x1shang/Chariot_strom_of_gear/docs/logs/2026-10-18-n20-jog-100/README.md

# v3.3 N20 100% 占空比与启动门槛实测（2026-10-18）

固件与接线沿用 v3.3：`ChariotIntegrated-v3.3-JOG`，STBY=GPIO21、AIN1/2=25/26、GPIO22 断开，c23–d26 下拉器件仍取下未恢复。**串口端口已由 COM4 变为 COM9（CH340）**，以下点动均在 COM9 执行，参数统一为 `--milliseconds 150 --direction 1`、N20 脱离滑轨空载、用户在场逐次确认。

## 原始记录与有效性

| 目录 | 指令 | 供电 | 有效性 / 用户观察 |
| --- | --- | --- | --- |
| `powered-100-150ms/` | `JOG 1 150 100` | **未接动力**（用户事后确认） | **作废**：目录名 `powered` 为误标，只证明 PWM/使能链路 |
| `powered-100-300ms/` | `JOG 1 300 100` | **未接动力**（同上） | **作废** |
| `powered-100-150ms-rerun/` | `JOG 1 150 100` | 动力接通 | 有效：**转了／明显动了一下** |
| `powered-50-150ms/` | `JOG 1 150 50` | 动力接通 | 有效：**不动，也没有声音** |
| `powered-65-150ms/` | `JOG 1 150 65` | 动力接通 | 有效：**抖一下／时转时不转（临界）** |
| `powered-75-150ms/` | `JOG 1 150 75` | 动力接通 | 有效：**转了** |

## 结果

| 占空比 | LEDC 回读 | 实物反应 |
| --- | --- | --- |
| 50% | 128 | 不动、无声 |
| 65% | 166 | 抖动 / 时转时不转（临界） |
| 75% | 191 | 转 |
| 100% | 256 | 转 |

**启动门槛约在 65%~75%（150ms、空载、6V 显示值）。** 全部 6 轮遥测一致：`feed=1 TB3=1`、到时自动 `feed=0 TB3=0 N20pwm=0,0`、`fault=none`、`error=null`。

## 结论（相对此前记录的改变）

1. **N20 不是死故障**：TB3 的 A 通道输出、STBY 使能、PWM 通路、电机本体在 75%~100% 下都工作正常。
2. **故障定性改为「启动占空比不足」**：此前的 `FEED_PERCENT=30` 根本起不动电机，这不是硬件损坏。
3. **此前“30%/50%/70% 全部无动作”的三轮不可直接采信**：本轮已出现过一次“以为接了动力、实际只插 USB”的情况，那三轮是否真接了动力没有独立证据。但不影响结论方向——50% 在真正带电时确认不动。
4. **R1 对接默认参数必须上调**：`FEED_PERCENT=30、FEED_PULSE_MS=150` 在实物上不会产生任何动作。建议改为 75%（留到 100% 的余量），并考虑把 `FEED_PULSE_MS` 提到 200~250ms。

## 仍未验证

- TB3 的 **VM 端实际电压**、AO1/AO2 输出电平、电机电流——全部未测量；6V 仍只是降压板显示值。
- 带负载（弹匣对接、滑轨啮合）时 75% 是否仍能起转，未测。空载门槛不能当作带载门槛。
- 门槛随电池电压下降会升高；当前结论只在本次 6V 显示值下成立。
- 未测反向（`direction -1`）的启动门槛。

## 下一步

1. 改 `RobotConfig.h`：`FEED_PERCENT` 30 → 75（暂定），必要时 `FEED_PULSE_MS` 150 → 250，重编译并烧录，再用 R1 实按验证。
2. 带负载复测：滑轨/弹匣装上后，用 75% 与 100% 各试一次，确认不堵转、不丢步。
3. 量 VM 端电压；若明显低于 6V，则先解决供电再谈占空比。

复现脚本为 `host/jog_integrated_n20.py`。该脚本会产生电机动作：必须先按实际供电状态选择 `--power-state off` 或 `n20-only`，带电测试还必须确认空载；不要仅为重放日志执行。`physical-observation.json` 记录用户逐轮现场观察。
