x1shang/Chariot_strom_of_gear/docs/logs/2026-10-17-flywheel-three-shots/README.md

# 2026-10-17：双 130 摩擦飞轮连续三次小球试射成功

**100% 占空比、每次总时长 10 秒（含 1200ms 软启动）、极性参数 `1/1` 下，连续三次小球试射成功，均由用户逐次现场确认。** 三份运行日志均记录 10000ms 到时归零、无 FAULT/ERR，最终 STOP 状态两路 DUTY、四个方向脚及底盘 STBY 为 0。

导航：[仓库首页](../../../README.md) · [飞轮固件](../../../firmware/catapult/FlywheelSpinTest/README.md) · [接线](../../抛投装置-双130摩擦飞轮接线与GPIO分配.md) · [程序索引](../../测试程序索引-2026-10-17.md)

## 本次条件与已完成工作

| 项目 | 记录 |
|---|---|
| 源码基线 | `6e504aac2346005b745225fb824368e8452147e3`，固件、主机工具及测试源码在该提交中已存在；本次未改动控制算法 |
| 固件 / 目标 | `FlywheelSpin-v3-100` / `esp32:esp32:esp32` / Arduino-ESP32 3.3.12 |
| 实机 | ESP32-D0WD-V3 rev3.1，MAC `08:a6:f7:a8:95:94`，本次 USB-SERIAL CH340 为 COM4 |
| 电源与电机 | L298N + 两台 130 摩擦飞轮电机；用户报告供电为 6V，额定电压未知，供电测量位置及方法未记录 |
| 命令 | `DIR 1 1`、`SPIN 100 10000`；每次运行前准备 10 秒，1200ms 爬升计入 10 秒总时长 |
| 满输出行为 | 写入 255，两路外设回读 256；v3 修正了此时被误判为故障的问题 |
| 编译 / 主机检查 | 编译通过：程序 285779 字节、全局变量 22384 字节；主机仿真 161 项检查通过，配套 Python 脚本语法通过 |
| 烧录 / 启动 | COM4 上传返回 0，写入哈希校验通过；启动 `hw=1 used=0 dirs=0`，两路输出与底盘 STBY 均为 0 |
| 执行方式 | 每次上电最多运行一次；前两次运行前复位并验证未使用状态，第三次初始已为 `used=0 dirs=0`，没有额外复位 |

## 三次结果与原始证据

| 次数 | 串口结果 | 用户现场确认 | 证据 |
|---|---|---|---|
| 1 | 10000ms 到时归零，脚本返回 0，最终 STOP 零输出 | “成功，再来一次，确定可以复现” | [准备及复位](prepare-100-10s.txt)、[运行日志](spin-100-10s.txt) |
| 2 | 10000ms 到时归零，脚本返回 0，最终 STOP 零输出 | “这次也成功了，帮我记录连续两次试射成功。” | [准备及复位](prepare-100-10s-retest.txt)、[运行日志](spin-100-10s-retest.txt) |
| 3 | 10000ms 到时归零，脚本返回 0，最终 STOP 零输出 | “这次也成功了，帮我记录连续三次试射成功。” | [运行前检查](prepare-100-10s-third.txt)、[运行日志](spin-100-10s-third.txt) |

三次为独立的单次运行，**不是连续运转 30 秒**。现场确认与串口证据分别支持“小球射出”和“命令执行及到时归零”，不能互相代替。

## 构建、烧录和校验材料

- [编译结果](compile.txt)、[161 项主机仿真输出](host-tests.txt)。
- [上传及写入哈希校验](upload.txt)、[烧录后启动回读](idle-after-upload.txt)。
- [上传阶段校验记录](upload-verification.json)：`motion_issued=false` 仅指烧录/空闲回读阶段，不表示后续没有执行试射。
- [本次结果及 SHA-256 清单](verification.json)：关联固件、主机工具、测试源码与上述原始证据；只保存文本，不保存固件映像、目标文件或测试可执行文件。
- 本目录的 `.gitattributes` 为原始 `.txt` 和上传阶段 JSON 禁用换行转换，以便从 Git 仓库取出文件后仍能逐字节复验哈希；摘要文档及结果清单使用 LF。

## 前期现象与未测项

此前 30%、45% 及部分 80% 测试中，用户多次反馈只有一台转动，曾报告接线问题；后续 80% 测试报告“都转了”，再进入上述三次试射。未完成电机/线束/通道交叉定位，**不据后续成功认定唯一故障根因**。完整前期排查记录保留在本机，本次上传聚焦三次成功的直接证据。

- 射程、发射角、球尺寸/质量、转速、电机电流和温升未测量或未记录；没有试射视频。
- 实际电机端电压、供电动态压降、额定电压、轮毂固定强度及长期运行能力未验证。
- 参数 `1/1` 三次一致，但没有独立记录两台电机的实际旋转方向。
- 三次成功是本次样本结果，不推算长期成功率，也不作为全车、长期可靠性或安全验收。
- 飞轮固件全程禁用底盘，不含手柄行驶控制或全车运动互锁。

本次仅整理和提交上述实测成果，没有追加运行电机。
