x1shang/Chariot_strom_of_gear/docs/logs/2026-10-17-飞轮100上限重烧录/README.md

# 2026-10-17 飞轮测试：100% 上限版本重新烧录

用户反馈此前 30% / 3000ms 测试中未观察到转动；该次机械转动验收未通过。此前串口无 FAULT/ERR 只说明固件回读符合预期，不排除动力供电、驱动板、电机、接线或机械故障。

用户更正供电来自降压模块的 5V，接在 L298N 的 5V 端子，跳帽全部断开；烧录前明确确认动力已断开。5V 为逻辑电源，VS/+12V 动力端是否另外供电仍待确认。两只 130 电机的额定电压未知。

- 固件升级为 `FlywheelSpin-v2-100`，占空比硬上限从 60% 改为 100%，主机脚本同步更新版本与上限。
- 默认仍为 30% / 3000ms；保留 1200ms 软启动、上电静止、一次/上电、限时、STOP、回读互锁与底盘禁用。
- 仿真 156 次状态检查通过，新增覆盖 100% 软启动、持续使能、到时归零、满输出 STOP，以及拒绝 101%/256%。主机脚本语法检查通过。
- COM10 芯片确认 ESP32-D0WD-V3 rev3.1，Flash 4MB。Arduino CLI 编译并上传返回 0，写入哈希校验通过。
- 烧录后回报 `BOOT FlywheelSpin-v2-100; idle; duty cap 100%`；`hw=1 used=0 dirs=0 phase=IDLE DUTY1=0 DUTY2=0 IN1=0 IN2=0 IN3=0 IN4=0 STBY=0`。
- **本次没有发送 SPIN/DIR，没有进行新的机械转动测试。** 等待用户确认动力端接线及恢复供电后，再逐档测试。

证据：[软件检查](software-checks.txt)、[编译与烧录](compile-upload.txt)、[烧录后回读](idle-after-upload.txt)、[源码哈希](verification.json)。
