x1shang/Chariot_strom_of_gear/docs/logs/2026-10-17-双130飞轮转动测试/README.md

# 2026-10-17 双 130 摩擦飞轮转动测试：编译、烧录与两次 30% 空载转动

方案变更背景：用户报告上次的发射装置方案**已失败（扭矩太大，电机被撕裂）**，决定改用**原驱动板 L298N 驱动两个 130 电机摩擦飞轮**。旧方案 77 个文件已归档，见[旧方案归档](../../archive/2026-10-17-L298N-N20卷线抛投/README.md)与[失败记录](../2026-10-17-卷线方案失败-电机撕裂/README.md)。

源码：[FlywheelSpinTest](../../../firmware/catapult/FlywheelSpinTest/README.md) · 主机：[flywheel_spin_once.py](../../../host/flywheel_spin_once.py) · 接线：[双 130 摩擦飞轮接线与 GPIO 分配](../../抛投装置-双130摩擦飞轮接线与GPIO分配.md)

## 已完成

- **归档**：旧方案（L298N + 双 N20 卷线蓄力）的程序、主机脚本、仿真测试、接线文档与全部 2026-10-14 证据共 **70 个方案文件 + 7 个链接目标 = 77 个文件**逐字节快照归档，`manifest.json` 逐个 SHA-256 校验，**缺失 0、不一致 0**。
- **仿真测试**：`tests/test_flywheel_spin_firmware.cpp` 用真实固件源码在主机侧跑通 **146 项检查**（g++ `-std=c++17 -Wall -Wextra`，无警告），覆盖软启动斜坡、占空比/时长硬上限、两轮同占空比、每次上电一次、`STOP` 在爬升与保持阶段都优先、PWM 与引脚回读互锁、空闲使能被外部拉高时拒绝运行、计时回绕、上电静止。
- **编译**：Arduino-ESP32 **3.3.12** 编译成功，程序 285735 字节（21%）、静态内存 22384 字节（6%）；编译用的临时 ASCII 路径源码与仓库源码 **SHA-256 逐字节一致**（`7bfb1923…919ad009`）。
- **烧录**：COM10（芯片 ESP32-D0WD-V3 rev3.1、Flash 4MB、MAC `08:a6:f7:a8:95:94`）上传 rc=0，应用映像 285888 字节，四个写入段全部收到 esptool 的 `Hash of data verified`。
- **烧录后回读**：`BOOT FlywheelSpin-v1`，`hw=1 used=0 dirs=0 phase=IDLE DUTY1=0 DUTY2=0 IN1..IN4=0 STBY=0`。上电不自动运动。
- **一次转动测试**：`DIR 1 1` → 8 秒准备 → 仅发一次 `SPIN 30 3000`。串口记录 `START SPIN duty=30% raw=77 ms=3000 ramp=1200ms dirs=1,1`，随后爬升段 17 个采样（raw 3 → 72），`HOLD duty=30% raw=77 elapsed=1200`，运行期 `DUTY1=DUTY2=77`、`IN1=IN3=1`、`IN2=IN4=0`、`STBY=0`，最后 `DONE SPIN elapsed=3000 DUTY1=0 DUTY2=0`。收尾 `STOP`/`STATUS` 回读 `used=1 phase=STOPPED DUTY1=0 DUTY2=0 全部方向脚 0 STBY=0`，串口关闭，无重试、无自动重复。
- **第二次转动（重测）**：会话之外的操作以同参数重跑一次，结果一致，见下文「第二次转动」。

## 证据

- [软件检查（仿真 + 主机语法）](software-checks.txt)
- [编译](compile.txt) · [烧录与写入校验](upload.txt)
- [烧录后空闲回读](idle-after-upload.txt)
- [会话内那一次转动的原始串口记录](spin-once.txt)
- [第二次转动（重测）的原始串口记录](retest-spin-once.txt)
- [源码/映像哈希、GPIO 与 PWM 参数、执行摘要](verification.json)

## 第二次转动（重测，会话之外执行）

本目录另有一份 [retest-spin-once.txt](retest-spin-once.txt)（09:00 写入）：同固件、同参数（`d1=1 d2=1`、30% / 3000ms、8 秒准备）的**第二次**转动记录。它**不是本次会话发出的命令**（本次会话只发过 1 条 `SPIN`），是会话之外的操作重跑了同一脚本的产物；两次之间板子被手动复位过（重测开局回读 `used=0`）。核对结果：

- 无 `FAULT`、无 `ERR`、无异常退出。
- 爬升段 16 个采样，`DUTY1=DUTY2` 从 5 单调升到 73，随后 `HOLD` 在 raw 77（30%）保持 24 个采样。
- `DONE SPIN elapsed=3000 DUTY1=0 DUTY2=0`，全程 `DUTY1 == DUTY2`（0 处不一致）、`STBY=0`、方向脚为 `IN1=IN3=1`、`IN2=IN4=0`。
- 收尾 `STOP`/`STATUS` 回读 `used=1 phase=STOPPED`、两路占空比与方向脚全 0。

**这两次都只是电气输出与计时证据**：仍然没有证明电机已接线、已转动、两侧对转，也没有电流与温升数据。**两次合计共发出 2 条 `SPIN` 命令，每次都各自 "每次上电仅一次" 生效，中间靠复位重新授权。**

## 证据边界（不要把这些写成已确认）

- `DUTY1/DUTY2` 是 `ledcRead()` 的**外设（已命令占空比）回读**，**不证明引脚电平、电机端电压或实际电流**；方向脚与 STBY 才是真实引脚电平回读。
- 本次**没有测量**任何机械量：130 电机是否已接到 OUT1/OUT2 与 OUT3/OUT4、是否真的转动、转向、转速、两侧是否对转、飞轮是否装好、有无异响与振动，全部需要现场观察。
- 本次**没有测量电流与温升**。飞轮启动是惯性负载、起始电流大，L298N 每路 2A 只是直流绝对最大额定值；提高占空比前必须先限流并监视电流与散热片温度。
- `d1=1 d2=1` 是**实验值**：两侧飞轮必须反向旋转才算有效发射方向，这一点尚未观察确认，不能写成「顺时针/逆时针已确认」。
- 撤销使能是**滑行停止**：`DONE`/`STOP` 之后飞轮仍在惯性旋转，不是已经停转。
- 本方案**没有编码器，没有转速或位置反馈**；旧 FOC 方案的 90° 定位/自动返回不再适用。

## 板上当前状态

板上固件为 `FlywheelSpin-v1`：只支持 `STATUS` / `STOP` / `DIR <d1> <d2>` / `SPIN [duty] [ms]`，每次上电只允许一次转动，两路 EN 默认 0。**底盘在该固件下不行驶**（STBY 全程为低、不含手柄控制）；要恢复行驶需重新烧录底盘固件（[MecanumPS2Dpad](../../../firmware/chassis/MecanumPS2Dpad/README.md) 或 `tools/build-chassis.ps1`）。

## 下一步（需现场与仪表）

1. 记录两台 130 电机的铭牌与额定电压；确认动力分支电压是否仍用 12V。
2. 装配飞轮、轮毂（D 形/紧定/夹紧两处固定）、电机座防松与护罩。
3. 先分别单侧低速试转确认可转与转向，再确认两侧**对转**方向，记录极性。
4. 限流条件下逐级升速（30% → 45% → 60%），每级记录电流、温升、振动；超限则重新评估驱动板。
5. 第 3–4 步全部正常后再加球试射，按目标城墙高度与距离调整间隙/压入量与占空比上限。
