x1shang/Chariot_strom_of_gear/docs/logs/2026-10-14-restore-dpad/README.md

# 2026-10-14：恢复原 PS2 方向键底盘驱动

用户明确要求将原遥控小车源码重新烧录，并保存刚才的测试代码。

## 已完成

- 原`MecanumPS2Dpad`源码及两个头文件完整复制至英文临时路径进行编译，沿用`DRIVE_DUTY=255`、原GPIO和已校准轮向，未修改行驶代码。
- 实际固件仿真通过：方向键映射、GPIO极性、松键停机、松键重新就绪、圆圈/串口STOP、失效/超时帧、换向与计时回绕。
- Arduino-ESP32 3.3.12编译成功：程序284047字节、静态内存22440字节；应用映像284192字节。
- COM9上传成功，芯片ESP32-D0WD-V3 rev3.1、MAC 08:a6:f7:a8:95:94；esptool写入哈希验证成功。
- 启动回读确认`BOOT MecanumPS2Dpad`，随后`hw=1 ps=1 mode=73 buttons=0000 ready=1 STBY=0 duty=0,0,0,0`。只发送STOP/STATUS，无运动命令；串口已关闭。
- PS2信号诊断、2号顺时针3秒、2号逆时针10秒、双N20顺序测试及对应主机脚本/仿真代码全部保留在原目录。11个测试源文件的SHA-256在烧录前后核对一致。

当前板上为原方向键底盘固件，松开全部按键后就绪，方向键控制底盘，圆圈停止。L298N的ENA=14与ENB=27在初始化时保持低；不含N20抛投控制。此为启动/收包/静止验证，没有新增带载运动验收。

## 保存的测试代码

完整入口：[测试程序保留索引](../../测试程序索引-2026-10-14.md)。源码在各自独立目录中，相关日志保留原始内容；临时构建产物可重新生成。

证据：[编译](compile.txt) · [上传](upload.txt) · [启动回读](startup.txt) · [原驱动/测试源码与映像哈希清单](verification.json)

[原驱动说明](../../../firmware/chassis/MecanumPS2Dpad/README.md) · [仓库总入口](../../../README.md)
