x1shang/Chariot_strom_of_gear/docs/排位赛战绩与小组赛备赛-2026-10-20.md

# 排位赛战绩与小组赛备赛（齿轮风暴队 · 80 号）

> 2026 新生机械赛 · 排位赛 2026-10-17/18 · 小组赛 2026-10-25
> 记录时间：2026-10-20

## 一、结果

**109 队参赛，前 64 队进小组赛；齿轮风暴队（80 号）以 190 分排第 43 名，晋级 64 强，分入 K 组。**

| 项 | 数据 |
| --- | --- |
| 排位赛总分 | 190 分（两次上场，各 3 分钟，取两次之和） |
| 排名 | 43 / 109 |
| 得分构成 | 中央区及甬道 180 分；其余 10 分仍是地面球；**高空投石 0 分** |
| 小组赛 | K 组 · 10-25（周日）10:20–11:10 · 场地 1 |
| 同组 | 14 啊对对对队 1415（#11）· 68 交虫战队 790（#22）· 16 感觉很队 120（#54） |

同分对照：与 66 号机机队同为 190 分，靠“中央区及甬道 180 > 150”排在前面。

## 二、现场发现

1. **射速不够**：单位时间出球数上不去，6 球一轮的节奏撑不起 5 分钟对抗。
2. **高程不够**：黄球过不了 600 mm 中央城墙，落不进外城（30）/内城（50）/瞭望塔（70），只能靠地面穿孔拿 10 分/球。

**现场处置**：直接垫木片抬高发射角 + 加大电压提高飞轮转速。分数仍以地面球为主，说明“抬高 + 加压”只把弹道往上推了一点，还没到能稳定过墙的量级（效果未量化，待复测）。

## 三、下一步计划

| # | 动作 | 目的 | 验收指标 |
| --- | --- | --- | --- |
| 1 | 更换电机 | 提高飞轮线速度 | 同电压下球速↑、过墙率↑ |
| 2 | L298N ↔ TB6612 对调 | L298N 有 1.8–3 V 固定压降；飞轮改由压降更小的 TB6612 驱动，把电压真正加到电机上。**注意：底盘是 4 路独立（2×TB6612），L298N 只有 2 路，整块互换不成立**；实际做法是飞轮单独用一块 TB6612、L298N 退役 | 电机端电压实测；同占空比下的球速对比 |
| 3 | 继续垫高平台 | 增大发射角 | 分角度测过墙率与落点分布 |

三项都指向同一件事：**让黄球过墙**。黄球只要进外城就是 30 分/球，效率是地面球的 3 倍。

按排位赛效率粗算：14 号 6 分钟拿 1415 分（约 236 分/分钟），5 分钟对抗即使打折也是 700–1000 分级别。我们纯地面球（10 分/球）要 70–100 球才追平，靠黄球进外城（30 分/球）只要 25–35 球；而每轮最多只让带 3 个黄球，所以**“过墙率 × 循环次数”就是全部**。

改法上建议**一次只动一个变量**：先电压 + 角度（不动机械）测过墙率 → 再换电机 → 最后继续调平台高度；否则过墙率上去了也说不清是哪一项的功劳。

## 四、红线（车检 / 规则）

- 电路任意两点电压 ≤ **12 V**；小球出射速度 ≤ **15 m/s**。
- 静态尺寸 ≤ 400×400×**350** mm，动态 ≤ 500×500×450 mm；**垫高平台会先顶到 350 mm 静态高度，改完先量再上车检**。
- 整车 ≤ 3 kg；飞轮启动电流接近堵转电流，TB6612 单路连续 1.2 A，注意限流与散热。

## 五、K 组形势

| 编号 | 队伍 | 排位分 | 排名 |
| --- | --- | --- | --- |
| 14 | 啊对对对队 | 1415 | 11 |
| 68 | 交虫战队 | 790 | 22 |
| **80** | **齿轮风暴队（我们）** | **190** | **43** |
| 16 | 感觉很队 | 120 | 54 |

赛程（10-25，场地 1，单循环 6 场）：

| 时间 | 对阵 |
| --- | --- |
| 10:20 | 14 vs 16 |
| 10:30 | 68 vs **80** |
| 10:40 | 14 vs **80** |
| 10:50 | 16 vs 68 |
| 11:00 | 14 vs 68 |
| 11:10 | **80** vs 16 |

- 每组只有**第一名**进淘汰赛（16 组 → 16 队）。14 是组内头号种子，**10:40 对 14 基本就是出线生死战**。
- 三场在 50 分钟内打完：电池、备件、快修按“连续三场”准备。
- 侦察窗口：10:20 可先看 14 打 16；10:50、11:00 可看 16 和 68。我们自己的 10:30 那场之前没有 68 的现场情报。

## 六、备赛清单（按优先级）

1. **黄球过墙率（最高优先）**：在真实 600 mm 墙、真实距离下打 20 发记落点，目标外城命中 ≥ 50%。
2. **6 球循环时间**：回填区出发 → 6 球打完 → 回填，目标 ≤ 25 s；按 5 分钟 10–12 轮估总分。
3. **地面球保底**：正门 120×180、侧门 80×140（甬道），10–15 分/球，作为下限分。
4. **防守**：回填间隙把车停在己方正门前挡地面球；黄球落进己方城内/塔上拦不住，只能压缩对方出手次数。
5. **稳定性**：连续三场不烧板、不掉线、不松轮；带备用 130 电机、飞轮、驱动板、电池。
6. **车检预演**：尺寸、重量、电压、球速、走线，按手册 3.7 节逐条过。

## 七、备注

- 排位赛成绩表**未改动**：核对后名单与成绩都是 109 队、编号 1–109 一一对应，没有“多出来的 3 队”，因此没有追加“未通过车检”行（按确认跳过）。
- `排位赛名单及时间表(1).xlsx` 已按要求移入回收站。
- 数据来源：`排位赛比赛成绩.xlsx`、`小组赛时间表.xlsx`、`2026新生机械赛赛事手册.pdf`。
