x1shang/Chariot_strom_of_gear/docs/整合程序v3-R1对接器-2026-10-18.md

# 整合程序v3：R2飞轮、R1定时N20对接器，无舵机

> **当前程序为ChariotIntegrated-v3.1-R1。** v3.0的USB静止检查通过后，实际按上方向键触发drive frequency故障。v3.1改为直接查询LEDC实际定时器，保留频率异常停机，并增加持久故障原因。最新证据见[遥控响应记录](logs/2026-10-18-controller-response/README.md)，本文末尾的v3.0静止检查作为历史保留。

日期：2026-10-18。用户报告已完成改接线，并要求烧录完整版；已明确确认全部电机动力断开、ESP32仅接USB，外部5V到ESP32正极已隔离。用户选择R1“点按后运行固定时间”，当前没有舵机。

## 仓库同步与阅读

已实际执行`git fetch origin master`及`git pull --ff-only --autostash origin master`，本地从19105db快进到9a11db22ac06d6c2f64c0cb23fb420198a7165ef，HEAD与origin/master一致。原有修改自动恢复；拉取前两份本地文档另有备份，未覆盖既有未跟踪整合代码。这是烧录前的拉取基线；本页不作为后续推送状态记录。

已阅读现行双130接线、底盘两线法、全车供电索引、逐根改接线说明、v2对齐说明，以及本次pull得到的MecanumPS2Flywheel代码和README。原仓库的MecanumPS2Flywheel-v2仍使用六根飞轮信号，不能直接烧到当前合并双EN的新接线上。

当前入口是`firmware/robot/ChariotIntegrated/ChariotIntegrated.ino`，版本`ChariotIntegrated-v3.1-R1`。DpadControl.h和DriveMath.h继续与当前远程底盘/转向基线逐字节对齐。

## 当前操作

| 操作 | 行为 |
|---|---|
| 松开所有按键，右摇杆回中，连续5帧 | 自动ready/armed，不需要START |
| 方向键 | 前后、横移、斜移，保留原轮向、100%目标、加速斜坡和300ms换向等待 |
| 右摇杆横轴 | 比例转向，可与方向键叠加；中位128、死区±20 |
| 按住R2 | 双130从0经1200ms爬升至100%，最多10秒；可与驾驶并行 |
| 松开R2 | 撤销飞轮输出，飞轮惯性滑行；若N20此次动作在飞轮运行时启动，也一并撤销 |
| 停车后点按R1 | N20按配置方向输出150ms、30%占空比，松开R1仍运行到时限；无需先按R2 |
| 一直按住R1 | 只触发一次，不连发；上次停止后至少800ms，再次松开并点按才接受 |
| 飞轮已运行时点R1 | 必须已预转2500ms；预转未完成或车辆在行驶时拒绝，不排队 |
| N20动作中出现驾驶输入 | 所有电机停止并锁定，须重新松键回中 |
| 圆圈或串口STOP | 全部电机撤销输出并锁定，重新松键回中后就绪 |
| 无效手柄帧、150ms无有效帧 | 全部电机撤销输出并锁定 |
| SELECT、L1、叉 | 本版不控制机构；GPIO27不输出舵机脉冲，SERVO ON也被拒绝 |

R1是定时动作，不是到位控制；150ms和30%是原配置的调试初值，不能保证滑轨完成对接。需现场确认方向和行程，调整RobotConfig.h的FEED_POLARITY、FEED_PULSE_MS、FEED_PERCENT，再编译烧录；手柄脉冲不得超过FEED_JOG_MAX_MS（当前500ms）。未实现到位传感器或卡滞检测。

## 与本次实际接线的对应

| 功能 | 接线 |
|---|---|
| 双飞轮使能 | GPIO14经第20排分到L298N ENA和ENB；两个EN跳帽取下 |
| 使能默认关闭 | 第20排b20经一只10kΩ到第26排e26；合并EN共用下拉即可 |
| 飞轮方向 | L298N IN1/IN3接ESP32同源3V3；IN2/IN4接GND |
| N20方向与使能 | GPIO25/26/22分别接TB3 AIN1/AIN2/STBY；STBY有另一只10kΩ下拉 |
| N20逻辑与输出 | TB3 VCC/PWMA=3V3；BIN1/BIN2/PWMB=GND；AO1/AO2接N20 |
| 地线 | 第26排左右侧各从ESP32 GND引入；TB3和L298N功率GND各自直接回降压板GND，不经面包板 |
| L298N逻辑电源 | 5V-EN取下，外部降压板5V-OUT接L298N 5V |
| 动力接线状态 | 用户报告TB3 VM已接VADJ-OUT、L298N动力正极已按原位置恢复；本次烧录时全部动力断开 |
| 舵机 | 未安装，GPIO27留空或仅保留a24引线；SERVO_INSTALLED=false |
| 保留脚 | GPIO21不用；底盘和PS2接法保持原样 |

电机线重新插接过，两台130是否相向送球、N20是否向对接方向运动均需重新点动核对。程序状态、PWM占空比和150ms到时均不代表实测电压、电流、转速、温升或机械到位。N20具体型号及VADJ实际电压仍未取得仪器/铭牌记录。

## 烧录和检查范围（以下v3.0初始化修复为历史记录）

本次先执行主机回归和Arduino-ESP32 3.3.12实际编译。烧录前后记录源码/二进制哈希；只在用户确认动力断开、ESP32仅接USB后操作COM4。启动检查脚本`host/verify_integrated_after_upload.py`只发送STOP与STATUS，不发送任何动作命令。

首次启动发现hw=0：原初始化代码在零占空比时检查ledcReadFreq，但本机3.3.12的esp32-hal-ledc.c第408–417行明确在占空比为0时返回频率0，导致误判。已保留失败日志，修正为初始化检查attach、写0成功与占空比回读0；只在用户请求非零输出时检查频率。主机stub也改为同样的零占空比返回行为，并覆盖运行期错误频率时停机的情况。初始化不为测频而产生非零脉冲。

实际结果见[本次记录](logs/2026-10-18-integrated-r1/README.md)。旧v1/v2日志和桌面ZIP保留其原版本含义，不能当本版烧录证据。

## v3.1当前结果

681项主机检查、实际编译、写入校验及USB启动通过。随后断动力采样确认方向键/左右转向输入；底盘有动力且四轮架空采样无故障，用户确认“四轮都有响应，松开后停止”。最后STOP回读全部电机输出为0。130和N20本轮动力保持断开，没有完成它们的实物动作验收。完整证据与当前源码哈希见[最新记录](logs/2026-10-18-controller-response/README.md)。
