x1shang/Chariot_strom_of_gear/docs/测试程序索引-2026-10-17.md

# 2026-10-17 测试程序索引：130 摩擦飞轮方案

**方案变更（2026-10-17）**：用户报告上次的发射装置方案（L298N + 双 N20 卷线蓄力）**已失败，原因是扭矩太大、电机被撕裂**，决定改用**原驱动板 L298N 驱动两个 130 电机摩擦飞轮**，新写一则测试飞轮转动的程序并烧录。旧方案的全部测试程序已逐字节归档，见[旧方案归档](archive/2026-10-17-L298N-N20卷线抛投/README.md)（70 个方案文件 + 7 个链接目标 = 77 个文件，逐个 SHA-256 校验：缺失 0、不一致 0）。

上一版索引（2026-10-14，含旧方案程序清单）保留原文并已随批归档：[测试程序索引-2026-10-14](测试程序索引-2026-10-14.md) · [归档快照](archive/2026-10-17-L298N-N20卷线抛投/snapshot/docs/测试程序索引-2026-10-14.md)。

导航：[仓库总入口](../README.md) · [双 130 摩擦飞轮接线与 GPIO 分配](抛投装置-双130摩擦飞轮接线与GPIO分配.md) · [卷线方案失败记录](logs/2026-10-17-卷线方案失败-电机撕裂/README.md)

## 1. 当前测试程序（新方案）

| 测试程序 | 行为 | 记录 |
|---|---|---|
| [FlywheelSpinTest](../firmware/catapult/FlywheelSpinTest/README.md) | 当前 v3：两侧 130 飞轮同时软启动到指定占空比（1–100%，默认 30%），总时长≤10000ms（含1200ms爬升），到时或 `STOP` 撤销两路 EN；每次上电仅一次；**底盘不行驶** | [100% / 10秒连续三次试射成功](logs/2026-10-17-flywheel-three-shots/README.md)（用户逐次确认）；[此前重烧录](logs/2026-10-17-飞轮100上限重烧录/README.md)为历史 |

- 主机脚本：[`host/flywheel_spin_once.py`](../host/flywheel_spin_once.py)（执行前核对状态、只发一次、退出必发 `STOP`、不重试、全程留日志）。
- 仿真测试：[`tests/test_flywheel_spin_firmware.cpp`](../tests/test_flywheel_spin_firmware.cpp)（本机 **161 项检查通过**，含写入 255 / 满输出回读 256 的回归验证，见[原始输出](logs/2026-10-17-flywheel-three-shots/host-tests.txt)）。
- 测试桩变更：`tests/firmware-stubs/Arduino.h` 新增 `ledcRead`，用于固件的 PWM 占空比回读检查。

## 2. 已归档的旧方案测试程序（2026-10-14，停用）

以下程序源码**保留在原目录**用于追溯，模块 README 已标注停用；归档目录另有逐字节快照。

| 测试程序（快照） | 行为 | 记录（快照） |
|---|---|---|
| [N20Motor2DirectionCheck](archive/2026-10-17-L298N-N20卷线抛投/snapshot/firmware/catapult/N20Motor2DirectionCheck/README.md) | 仅2号顺时针3秒；1号和底盘禁用 | [3秒与重复测试](archive/2026-10-17-L298N-N20卷线抛投/snapshot/docs/logs/2026-10-14-n20-motor2-check/README.md) |
| [N20Motor2Reverse10s](archive/2026-10-17-L298N-N20卷线抛投/snapshot/firmware/catapult/N20Motor2Reverse10s/README.md) | 仅2号逆时针10秒；1号和底盘禁用 | [10秒测试](archive/2026-10-17-L298N-N20卷线抛投/snapshot/docs/logs/2026-10-14-n20-motor2-ccw10s/README.md) |
| [N20SequenceTest](archive/2026-10-17-L298N-N20卷线抛投/snapshot/firmware/catapult/N20SequenceTest/README.md) | 2号3秒→1号0.5秒；旧机构的两阶段「蓄力→释放」 | [顺序测试](archive/2026-10-17-L298N-N20卷线抛投/snapshot/docs/logs/2026-10-14-n20-sequence-test/README.md) |
| [PS2SignalCheck](archive/2026-10-17-L298N-N20卷线抛投/snapshot/firmware/chassis/PS2SignalCheck/README.md) | 仅读遥控器帧/按键，所有电机禁用（**通用诊断，未停用**） | [信号检查](archive/2026-10-17-L298N-N20卷线抛投/snapshot/docs/logs/2026-10-14-ps2-signal-check/README.md) |

旧主机脚本（归档快照）：[2号顺时针单次](archive/2026-10-17-L298N-N20卷线抛投/snapshot/host/motor2_forward_once.py)、[2号逆时针单次](archive/2026-10-17-L298N-N20卷线抛投/snapshot/host/motor2_counterclockwise_once.py)、[双电机顺序单次](archive/2026-10-17-L298N-N20卷线抛投/snapshot/host/n20_sequence_once.py)。旧仿真测试（归档快照）：[2号顺时针](archive/2026-10-17-L298N-N20卷线抛投/snapshot/tests/test_n20_motor2_firmware.cpp)、[2号逆时针](archive/2026-10-17-L298N-N20卷线抛投/snapshot/tests/test_n20_motor2_reverse_firmware.cpp)、[顺序控制](archive/2026-10-17-L298N-N20卷线抛投/snapshot/tests/test_n20_sequence_firmware.cpp)、[遥控信号](archive/2026-10-17-L298N-N20卷线抛投/snapshot/tests/test_ps2_signal_check.cpp)。

## 3. 没有归档的部分（仍在使用）

- 底盘固件与诊断：`firmware/chassis/MecanumPS2Dpad`、`MecanumPS2*Diagnostic`、`TB6612LogicCheck`、`PS2SignalCheck`（后者另有归档快照，原目录继续维护）。
- 底盘主机脚本与诊断记录：`host/` 下非抛投脚本、`docs/diagnostics/`、`docs/logs/2026-10-14-controller-wheel-check/`、`docs/logs/2026-10-07*`。
- 旧 FOC 方案（DRV8313/AS5600）：更早已归档，见[2026-10-14 归档](archive/2026-10-14-DRV8313-AS5600/README.md)。

## 4. 板上的固件

板上当前为 `FlywheelSpin-v3-100`（本次端口 COM4，上限 100%）。它**只支持飞轮测试**，底盘不行驶；要恢复行驶需重新烧录底盘固件（[MecanumPS2Dpad](../firmware/chassis/MecanumPS2Dpad/README.md)）。本次编译、烧录及回读通过，随后完成三次 100% / 10 秒运行，用户逐次确认小球试射成功；源文件、主机脚本及证据哈希见[本次清单](logs/2026-10-17-flywheel-three-shots/verification.json)。

## 5. 结论

- 旧方案的测试程序、主机脚本、仿真测试、接线文档与全部 2026-10-14 证据已完整入档，且哈希可复验（77 个文件，缺失 0、不一致 0；其中 7 个是为保持快照内链接可读而保存的链接目标）。
- 当前 v3 完成 **100% / 10 秒连续三次小球试射成功（用户现场确认）**，三次日志均无 FAULT/ERR 且输出到时归零。射程、独立转向、转速、电流/温升、装配强度及长期可靠性仍未测量，详见[本次记录](logs/2026-10-17-flywheel-three-shots/README.md)。早期 30% 测试及单台不转现象作为历史保留，不据本次成功推断其唯一根因。
