x1shang/Chariot_strom_of_gear/docs/测试程序索引-2026-10-14.md

# 2026-10-14 测试程序保留索引

恢复原 PS2 方向键底盘驱动时，以下测试源码、主机脚本、仿真测试与日志继续保留，可按需重新编译烧录。恢复驱动不删除测试代码，也不将其合并到行驶固件中。

| 测试程序 | 行为 | 记录 |
|---|---|---|
| [PS2SignalCheck](../firmware/chassis/PS2SignalCheck/README.md) | 仅读遥控器帧/按键，所有电机禁用 | [信号检查](logs/2026-10-14-ps2-signal-check/README.md) |
| [N20Motor2DirectionCheck](../firmware/catapult/N20Motor2DirectionCheck/README.md) | 仅2号顺时针3秒；1号和底盘禁用 | [3秒与重复测试](logs/2026-10-14-n20-motor2-check/README.md) |
| [N20Motor2Reverse10s](../firmware/catapult/N20Motor2Reverse10s/README.md) | 仅2号逆时针10秒；1号和底盘禁用 | [10秒测试](logs/2026-10-14-n20-motor2-ccw10s/README.md) |
| [N20SequenceTest](../firmware/catapult/N20SequenceTest/README.md) | 2号3秒→1号0.5秒→停止；未来两台顺时针极性为DIR -1 1 | [顺序测试与方向确认](logs/2026-10-14-n20-sequence-test/README.md) |

主机脚本：[2号顺时针单次](../host/motor2_forward_once.py)、[2号逆时针单次](../host/motor2_counterclockwise_once.py)、[双电机顺序单次](../host/n20_sequence_once.py)。每次只有一次运动命令，无自动重试。

仿真测试：[2号顺时针](../tests/test_n20_motor2_firmware.cpp)、[2号逆时针](../tests/test_n20_motor2_reverse_firmware.cpp)、[顺序控制](../tests/test_n20_sequence_firmware.cpp)、[遥控信号诊断](../tests/test_ps2_signal_check.cpp)。

本次恢复烧录的源程序：[MecanumPS2Dpad](../firmware/chassis/MecanumPS2Dpad/README.md)。该程序只控制底盘方向键行驶，L298N两路使能保持低，不能同时执行以上N20测试。

保留文件的SHA-256清单与恢复烧录证据见[恢复记录](logs/2026-10-14-restore-dpad/README.md)和[verification.json](logs/2026-10-14-restore-dpad/verification.json)。源码保留在各自原目录，临时构建产物无需随代码保存，均可重建。
