x1shang/Chariot_strom_of_gear/docs/投掷机构-设计与安全.md

# ESP 小车项目 —— ESP32 + 2804 无刷电机 (FOC)（已归档）

2026-10-14：用户报告 DRV8313 已烧坏，原 2804 无刷 + DRV8313 + AS5600 方案停用，改用 L298N + 两台 N20，采用 12V 动力方案。

- [查看归档原文](archive/2026-10-14-DRV8313-AS5600/snapshot/docs/投掷机构-设计与安全.md)
- [旧方案归档索引](archive/2026-10-14-DRV8313-AS5600/README.md)
- [当前 L298N 双 N20 接线与 GPIO 分配](抛投装置-L298N双N20接线与GPIO分配.md)
- [2026-10-14 实机抛投四项失败记录](logs/2026-10-14-throw-test/README.md)
- [仓库总入口](../README.md)

原文及相关实测证据完整保留在归档中；原路径保留此导航供已有引用使用。旧接线、FOC 校准和运动指令不适用于新方案。
