x1shang/Chariot_strom_of_gear/docs/麦轮TB6612分步验收记录-2026-10-06.md

> **2026-10-14 方案变更：** 本文的 DRV8313 / 2804 / AS5600 抛投接线与 FOC 结论已归入[旧方案档案](archive/2026-10-14-DRV8313-AS5600/README.md)。新抛投采用 [L298N + 双 N20](抛投装置-L298N双N20接线与GPIO分配.md)；历史实测保留，当前引脚与供电以新方案为准。

# 麦轮 TB6612 分步验收记录

日期：2026-10-06（Asia/Shanghai）。依据：[接线与分步验收](麦轮TB6612接线与面包板排线.md)。本次完成串口检查及现有固件诊断，**整机验收未完成，不能判定各端子正常**。

## 最新进度：左前轮首次点动已执行

用户确认“架空 断开 开始测试”。先读取待机状态正常，再发送 `JOG FL 64 400`：目标占空比64/255≈25.1%，含软启动，400ms自动结束。串口确认命令接受，采样到control=JOG、STBY=1、duty=9,0,0,0，随后报告JOG DONE/STOP并恢复LOCKED、STBY=0、四轮指令全0。500ms状态采样未捕获整段PWM变化，不能据此断言实测峰值为64。

用户反馈：**没有轮子转动**，首次点动未通过。暂停其他轮点动及提高占空比，优先检查D1器件端VM-GND实测电压、电源是否限流及电机额定电压。真实轮速、电流、温升无传感器读数，电机额定电压/VM/限流具体值仍未提供。证据：[首次左前轮点动日志](logs/mecanum-fl-jog-2026-10-06.txt)。

## 前序进度：麦轮＋PS2固件烧录

用户上报D1、D2的VCC/PWMA/PWMB/STBY均为3.2/3.2/3.2/0.4V，并表示VM已接通。此为用户端子测量，不是串口测得；STBY实测0.4V原样保留，不能写成0V。下载/复位瞬态仍未测。

按用户要求，本阶段不处理AS5600，仅实现独立麦轮和PS2控制，投掷输出保持禁用。

- 已新增并烧录 [MecanumPS2](../firmware/chassis/MecanumPS2/MecanumPS2.ino)，已替换上一版TB6612LogicCheck。操作见[固件说明](../firmware/chassis/MecanumPS2/README.md)。
- 编译成功，Flash占用302739字节；烧录数据校验通过。
- 主机测试覆盖混控方向/幅值、零输入、换向减速及300ms等待、STOP方向历史和计时回绕，全部通过。
- 板上返回hw=1、ps=1、mode=41、buttons=0000、control=LOCKED、STBY=0、duty=0,0,0,0。
- 串口STOP通过；占空比77、时长801ms和未知命令均被拒绝，保持锁定。没有用这些测试证明真实运动中的停车性能。
- 启动日志TWDT already initialized是核心已初始化看门狗后本程序转为reconfigure的提示；hw=1表示重新配置及用户注册成功。未实际注入卡死来验看门狗。
- 已询问四轮是否架空、投掷动力是否仍断开，以及电机额定电压、VM电压和限流。等待回复，尚未发送有效点动命令、解锁遥控或确认真实轮子转动。
- PS2失联停止、逐轮正负方向、实际电流/温升、遥控混控运动仍待实物验收。本版没有主动短路制动，原第4步制动验收仍未完成。

原始证据：[麦轮PS2日志](logs/mecanum-ps2-2026-10-06.txt)。

## 历史续测：第2步逻辑验收

用户回复“已完成、短路检查通过，请你继续下一步操作”，确认前述动力/USB供电隔离与断电检查。无具体阻值、端子电压或电机参数上报，因此不据此填写数值或认定电机适配通过。

- COM9 实测芯片 ESP32-D0WD-V3 revision v3.1、4MB Flash。
- 新增并成功编译、烧录 [TB6612LogicCheck](../firmware/chassis/TB6612LogicCheck/TB6612LogicCheck.ino)，使用 Arduino ESP32 3.3.12；烧录校验成功。**当前板上已替换为该第2步专用固件，原PS2Catapult源码保留。**
- 固件不提供使能/运动功能。复位后持续保持 GPIO33、GPIO14、八个底盘IN、投掷25/26/27低电平。未使用PWM或SimpleFOC。
- 硬件复位后成功启动，首条状态 uptime_ms=21，STBY33=0、EN14=0、pads_low=1；其后采样全部一致，八个底盘IN回读均为0。
- STATUS、STOP得到预期回复；非法ARM及超长行均拒绝并保持禁用。这只验证已禁用状态下的命令处理，不代表已验证运动中的停车能力。
- 尚未验证两块板端子电压、下载/复位期间瞬态、人工断电冷启动、看门狗复位或PS2断联保护。日志中的POWERON_RESET来自RTS硬件复位，不是人工冷启动记录。
- 当前固件不轮询PS2/AS5600，先前AS5600失败结论未被本轮测试消除。

原始证据：[第2步日志](logs/tb6612-stage2-2026-10-06.txt)。已向用户请求两板各VCC/PWMA/PWMB/STBY共8个电压读数；收到后才能继续评定第2步。第3–5步仍未执行，不能向电机接入动力开展点动验收。

## 首轮实测（烧录前，历史记录）

| 项目 | 结果 | 证据与边界 |
|---|---|---|
| USB串口 | 通过 | COM9，CH340，VID:PID=1A86:7523；115200 baud 连续读出有效文本，发送 d 收到诊断回复 |
| 当前固件 | 与 PS2Catapult 输出和 d 命令行为一致 | state=0，对应源码 LOCKED；未进行二进制一致性校验 |
| PS2在线通信 | 当前采样通过 | 初始5秒10帧均 PS2=1、mode=41、buttons=0000；未验按键映射及断联撤销使能 |
| AS5600通信 | 未通过 | 100k/50k/10kHz 下均 addr36_error=2、angleOK=0、statusOK=0；总线恢复后仍失败 |
| 编码器角度/磁铁 | 无有效结论 | enc=0、magnetOK=0；153°为缓存，不是有效实时角度，也不能单独判定磁铁不合格 |
| TB6612端子/电源/四轮 | 待现场实测 | 当前固件未实现两线法底盘控制，也无端子电压、电流或温度采样 |

原始输出：[串口日志](logs/tb6612-acceptance-2026-10-06.txt)。本次未烧录、未主动复位、未发送校准/使能/运动命令，工具返回时已关闭串口。锁定状态只说明现有投掷控制逻辑，不能证明 GPIO33 或两板 STBY 的实际电平。

## 按原文第6节逐步验收

| 步骤 | 状态 | 完成条件/待补证据 |
|---|---|---|
| 1 断电检查 | 用户确认已完成、短路检查通过；电机参数待补 | 动力与USB供电隔离已确认；具体阻值未上报，电机额定电压、堵转电流及电源限流仍待提供 |
| 2 仅逻辑供电 | 下载/复位后主控低电平回读通过；端子待测 | 第2步固件已烧录；需测两板VCC、四个PWM约3.3V，两板STBY约0V；人工冷启动和下载/复位瞬态仍待外部测量 |
| 3 逐轮点动 | 未执行 | 需匹配两线法的固件；前两步通过、四轮架空、投掷动力隔离、合适限流电源后，记录FL/RL/FR/RR各轮短时低占空比点动的方向、电流及温升 |
| 4 滑行/制动/待机/换向 | 未执行 | 低速逐项验证两IN低、两IN高及STBY低的实际行为，并验证减速后换向 |
| 5 停止/断联/复位/整车运动 | 未执行 | 验证停止命令、PS2断联、复位撤销使能和物理断电；单轮通过后再验前后/横移/旋转；投掷集成前修复AS5600并验证互锁 |

旧 MotorDriver/MotorLinkCheck 使用 QGPMaker 接口；PS2Catapult 没有 TB6612 初始化或四轮控制，不能拿这些固件的状态行充当底盘验收。

## 下一步现场回填

动力隔离及USB供电隔离已确认。现在保持仅逻辑供电，使用直流电压档测下表，黑表笔接已确认公共地，红表笔测器件端。如需复查通断/电阻，先全部断电，不在带电状态使用电阻或蜂鸣档。

| 测点 | 实测 |
|---|---|
| D1 VCC / D2 VCC | 用户实测3.2 / 3.2 V |
| D1 PWMA / PWMB | 用户实测3.2 / 3.2 V |
| D2 PWMA / PWMB | 用户实测3.2 / 3.2 V |
| D1 STBY / D2 STBY | 用户实测0.4 / 0.4 V |
| AS5600 VCC / 模块SDA / 模块SCL | 待填 / 待填 / 待填 V |

编码器诊断读到 floating=1/1、pulldown=0/1、pullup=1/1。这些只是ESP32端数字采样，不能证明模块端供电、导通或上拉正常。优先断电核对 GPIO21→a13→AS5600 SDA、GPIO22→a14→SCL、VCC、GND 两端导通及接触，再核实模块供电和上拉接法并测电压；目前不能确定是接触、供电、模块或其他原因。

## 3V复测

用户补充电机额定3–6V、空载电流140mA；VM由此前12V调整后回复3V。2026-10-06再次执行左前轮64/255、400ms点动，串口接受并采样到STBY=1，结束后LOCKED、STBY=0、四轮指令为0。实际转动等待反馈；限流值、启动/堵转电流仍未知。证据：[3V点动日志](logs/mecanum-fl-jog-3v-2026-10-06.txt)。

## 3V提高单轮占空比测试

用户要求先假定接线正确继续测试。已烧录v1.1，将JOG上限单独提高为128，PS2仍为76。执行D1-A（逻辑FL）目标128/255、400ms点动，含软启动，未达到完整50%平台；采样到duty=96,0,0,0和STBY=1，随后自动锁定、STBY=0。实际运动待反馈。见[日志](logs/mecanum-fl-jog-3v-50pct-2026-10-06.txt)。
