x1shang/Chariot_strom_of_gear/docs/logs/2026-10-07-retest/四轮渐变与左右平移10秒.md

> **2026-10-14 方案变更：** 本文的 DRV8313 / 2804 / AS5600 抛投接线与 FOC 结论已归入[旧方案档案](../../archive/2026-10-14-DRV8313-AS5600/README.md)。新抛投采用 [L298N + 双 N20](../../抛投装置-L298N双N20接线与GPIO分配.md)；历史实测保留，当前引脚与供电以新方案为准。

# 四轮渐变与左右平移组合测试（2026-10-07）

前提：用户已确认逐轮双向 2 秒、四轮同时前进/后退 2 秒成功。用户要求进一步测试四轮同时加减速及左右平移，并将每项时长改为 10000ms、间隔保持 5000ms。

## 本轮实现与验证

- 新增 RAMPPULSE FWD/BACK peakDuty ms：前半程逐步升占空比，后半程逐步下降，峰值不超过 192/255，范围 1000..10000ms。命令入口复用既有健康、松键、锁定、静止间隔互锁；到期、STOP、失联/按键、非法或重叠命令均停机锁定。
- 10 秒参数对应前 5 秒升、后 5 秒降。没有转速反馈；渐变的是占空比，不能据此认证物理转速或电流。
- 新增 PulseProfile.h；原引脚、装车极性、20kHz PWM、固定占空比指令及单轮 2 秒能力保留。渐变输出首次归零时记录停机时刻，保持换向间隔。
- host/motion_sequence.py 增加 --ramp：查询 RAMPINFO，每约 100ms 请求状态，检查四轮同步幅度、方向、边界、峰值及单调上升/下降。
- ESP32 核心 3.3.12 编译通过，程序 305843 字节、全局变量 22536 字节。直接写入四段并全部 Hash of data verified，随后复位。构建目录 D:/Download/arduino/build-chariot-ramp-10s。
- 应用 SHA256：5bd02ef4f115a39d44d3e049dd0991c567636d0a7d1907df4c5087b026b61c6f。
- 主机侧渐变数学测试通过（边界、各峰值、正反、单调、到期、计时回绕）；4 项 Python 日志检查测试通过；实际固件源码的仿真测试通过（模拟 GPIO/PWM、到期、STOP/冷却、重叠、PS2/按键互锁、左右组合）。仿真不认证真实 GPIO 波形。

## 实际执行

顺序：前进渐变、后退渐变、左移固定占空比、右移固定占空比；各一次 10000ms，峰值/固定占空比 192，无重试。脚本配置停机间隔 5 秒；状态核查额外耗时，不把核查时间算进动作持续时间。

| 场景 | 指令 | 主机发送至到期回报 | 日志 |
| --- | --- | --- | --- |
| FWD | RAMPPULSE | 10.015s | [ramp-fwd-back-10s-173635.txt](ramp-fwd-back-10s-173635.txt) |
| BACK | RAMPPULSE | 10.015s | [ramp-fwd-back-10s-173635.txt](ramp-fwd-back-10s-173635.txt) |
| LEFT | MOVEPULSE | 10.016s | [lateral-left-right-10s-173635.txt](lateral-left-right-10s-173635.txt) |
| RIGHT | MOVEPULSE | 10.016s | [lateral-left-right-10s-173635.txt](lateral-left-right-10s-173635.txt) |

- 前进渐变：90 个自报状态样本、采到峰值 191；后退渐变：90 个样本、采到峰值 190；上升与下降趋势、同步幅度和各轮方向通过。采样峰值不是硬件最大输出或转速。
- 左移自报 GPIO 方向 duty=-192,192,-192,192；右移相反，duty=192,-192,192,-192。逻辑轮位 FL,RL,FR,RR；逻辑左移组合为 -,+,+,-，右移为 +,-,-,+，右侧装车极性为 -1。
- 两个脚本均退出 0，全部四项接受、活动状态与约 10 秒到期检查通过。最终 LOCKED、STBY=0、四轮指令归零，串口关闭。
- 烧录原始日志：同目录 ramp-10s-flash-*。

实际加减速效果、四轮是否持续同步及左右组合方向尚待用户现场回报。沿用此前四轮架空测试，不能把轮向组合通过写成已通过落地平移验收。此次未新增电压、电流、转速或温度测量，也未将测试写成断动力验证。

## 现场详细反馈及反馈能力复核

用户回报：左右平移时右侧两轮偏慢，右后尤其偏慢，但肉眼可能有偏差；加减速时仅峰值附近约 1–2 秒可见转动，低速阶段似乎不转。用户询问通过串口圈数确认，以及是否需提高电压。

已核对现车记录：每台电机仅两根动力线，无编码器，额定 3–6V。当前诊断程序没有轮速/圈数/电压/电流采集；duty 是软件输出指令，不能计圈。此次串口只查询 STOP/INFO/RAMPINFO/STATUS，最终 LOCKED、STBY=0、指令归零，串口关闭；未追加电机动作或升压。

复核上一轮原始日志：LEFT 的 21 个活动样本均为 -192,192,-192,192；RIGHT 的 21 个活动样本均为 192,-192,192,-192。只能证明没有给右侧下达更低幅值，不能证明实体输出一致或实际转速一致。

FWD/BACK 各 90 个渐变样本，初始幅值约 4，采样峰值 191/190，最后约 2/5，然后到期停止。未出现提前锁定事件。不能用 PWM 脉冲次数、占空比积分或投掷 AS5600 推算四轮真实圈数。

10 秒三角占空比曲线峰值为 192；理想指令幅值高于 160 的时间仅约 1.667 秒。若现场轮子仅高占空比能转，与启动/维持转动阈值相符，但无法反推已测得的启动阈值；实际起动与停止阈值可能不同。需要视频标记计圈或另装光电/霍尔/编码器确认。实际拍摄时长 t、完整圈数 N 可得平均 rpm=60N/t。

电压不足、配电压降或驱动压降均是待测解释，不能排除齿轮/轴承摩擦、轮子擦碰、电机差异或驱动差异。若 VM 仍为此前 6V，保持在电机已确认的 3–6V 范围内，不提高到 8/12V；先测同工况降压输出和左右板 VM、比较轮子/电机路径。TB6612 可接受更高 VM 不代表电机额定范围提高。驱动本身存在电流相关压降，见 [东芝手册](https://toshiba.semicon-storage.com/info/datasheet_en_20141001.pdf?did=10660)。

此处实物观察没有达到圈数/速度定量验收，左右平移和渐变转速控制仍待进一步验证。
