x1shang/Chariot_strom_of_gear/docs/logs/2026-10-07-retest/程序检查与原参数复跑.md

> **2026-10-14 方案变更：** 本文的 DRV8313 / 2804 / AS5600 抛投接线与 FOC 结论已归入[旧方案档案](../../archive/2026-10-14-DRV8313-AS5600/README.md)。新抛投采用 [L298N + 双 N20](../../抛投装置-L298N双N20接线与GPIO分配.md)；历史实测保留，当前引脚与供电以新方案为准。

# 原烧录程序检查与原参数复跑（2026-10-07）

用户要求：总结仓库和 PR 的问题、分析与刚才后轮正转失败是否有关联，先检查程序，再原封不动复跑。

## 程序检查

- 当前程序为 MecanumPS2MotionDiagnostic，PULSEINFO revision=single-2s；轮位 FL,RL,FR,RR，极性 1,1,-1,-1。
- 核对 PR #1：当前改动增加单轮 2000ms 上限、能力查询和启动说明，没有改引脚、极性或 PWM 输出算法。
- 原构建生成的 .ino.cpp 保留的 238 行源码与当前源码顺序一致；DriveMath.h 除 Arduino 自动生成的 #line 外与原构建一致。
- COM9 实测 ESP32-D0WD-V3、MAC 08:a6:f7:a8:95:94。esptool verify-flash 核对应用 0x10000 起的 305216 字节，digest matched，退出码 0。
- 原应用 SHA256：ce06b4943420d1197f77f35db83dae510bfb1a4c6a335e399076f60244a93b1f。
- 当前源码另目录重新编译通过：esp32:esp32:esp32，核心 3.3.12，程序 305071 字节，全局变量 22536 字节。新编译产物未烧录。两次构建二进制差异位于编译时间文本、ELF 摘要及镜像校验区。
- 既有混控/反转间隔/STOP 历史/计时回绕单元测试通过；Python 脚本语法检查通过。
- 正常 PULSE 指令使用同一输出算法。RL +192 -> GPIO18 PWM / GPIO19=0；RR +192 经极性转换为 -192 -> GPIO15=0 / GPIO5 PWM。未发现解释本次后轮正转失败的源码错误；这不等于认证全部输入或实际输出波形。

## 问题及关联判断

仓库包括投掷机构（2804/DRV8313/AS5600）、TB6612 麦轮底盘、PS2 控制、主机诊断脚本、烧录/MCP 工具和现场记录。投掷机构仍受编码器通信及磁场验收阻塞；底盘持续联动未通过。

PR #1 保存了单轮双向和四轮 300ms 短测通过、长时联动只有单轮转的事实，以及 5V 连线参与回供、STBY 接头接触不稳的排查过程；不是整车故障已修复。PR 无评论或评审记录。

刚才复测先发现左前杜邦线松脱；随后单轮各正反 2 秒，前轮双向正常，后轮只有反向可启动。两类失败可能共享接触、供电或驱动输出问题，但没有证明同一根因。此次方向差异值得优先核查后轮各方向 IN 信号到驱动针脚的路径和 B 通道输出；无法只凭日志排除负载、供电瞬态或驱动故障。AS5600 在底盘诊断程序中未使用，当前没有证据指向编码器直接导致这次问题。

## 原参数复跑

未修改固件或主机脚本，未重新烧录。保留板上原二进制；闪存核查结束复位后，以原 host/pulse_once.py 按 FL、RL、FR、RR 顺序，各 +192 后 -192、每次 2000ms、准备 5 秒执行一次。全部八次脚本退出 0，命令接受、活动占空比、到期时间及停机检查均通过。

| 轮位 | 逻辑占空比 | 发送至到期回报 | 日志 |
| --- | --- | --- | --- |
| FL | 192 | 2.000s | [unchanged-rerun-172334-FL-192.txt](unchanged-rerun-172334-FL-192.txt) |
| FL | -192 | 2.016s | [unchanged-rerun-172334-FL--192.txt](unchanged-rerun-172334-FL--192.txt) |
| RL | 192 | 2.015s | [unchanged-rerun-172334-RL-192.txt](unchanged-rerun-172334-RL-192.txt) |
| RL | -192 | 2.000s | [unchanged-rerun-172334-RL--192.txt](unchanged-rerun-172334-RL--192.txt) |
| FR | 192 | 2.016s | [unchanged-rerun-172334-FR-192.txt](unchanged-rerun-172334-FR-192.txt) |
| FR | -192 | 2.000s | [unchanged-rerun-172334-FR--192.txt](unchanged-rerun-172334-FR--192.txt) |
| RR | 192 | 2.015s | [unchanged-rerun-172334-RR-192.txt](unchanged-rerun-172334-RR-192.txt) |
| RR | -192 | 2.016s | [unchanged-rerun-172334-RR--192.txt](unchanged-rerun-172334-RR--192.txt) |

最终自报 LOCKED、STBY=0、四轮占空比为零，串口关闭。实际转动/方向尚待用户现场回报；本次没有远程测得动力开关、电压或电流，也没有新增实体供电确认。

## 本轮现场结果回填

用户确认原参数复跑检查通过，四轮均按先前后后的顺序转动，即各轮正向后反向。本次逐轮双向 2000ms 实物观察通过；此前后轮正向失败未在本轮重现，原因仍未定位。
