x1shang/Chariot_strom_of_gear/docs/logs/2026-10-17-卷线方案失败-电机撕裂/README.md

# 2026-10-17 卷线蓄力方案终止记录：扭矩过大，电机被撕裂

日期：2026-10-17。记录性质：**用户现场口述报告**。

本轮**没有串口日志、没有仪器读数、没有照片、没有拆检记录**。本文件按原意归档用户的说法，并明确划出证据边界；它不是实测数据。

导航：[仓库总入口](../../../README.md) · [旧方案归档](../../archive/2026-10-17-L298N-N20卷线抛投/README.md) · [当前方案：双 130 摩擦飞轮](../../抛投装置-双130摩擦飞轮接线与GPIO分配.md) · [2026-10-14 实机抛投四项失败](../2026-10-14-throw-test/README.md)

## 1. 用户报告原文

> 请你写明上次的发射装置方案已经失败（原因是扭矩太大，电机被撕裂），改为新方案，使用原驱动板驱动两个130电机摩擦飞轮发射装置。

同一条指示里的另一半是方案变更决定：**保留原驱动板（L298N），改用它驱动两个 130 电机，做成摩擦飞轮发射装置**。

## 2. 结论（按证据等级）

| 编号 | 内容 | 类别 | 证据等级 |
|---|---|---|---|
| 1 | 上次的发射装置方案已失败 | 结论 / 用户判定 | 用户明确陈述 |
| 2 | 失败原因是**扭矩太大，电机被撕裂** | 失效原因 / 用户判定 | 用户陈述 + 推断，**未经拆检或测量复核** |
| 3 | 方案变更：改用原驱动板驱动两个 130 电机摩擦飞轮 | 决定 | 用户明确指示 |

**「上次的发射装置方案」指 2026-10-14 建立的 L298N + 双 N20 卷线蓄力方案**：2 号电机连接转轴拉绳蓄力，1 号电机控制 2 号的位置以实现释放。该方案的接线、程序与全部证据已按此判定归档，见[旧方案归档](../../archive/2026-10-17-L298N-N20卷线抛投/README.md)。

## 3. 已知与未知（不要把未知写成已测）

**已知（用户陈述）**

- 方案不再可用，用户已决定放弃。
- 用户给出的失效原因：扭矩过大，**电机被撕裂**。

**未知（本轮未确认）**

- 被撕裂的是**哪一台**电机（1 号释放电机 / 2 号转轴电机）；两台 N20 的型号与减速比本轮仍未记录。
- 「撕裂」的具体部位与形式：是电机轴、减速箱齿轮、输出轴、还是安装座先失效？缺口/断口形态如何？
- 失效时的工况：占用空比多少、是否堵转、是否有限位冲击、是否有异物卡入。
- 是否已拆检、零件是否保留、能否拍照。
- 失效时电机端电压与电流（**没有**任何电气测量）。
- L298N 是否同时受损（**没有**测量，不能推断损坏）。
- 电池供电分支是否已定位修复。

**归因边界**

用户把原因归为「扭矩太大」。从力学上说，卷线/蓄力机构把电机经齿轮与卷线轴**硬联到拉绳和限位端**，机构一旦到位或卡住，电机就进入堵转或冲击工况，此时反作用于电机与齿轮的力矩上限由**机构和限位**决定，而不是由电机决定——这与 2026-10-14 已记录的滑齿、齿轮沿圆轴脱落、限位器补救失败是同一类失效。**这是对用户原因的解释，不是本轮测得的结论**：真正的断口与失效顺序需要拆检才能认定。

## 4. 本轮不改变的事实

- 不修改任何供电标称值（12V、VM、电流）：本轮没有电气测量。
- 不认定 L298N、N20、TB6612、底盘或电池已损坏。
- 不把「扭矩太大」写成带数值的结论（没有扭矩、电流或电压读数）。
- 旧方案的程序、脚本与日志**全部保留**，未删除、未合并进新固件。

## 5. 待用户补充（补齐后可升级为实测记录）

1. 失效电机的照片（整机、安装座、输出轴、减速箱、断口特写）。
2. 被撕裂部位的实际形式，以及是否已拆开确认失效顺序（哪一级先坏）。
3. 两台 N20 的型号/减速比铭牌照片；如已报废，记录原型号。
4. 失效时的占空比、供电电压、是否堵转、是否卡入异物。
5. 旧零件是否保留（用于对照新方案的飞轮轮毂与紧固方式）。
6. L298N 模块外观与通电自检结果（决定它是否还能用于新方案）。

照片按仓库惯例放入 `docs/assets/` 并在本文件引用。

## 6. 工程结论与对新方案的约束

摩擦飞轮方案把能量储存在**飞轮转子的动能**里，电机只承担惯性负载的加速力矩，机构中没有拉绳、齿轮组与硬限位，因此**不存在「到位即堵转」的工况**——这是选择该方案的力学理由。它同时给新方案留下三条硬约束：

1. **飞轮轮毂与紧固必须比旧卷线轴可靠**：圆轴配光孔齿轮的失效方式（沿轴向滑出）不能再出现；飞轮与电机轴必须用 D 形切面、紧定螺钉或夹紧轮毂等方式做**轴向与周向同时固定**。
2. **电机座的受力方向变了**：旧方案是齿轮啮合的径向力，新方案是飞轮旋转的不平衡力与启动反力矩；安装座与螺丝必须有防松措施（弹垫/螺纹胶），并且首次升速要**分级、短时、无人手持**。
3. **电流上限由电机与驱动板决定，不再由机构决定**：飞轮启动是惯性负载，启动电流大；原驱动板 L298N 每路 2A 是直流绝对最大额定值，不是长期能力。首次运行必须限流、分级、监视温升，见[新方案文档](../../抛投装置-双130摩擦飞轮接线与GPIO分配.md) §5。

## 7. 机器可读报告

[user-report.json](user-report.json)：原话、已知项、未验证项与证据边界。
