x1shang/Chariot_strom_of_gear/docs/archive/2026-10-17-L298N-N20卷线抛投/snapshot/docs/logs/2026-10-14-controller-wheel-check/README.md

# 2026-10-14 手柄与四轮现场检查

用户确认：四轮已架空，可自由转动；手柄打开，底盘动力开启。串口为 COM9（CH340），115200 波特率。未复位、编译或烧录，主机仅发送 STOP/STATUS；方向输入由用户手柄提供。

最终复测结果：用户在持续按住 ↑ 后反馈“已转动”。仓库方向键源码与远程最新版一致；板上记录到四路 255/255 目标输出、松键归零，实体手柄输入及本轮架空轮动通过。首轮短按未响应的现象保留于下文，不能直接判定驱动模块损坏；本轮尚未验证带载行驶、轮速一致性或无线断联停车。

## 首轮短按检查结论

| 检查项 | 结果 | 依据 |
|---|---|---|
| 接收器与 ESP32 通信 | 空闲采集正常 | hw=1、ps=1、mode=73/41；无按键时 ready=1，STBY=0，四轮指令为零 |
| 实体手柄按键输入 | 已通过本轮按键检查 | 采集到 ↑=0010、↓=0040、←=0080、→=0020、○=2000 |
| 四轮指令组合 | 符合固件映射 | 所有有效运动样本的四路符号组合正确；GPIO33/STBY 程序回读为 1 |
| 松键 / 圆圈撤销驱动 | 串口状态通过 | 无按键及圆圈样本均 STBY=0、duty=0,0,0,0 |
| 四轮真实转动 | **未通过：用户反馈“轮子无反应”** | 用户完成现场操作后的直接观察 |
| 驱动板供电 / 使能 / 输出电压 | 未完成 | 主控串口不能测出模块端子电压，等待 VM/VCC 实测 |

45 秒操作窗口共取得 200 条状态样本，hw 错误样本为 0。↑/↓/←/→的活动样本分别为 9/5/7/9 条，采样到的最大绝对占空比分别为 198/174/180/96，未采样到 255 满输出。因此本轮只能确认短按下轮子未响应，不能据此认定驱动板损坏，也未验证满输出或长时间连续运行。

14.906 秒采样到一次 ps=0、mode=FF、ready=0；当时 STBY=0，四轮指令为零。用户明确反馈按过 MODE/ANALOG，模式从 73 切换为 41 与该操作相符；不能证明这一条无效样本与模式切换存在唯一因果关系，也不能由这次测试认证无线断联停车。

结束时再次发送 STOP/STATUS，确认 STBY=0、四轮指令为零，并关闭串口。此方向键固件会在松键后自动 ready=1，STOP 不是永久锁定。

## 远程版本与最新文档复核

用户随后反馈两块 TB6612 的 VM/VCC“均正常”，未提供数值；按用户反馈记录，不将其写成主机已经测得的电压。

重新执行 `git fetch --prune origin` 后，HEAD 和 origin/master 均为 `53a1e5e`，没有落后或超前提交。`MecanumPS2Dpad.ino`、`DpadControl.h`、`DriveMath.h` 和模块 `README.md` 的本地 Git blob 哈希逐项与远程一致。原有归档及文档修改没有改动该方向键固件源码。

当前操作符合该模块最新说明：松开全部按键至 ready=1，直接按方向键；不需要 START 或 L1；MODE/ANALOG 不必切换，41/73/79 三种模式均被接受。摇杆不参与控制。程序每个步进增减 3 档，目标占空比 255，短点按可能在达到目标前已撤销输出。

第一次追加的 35 秒采集窗口未收到按键，不能计为运动测试。随后延长采集窗口，记录到 ↑ 持续输入时 `hw=1 ps=1 mode=41 buttons=0010 ready=1 STBY=1 duty=255,255,-255,-255`，共 54 个满输出样本；该轮未采样到 ps=0。证明实际运行固件具备方向键自动就绪与 100% 目标输出行为，与最新模块一致。STATUS 没有固件版本、Git 提交或构建哈希，因此未完成板上二进制与源码构建产物的逐字节比对，不声称已做 Flash 校验。

该轮用户随后反馈“已转动”，确认持续按键时有真实轮动；该结论结合现场反馈，未由串口指令单独推断。结束已发送 STOP/STATUS，确认 STBY=0、四轮指令为零，并关闭串口。未烧录、复位或修改运动固件。

## 待核查项

1. 松键状态分别测两块 TB6612 的 VM 对各自 GND、VCC 对 GND；VCC 按当前接法应约 3.3V，VM 应符合底盘 TT 电机 3–6V 的额定范围。
2. 再核对两板 PWMA/PWMB 的 3.3V 常高接线、公共地，以及 GPIO33 到两块 STBY 的连通。运动时程序 STBY=1 只证明主控端回读，不能代替模块针脚电压测量。
3. 供电与线束核查后，若需要复测，应给足斜坡达到目标所需时间，并以现场轮动与模块输出电压共同判断，避免用占空比推断真实转速。

历史底盘动力记录包含早期 3V 和后续 6V，现车电压尚未测量。已更正新接线文档中沿用早期记录的“当前 3V”表述；N20 的新 12V 分支与底盘分开。

## 原始证据

- [静止采集](01-idle.txt)
- [方向键与圆圈操作窗口](02-dpad-wheel-sequence.txt)
- [无转动反馈后的停机检查](03-stop-after-no-motion.txt)
- [状态统计](status-analysis.json)
- [远程源码与文档逐项比对](latest-source-audit.json)
- [追加采集：未收到按键](04-latest-firmware-held-up-check.txt)
- [持续按键与 100% 目标输出采集](05-held-up-extended-window.txt)
