x1shang/Chariot_strom_of_gear/docs/archive/2026-10-17-L298N-N20卷线抛投/snapshot/docs/全车连接检验-GPIO与降压端子索引.md

# 全车连接检验：GPIO 与降压模块端子索引

更新：2026-10-14。当前方案：经典 ESP32、双 TB6612 两线法底盘、L298N + 双 N20 抛投、原 PS2 接收器。原 DRV8313 与 AS5600 已停用。

接线依据：[新抛投接线](抛投装置-L298N双N20接线与GPIO分配.md) · [底盘接线](麦轮TB6612接线与面包板排线.md) · [旧检查单原文归档](archive/2026-10-14-DRV8313-AS5600/snapshot/docs/全车连接检验-GPIO与降压端子索引.md)

## 当前全车 GPIO 表

| GPIO | 当前设备端子 | 用途 / 连接要求 |
|---:|---|---|
| 2 | PS2 CLK | 原接线保留，启动配置脚 |
| 4 | PS2 CS / ATT | 原接线保留 |
| 5 | D2 BIN2 | 右后 RR IN2，启动配置脚 |
| 12 | PS2 CMD | 原接线保留，启动配置脚 |
| 13 | PS2 DAT | 原接线保留 |
| 14 | L298N ENA | N20-A PWM；取下通道跳帽，10kΩ 下拉 |
| 15 | D2 BIN1 | 右后 RR IN1，启动配置脚 |
| 16 | D1 AIN1 | 左前 FL IN1 |
| 17 | D1 AIN2 | 左前 FL IN2 |
| 18 | D1 BIN1 | 左后 RL IN1 |
| 19 | D1 BIN2 | 左后 RL IN2 |
| 21 | L298N IN3 | N20-B 方向 1；拆除旧 AS5600 线和专用上拉，检查旧接头 |
| 22 | L298N IN4 | N20-B 方向 2；不再连接 AS5600 / I2C |
| 23 | D2 AIN1 | 右前 FR IN1 |
| 25 | L298N IN1 | N20-A 方向 1 |
| 26 | L298N IN2 | N20-A 方向 2 |
| 27 | L298N ENB | N20-B PWM；取下通道跳帽，10kΩ 下拉 |
| 32 | D2 AIN2 | 右前 FR IN2 |
| 33 | D1 / D2 STBY | 原接线与共用 10kΩ 下拉保留 |

共 19 个 GPIO，分配无重复。GPIO 数字对应主控丝印，不是排针序号。L298N OUT1/OUT2 接 N20-A，OUT3/OUT4 接 N20-B，不接 GPIO 或系统 GND。

## 当前供电端子分配

| 分支 | 目的端子 | 说明 |
|---|---|---|
| ESP32 3V3 | 两块 TB6612 VCC、四个 PWMA/PWMB、PS2 VCC | 保留现有同源逻辑供电，不与降压 3V3 输出并联 |
| 底盘独立适配动力 | D1 VM、D2 VM | TT 电机额定 3–6V；历史使用过 3V 和 6V，现车 VM 待实测；不接新 12V 动力轨 |
| 新独立 12V 动力 | 保险丝 / 物理断电开关 → L298N VS / +12V | 用户选定 N20 12V 方案；电机型号及堵转电流待记录 |
| 稳定逻辑 5V | L298N 5V / VSS | 按实物说明隔离板载稳压器后外接，避免两个 5V 电源并联 |
| 主控供电 | ESP32 已确认的 5V / VIN | USB 调试时隔离降压到主控的正极线，避免回供电 |
| 公共 GND | ESP32、PS2、TB6612、L298N、各电源负极 | 功率回流直接走电源线和端子，不经面包板或主控细地线 |

L298N 的 5V 稳压跳帽与 ENA/ENB 通道跳帽须分别识别。若 VADJ 正给底盘供电，不得直接把它调到 12V；N20 的 12V 与底盘适配电压需要分别提供。完整操作与模块适配说明见新抛投接线文档。

以上为设计分配，尚未验收新模块；旧 FOC 固件不适用于这些引脚。

## 历史检查单（2026-10-06，原方案已停用）

以下旧表仅为历史追溯，包含当时的 12V VADJ、DRV8313 和 AS5600 接线，不能作为当前接线或调压指令。完整未修改原文已归档。

日期：2026-10-06。适用：经典 ESP32、双 TB6612 两线法底盘、DRV8313 投掷、AS5600、PS2 接收器。

接线基准：[麦轮TB6612接线与面包板排线](麦轮TB6612接线与面包板排线.md)、[面包板.xlsx](assets/面包板.xlsx)、[PS2Catapult 固件](../firmware/catapult/PS2Catapult/PS2Catapult.ino)。本表是待逐项填写的检验单，不代表硬件已通过测试。

## 1. 读表与检验准备

- GPIO 数字指 ESP32 的 GPIO 丝印，不是从排针一端数出的脚序号。
- D1=左侧 TB6612，D2=右侧 TB6612；FL/RL/FR/RR=左前/左后/右前/右后。
- a–e 为面包板左组，f–j 为右组。本文用物理排号，例如 a3 对应 Excel D4。
- 降压模块按 **3V3、5V、12V 三个区域**列出。你已确认第三路是 **VADJ可调输出，已调到12V**；下表仍留出负载端电压复测栏。
- 你已确认 **PS2接收器使用3V3，现已接在ESP32上**。本表保留ESP32 3V3供电，PS2 GND接ESP32公共地，不再从降压模块给它另接正极。
- 下文 `P5-01` 等是建议贴在线两端的线号，**不是模块原厂针脚编号**。未确认正负排朝向和针数，不能用“第二根、第三根”代替 OUT+/GND。
- 所有“通断/电阻”检查均在 USB、电池和外部电源全部断开、储能电容放电后进行。测线时必要时拔下两端，排除板内并联路径；不能仅以蜂鸣判断供电无短路。
- 先断开 D1/D2 VM 和 DRV8313 功率正极，固定投掷机构；完成逻辑检查后再考虑动力测试。

检验日期：________　检验人：________　ESP32 板型：________

## 2. GPIO 升序索引

“通过”要求线两端对应正确且导通，无松动、无与邻线误短接。信号无需直接接降压模块任何正极。

| GPIO | 用途 | 从 ESP32 到目的端的路径 | 检验重点 | 结果/记录 |
|---:|---|---|---|---|
| 2 | PS2 CLK | GPIO2 → 接收器 CLK | 启动配置脚；核对冷启动和下载 | □ ______ |
| 4 | PS2 CS | GPIO4 → 接收器 CS/ATT | 不能再接旧版 STBY | □ ______ |
| 5 | 右后 RR IN2 | GPIO5 → f6；j6 → D2 BIN2 | 启动配置脚；勿接到 D2 BIN1 | □ ______ |
| 12 | PS2 CMD | GPIO12 → 接收器 CMD | 启动配置脚；外设启动电平须验证 | □ ______ |
| 13 | PS2 DAT | GPIO13 ← 接收器 DAT | 接收方向；确认到 ESP32 的电平兼容 | □ ______ |
| 14 | 投掷使能 | GPIO14 → DRV8313 EN | 禁用状态应为低；不能接旧底盘 PWM | □ ______ |
| 15 | 右后 RR IN1 | GPIO15 → f5；j5 → D2 BIN1 | 启动配置脚；勿接 STBY | □ ______ |
| 16 | 左前 FL IN1 | GPIO16 → a3；e3 → D1 AIN1 | 实物 GPIO16 可用且已引出 | □ ______ |
| 17 | 左前 FL IN2 | GPIO17 → a4；e4 → D1 AIN2 | 实物 GPIO17 可用且已引出 | □ ______ |
| 18 | 左后 RL IN1 | GPIO18 → a5；e5 → D1 BIN1 | 不与 PS2 CLK 复用 | □ ______ |
| 19 | 左后 RL IN2 | GPIO19 → a6；e6 → D1 BIN2 | 第6排不得再跨槽 | □ ______ |
| 21 | AS5600 SDA | GPIO21 ↔ a13；e13 ↔ AS5600 SDA | 重点查接触不良、两端电平差异 | □ ______ |
| 22 | AS5600 SCL | GPIO22 → a14；e14 → AS5600 SCL | 不与 SDA 交换 | □ ______ |
| 23 | 右前 FR IN1 | GPIO23 → f3；j3 → D2 AIN1 | 不与 PS2 CMD 复用 | □ ______ |
| 25 | 投掷相控制1 | GPIO25 → DRV8313 IN1 | 不接 D1/D2 PWMA | □ ______ |
| 26 | 投掷相控制2 | GPIO26 → DRV8313 IN2 | 不接 D1/D2 PWMB | □ ______ |
| 27 | 投掷相控制3 | GPIO27 → DRV8313 IN3 | 不接 D1/D2 PWM | □ ______ |
| 32 | 右前 FR IN2 | GPIO32 → f4；j4 → D2 AIN2 | 不与 GPIO23 交换 | □ ______ |
| 33 | 两板 STBY | GPIO33 → a7；b7 → D1 STBY；e7–f7 桥接；j7 → D2 STBY | c7 经 10kΩ 到左−第7孔 | □ ______ |

共 19 个 GPIO：底盘 9 个、投掷驱动 4 个、PS2 4 个、AS5600 2 个，无重复分配。

本方案不使用 GPIO0（BOOT）、1/3（串口）、6–11（Flash）、34–39（仅输入）。ESP32 的 EN/RST 是主控复位端，**不是**上表 DRV8313 EN，二者不要混接。现有接线未分配 DRV8313 FLT，勿自行接到某条供电正极。

## 3. 降压模块端子索引

### 3.1 先确定各区域的 OUT+ 与 GND

断开负载，依据丝印识别输入和输出。通电后用直流电压档，黑表笔接已确认的 GND，红表笔分别测各区 OUT+。不要把 VADJ 或输入端误认为固定 12V 输出。

| 区域 | 输出正极实物位置（填写） | GND 实物位置（填写） | 空载实测 | 接逻辑负载后实测 | 状态 |
|---|---|---|---|---|---|
| 3V3 | ______ | ______ | ____ V | ____ V | □ 已确认 |
| 5V | ______ | ______ | ____ V | ____ V | □ 已确认 |
| 12V / VADJ | ______ | ______ | ____ V | ____ V | □ 已确认 |

第三路VADJ已调到12V，上负载前复测，不带负载调压。模块是否能从现有输入稳定输出12V、各路持续电流、散热能力仍须核实。

**沿用现有主方案：降压5V给ESP32供电，ESP32的3V3再给TB6612逻辑轨供电。降压3V3与ESP32的3V3不能直接并联。** USB调试时改由USB供电，拔掉降压5V到ESP32的正极线，保留共地。

### 3.2 3V3 区：条件性外设供电，默认不并入底盘逻辑轨

AS5600 的模块供电/R3与上拉接法尚有待核实，以下是满足条件后的端子安排，未确认前正极暂不插。PS2已由ESP32的3V3供电，本区不另给PS2接线。

| 建议线号 | 降压端 | 另一端 | 何时连接 | 结果/记录 |
|---|---|---|---|---|
| P3-01 | 3V3 OUT+ 的独立端子 | AS5600 模块的已确认3.3V供电端 | 确认模块支持此接法且上拉到3.3V后 | □ ______ |
| P3-02 | 3V3 区 GND | AS5600 GND | 与对应供电配套，并确认公共地导通 | □ ______ |
| 预留，不接 | 3V3 OUT+ 的其他端子 | 无 | PS2保持ESP32 3V3供电，不新增第二路正极 | □ 未连接 |
| 禁接 | 3V3 OUT+ | ESP32 3V3 / 面包板左+轨 | 本版底盘逻辑轨已有ESP32供电，不再并入 | □ 未连接 |

若 AS5600 已由 ESP32 侧合适的供电源供电，不再接降压正极；一个外设只选择一个供电源。外设独立供电时，避免外设已上电而ESP32掉电、信号仍接通的状态；USB单测应一并确认外设供电和信号电平。

### 3.3 5V 区：ESP32 主供电

| 建议线号 | 降压端 | 另一端 | 何时连接 | 结果/记录 |
|---|---|---|---|---|
| P5-01 | 5V OUT+ | ESP32 已确认可接受5V的 5V/VIN 端 | 独立供电模式；USB调试时拔掉这根正极线 | □ ______ |
| P5-02 | 5V 区 GND | 公共地端子 | 作为降压输出地与系统地的连接，先核对模块共地结构 | □ ______ |
| 预留，不接 | 5V OUT+ 的其他端子 | 无 | PS2已确认使用3V3，不接此区正极 | □ 未连接 |
| 禁接 | 5V OUT+ | PS2 VCC、ESP32 3V3、TB6612 VCC/STBY/PWM、任意GPIO | 均不按此表接5V | □ 未连接 |
| 不作为动力供电 | 5V OUT+ | DRV8313 功率正极 | 不符合当前投掷驱动供电要求 | □ 未连接 |

AS5600 若最终确认必须采用5V模块供电，需要同时落实模块上拉/R3或电平转换接法，再补充其正负端子；本表不把未确认的5V接法列为可直接插线项。当前也不安排舵机取电。

### 3.4 12V 区：动力端子，不使用普通杜邦线

下表纳入端子索引以免遗漏，但这是**电源线/接线端子分支**。只有确认该路电压、电流、散热及电机适配后才连接。若降压模块不能承担动力电流，应采用合适的独立动力分配；不能用多根杜邦线并联代替额定合适的连接器。

| 建议线号 | 起点 | 终点 | 条件/检查 | 结果/记录 |
|---|---|---|---|---|
| P12-01 | 已实测的12V OUT+ | 保险丝/物理断电开关 → 动力正极分线端子 | 核对模块输出能力与所有同时运行负载 | □ ______ |
| P12-02 | 12V 输出负极/GND | 公共地端子 | 合适线径；核对与其他输出是否共地 | □ ______ |
| M-01 | 动力正极端子 | D1 VM | 麦轮电机确认适用该电压，且不超过模块限制 | □ ______ |
| M-02 | 动力正极端子 | D2 VM | 同上；单独分支 | □ ______ |
| M-03 | 动力正极端子 | DRV8313 功率正极 | 核对实际驱动板与电机规格；仅逻辑检验时断开 | □ ______ |
| G-01 | D1 功率GND | 公共地端子 | 独立回流，不经面包板 | □ ______ |
| G-02 | D2 功率GND | 公共地端子 | 独立回流，不经面包板 | □ ______ |
| G-03 | DRV8313 功率负极 | 公共地端子 | 独立回流，不经ESP32地线 | □ ______ |

项目商品图给TB6612模块的VM范围为3–12V，但麦轮电机的额定电压/堵转电流仍须核实，不能由“12V区”倒推电机一定适用12V。电源输入端另接合适电源的正负极，不能把输出正极回接到输入正极；输入额定范围以实物为准。

### 3.5 公共地与ESP32供电闭环

| 建议线号 | 路径 | 作用 | 结果 |
|---|---|---|---|
| L-01 | ESP32 GND → 面包板左−第2孔 | ESP32逻辑地 | □ |
| L-02 | 左−第12孔 → 公共地端子 | 使ESP32及逻辑地与驱动、降压共地 | □ |
| L-03 | 左−第3孔 → 右−第3孔 | 两侧逻辑地轨桥接 | □ |
| L-04 | DRV8313 信号GND → 逻辑地轨空孔 | 信号参考地；确认板上与功率地关系 | □ |
| L-05/06 | D1/D2 信号侧GND → 逻辑地轨各一个空孔 | 核对模块各GND连通；不替代功率回流线 | □ |

按此布局，降压5V供电回路为：5V OUT+ → ESP32 5V/VIN → ESP32 GND → 逻辑地轨 → 公共地 → 降压GND。所有信号参考地必须导通。若实物有隔离输出，不能先假定各区GND相通，应按模块资料核对再决定共地接法。

## 4. 不占 GPIO、但必须检查的面包板连接

下表与现有排线表一致；轨孔按邻近物理排号定位，实物不一致时用已确认同一网络的空孔。

| 起点 | 终点 | 正常状态 | 结果 |
|---|---|---|---|
| ESP32 3V3 | 左+第2孔 | 此轨唯一供电源 | □ |
| ESP32 3V3 | PS2 VCC（现有线） | 保留现有3V3供电；若需分线使用同源分配端子，不把两根线硬塞一个孔 | □ |
| PS2 GND | ESP32 GND / 已确认的公共逻辑地 | 保留共地，逐端确认 | □ |
| 左+第3孔 / 第4孔 | D1 VCC / D2 VCC | 两板逻辑约3.3V | □ |
| 左+第8孔 → a8 | e8 → D1 PWMA | 常高约3.3V | □ |
| 左+第9孔 → a9 | e9 → D1 PWMB | 常高约3.3V | □ |
| 左+第10孔 → f8 | j8 → D2 PWMA | 常高约3.3V | □ |
| 左+第11孔 → f9 | j9 → D2 PWMB | 常高约3.3V | □ |
| c7 → 10kΩ 电阻 | 左−第7孔 | 下拉，不是直接短接STBY到GND | □ |
| e7 | f7 | 两组STBY相通，唯一信号排跨槽线 | □ |
| 右+轨 | 不连接 | 留空无电；不是本版5V分配轨 | □ |

ESP32板上3V3稳压器现需承担PS2及两板TB6612逻辑等负载；核对开发板稳压器容量并测负载下电压，不能因已有3V3针脚就认为供电能力无限。此轨不供电机动力。

电阻如需确认阻值，断电后至少抬起一端测量；在线读数会受芯片内部下拉等并联支路影响，不要求在线恰好显示10kΩ。

## 5. 分阶段检验记录

### A. 全部断电

- [ ] GPIO索引19项逐条测通，轻晃插头无间歇开路。
- [ ] 第6排无旧e6–f6桥，第7排有e7–f7桥和10kΩ下拉。
- [ ] 四个板上PWM脚接3.3V，旧GPIO25/26/27/14到TB6612的PWM线已拆。
- [ ] a–e与f–j各自同排相通；不同排及中央隔槽无误短接。长电源轨分段已检查。
- [ ] 每个OUT+与GND位置已确认，无极性反接和明显短路；各电源输出正极未互相并接。
- [ ] 逻辑地、驱动地、降压地按选定方案连通；电机功率回路不经过面包板。
- [ ] D1/D2四对输出仅接对应电机，未接地，未误接编码器线。

### B. 仅逻辑供电，所有驱动动力正极仍断开

测量时黑表笔接公共地，再在器件端复测，不能只量降压板端就认定末端已有供电。

| 测点 | 预期/判断 | 实测 | 结果 |
|---|---|---|---|
| ESP32 供电端 | 与当前USB/外部5V模式一致 | ____ V | □ |
| D1 / D2 VCC | 均约3.3V | ____ / ____ V | □ |
| D1 PWMA / PWMB | 均约3.3V | ____ / ____ V | □ |
| D2 PWMA / PWMB | 均约3.3V | ____ / ____ V | □ |
| D1 / D2 STBY | 未使能时均约0V | ____ / ____ V | □ |
| DRV8313 EN | 固件禁用时约0V | ____ V | □ |
| AS5600 模块供电端 | 与已核实的模块接法一致 | ____ V | □ |
| SDA / SCL 空闲电平 | 释放总线且上拉正常时应接近3.3V；低电平需排查 | ____ / ____ V | □ |
| PS2 VCC / DAT | VCC约3.3V，来自ESP32；DAT到ESP32电平兼容 | ____ / ____ V | □ |

普通万用表只能作静态/平均电平排查，不能证明启动瞬态或PWM波形正确。启动期间STBY是否出现窄高脉冲，需示波器或逻辑分析仪进一步确认。

### C. 控制与动力验证

- [ ] 已有匹配两线法的底盘固件；不能用旧QGPMaker固件直接验收TB6612。
- [ ] PS2按键、断联行为与AS5600连续读数已单独验证；I2C失败不靠随意交换GPIO掩盖。
- [ ] 采用合适电压/限流，四轮架空、投掷动力保持隔离，逐轮点动并核对FL/RL/FR/RR。
- [ ] 低速检查滑行、短路制动、换向，记录电流与温升；STBY低只表示高阻待机。
- [ ] 停止、复位和失联撤销使能，物理断电开关有效；再进行全车集成。

未通过项目及处理：________________________________________________

## 6. 仍需实物确认的项目

1. 已确认VADJ调到12V；仍需记录负载端电压、总输出能力和温升。
2. 已确认PS2使用ESP32 3V3；仍需核对实际VCC/GND落点、负载下3V3电压及信号电平。
3. AS5600实物供电、R3及上拉接法，确定后再连接P3-01或另行记录其供电方案。
4. 四台麦轮电机的额定电压、堵转电流及TB6612散热适配。

依据补充：[线路检查记录](线路检查记录.md)、[PS2遥控实现与调试](PS2遥控实现与调试.md)。以上未确认项不能仅凭线色、排针左右顺序或软件能启动判定通过。
