x1shang/Chariot_strom_of_gear/docs/archive/2026-10-14-DRV8313-AS5600/snapshot/docs/diagnostics/2026-10-07/D1-B端子测量记录-2026-10-07.md

> 归档说明：这是 2026-10-07 按阶段追加的历史记录。早期“当前/待测”描述只适用于当时；最新状态见同目录 README.md。源码和日志的文字路径以仓库根目录为基准。此文件归档时仅整理路径，实测内容保留。

# D1-B 端子测量记录

日期：2026-10-07。现车两线版；测量值由用户现场读取并反馈，不是串口传感器读数。

## 静止测量

用户按操作步骤通电、以 D1 模块 GND 为参考，依次反馈：

| 测点 | 用户反馈 | 当前判断 |
|---|---|---|
| VM | 6V | 符合本轮 6V 设置 |
| VCC | 3.33V | 符合 3.3V 逻辑供电预期 |
| PWMB | 3.33V | 符合两线版 PWM 输入固定高电平预期 |

本轮测量阶段电机动力线按前述操作保持拆开，尚未发送新的 JOG。上述静止读数不证明输入波形、输出级或负载供电已通过。

## 下一测点

待用户将黑笔接 D1 GND、红笔接 D1 BIN2 并确认放稳后，进行 RL 正向无电机短时重复点动，记录 BIN2；预期接近 0V。之后分别测 BIN1、STBY。

## BIN2 测量窗口已执行

用户确认表笔放好后，在 COM4 执行 RL 正向 duty=128、每次800ms、总时长20秒的重复点动；共发23次，板上返回 OK JOG，状态中 control=JOG、STBY=1、RL指令可达到128，其余三轮指令为0。
结束收到 OK STOP LOCKED，并确认 control=LOCKED、STBY=0、duty=0,0,0,0；脚本正常退出、串口关闭。
仅证明指令接受及软件停止状态；BIN2 实测电压仍待用户回报。

用户回报：BIN2 在点动期间一直接近0V，停止后也保持接近0V。这符合正向RL的非活动方向输入为低、停止时两方向输入归零的预期；未观察到BIN2随正向点动出现明显电压变化。该测量不认证短暂尖峰或完整波形。
下一步：分别测点动期间 BIN1、STBY，仍保持无电机。

## BIN1 测量窗口已执行

用户确认红笔移到 BIN1 并放好后，在 COM4 执行同条件 RL 正向无电机重复点动20秒，共23次。板上返回 OK JOG，RL指令有软启动并达到128；结束收到 OK STOP LOCKED，脚本正常退出。
BIN1 点动期间及结束后的实际电压待用户回报。

用户回报：BIN1 点动期间读数跳动，最高约1.6V；开始前与结束后均为0V。与本轮正向输入软启动/重复点动、停止归零的行为相符，支持控制变化已到该模块测点；普通万用表仍不能认证PWM频率、幅值峰值或完整波形。
结束后另行仅发送STATUS，连续确认 control=LOCKED、STBY=0、duty=0,0,0,0，串口关闭。
下一步：测模块端 STBY 在同条件点动期间和停止后的电压。

## STBY 测量窗口已执行

用户确认表笔放好后，在 COM4 执行同条件 RL 正向无电机重复点动20秒，共23次。串口开始读到启动文本与初始 ps=0，随后 ps=1 且命令被接受；未据启动文本判定复位原因或发生时刻。
点动采样状态 STBY=1、RL指令可达到128；结束收到 OK STOP LOCKED，最后状态 control=LOCKED、STBY=0、duty=0,0,0,0，脚本正常退出并关闭串口。
模块端 STBY 实测电压待用户回报。

用户回报：STBY 点动期间跳动，最高约3.3V，结束后归零。与有效点动使能高、间隙及停止归零的预期相符。

## 输入补测小结

| 测点 | 用户现场读数 |
|---|---|
| VM，静止 | 6V |
| VCC，静止 | 3.33V |
| PWMB，静止 | 3.33V |
| BIN2，正向RL点动 | 一直接近0V，结束后仍接近0V |
| BIN1，正向RL点动 | 跳动，最高约1.6V；开始前和结束后0V |
| STBY，正向RL点动 | 跳动，最高约3.3V；结束后0V |

当前测量未发现明显输入供电/控制异常，但普通万用表不能认证完整PWM波形；不能据此宣布驱动板损坏或负载供电合格。此前输出0V是旧测量，本轮尚未复测输出。
下一步：全部断电、拔USB，在电机仍拆开的条件下，隔离D1-B的主控输入及D1 STBY控制线，建立固定高低电平，再测BO1/BO2直流输出。改线步骤须逐条确认，避免与GPIO输出硬接。

## 空载固定正向输入测试

用户按指导断电后拔下 D1 模块 BIN1、BIN2、STBY 的原控制线，再用跳线将 STBY、BIN1 接原3.3V节点，BIN2接公共GND；电机仍拆开。插USB、VM仍关闭时，用户确认三个输入均符合稳定高/高/低的预期，未提供各项具体电压。
恢复6V VM后，以D1 GND为参考，用户依次报告BO1=6V、BO2回复“o”（本轮按0V理解，待用户有异议时更正）。
当前结果支持D1-B能在无电机、固定正向输入下建立高低输出；不认证负载驱动能力、反向通路或原PWM状态。原“不转/输出0V”故障尚未解决。
下一步：先全部断电，再交换BIN1/BIN2固定高低输入，复测空载反向输出。

## 空载固定反向输入测试

用户确认全部断电后，交换BIN1/BIN2的临时跳线：BIN1接GND、BIN2接3.3V，STBY保持接3.3V。USB逻辑供电后、VM关闭时，用户确认两方向输入符合低/高预期，未提供具体电压。
恢复6V VM后，以D1 GND为参考：BO1用户反馈0V，BO2用户反馈6V。
正向6V/0V、反向0V/6V均符合空载直流预期；不据此认证带载能力或原PWM控制已正常。此前PWM输出0V和电机不转仍须复现定位，不能宣布故障已经解决。

## 后续负载短测准备（尚未执行）

先全部断电。为避免固定STBY高时电机持续运行，计划将D1 STBY临时3.3V跳线拆下，恢复其原GPIO33共用STBY控制支路；BIN1低、BIN2高的静态方向先保留。
选此前已独立直供可转的同一台电机接D1-B，其他电机保持隔离。原GPIO18/19仍与模块BIN1/BIN2断开。
这样原MecanumPS2的单次JOG仅用于限时拉高STBY，电机实际为固定方向、VM直流全占空比，而非状态行显示的PWM占空比。准备完成并核对默认STBY低后，才发送一次约500ms限时JOG；不使用20秒重复脚本作带电机测试。

## 固定反向输入、带电机500ms短测已执行

用户恢复D1 STBY原GPIO33控制，USB仅逻辑供电时现场测STBY=0V；断电后将此前直供能转的电机接D1 BO1/BO2。BIN1仍固定GND、BIN2仍固定3.3V，PWMB仍3.3V，原GPIO18/19控制线与模块输入保持断开。用户恢复供电后报告电机不转（待机状态）。
重新插USB后端口由COM4变为COM5（CH340，VID:PID=1A86:7523）；COM4打开失败，未发点动。改用COM5，仅STATUS预检，确认hw=1、ps=1、buttons=0000、LOCKED、STBY=0、四轮指令0，随后只发送一次JOG RL 128 500。
板上接受命令，采样到STBY=1（指令占空比15不代表本次电机真实占空比），随后自动JOG DONE/STOP；另发STOP与STATUS，确认LOCKED、STBY=0、四轮指令0，串口关闭。
本次模块输入为固定反向、全直流驱动，仅STBY限时使能约500ms；现场是否转动待用户回报。未使用20秒重复脚本。

用户回报：电机转了约半秒，与500ms限时使能相符。该配置已验证D1-B可短时驱动这台电机；未测启动峰值电流、动态压降、长期温升、其他电机/通道或整车负载。
静态方向输入与GPIO33限时STBY组合能够驱动，是反对“D1-B完全无驱动能力”的证据；不能据此断定原PWM链路或所有接触均正常，也不能定位先前问题唯一原因。
下一步计划：全部断电，拆下BIN1/GND、BIN2/3.3V临时跳线，恢复GPIO18→BIN1、GPIO19→BIN2，STBY继续原GPIO33；保留同一电机和6V。先在原接线下用单次反向JOG RL -128 800测试，以保持与刚才固定输入相同的物理方向。该测试含约430ms爬升、剩余约370ms目标平台；不转不能单独证明控制故障，须与启动占空比不足区分。尚未执行。

## 原两线版 PWM 接线恢复后，反向800ms短测已执行

用户确认断电后移除临时BIN1/GND、BIN2/3.3V跳线，并恢复面包板GPIO18→BIN1、GPIO19→BIN2支路；STBY保持GPIO33控制，保留同一台电机。用户恢复USB与6V供电后反馈电机静止。
自动枚举确认唯一CH340为COM5；仅STATUS预检确认hw=1、ps=1、buttons=0000、LOCKED、STBY=0、四轮指令0后，发送一次 JOG RL -128 800。
板上返回OK JOG，采样到RL指令-18及-128、STBY=1，其余轮指令0；随后自动结束，另发STOP与STATUS，确认LOCKED、STBY=0、四轮指令归零。串口关闭。
现场是否转动待用户回报。未重复点动、未改固件，也未把指令占空比当作端子实测波形。

用户回报：原接线下本次反向PWM短测电机没动。
判断上限：固定全电压驱动可启动、50%上限且含软启动时不启动，仍可能是启动占空比不足，不能直接判PWM接线故障。此前测过的BIN2接近0V是在正向测试（BIN2为非活动方向），尚未验证GPIO19→BIN2在反向时的活动输出。
下一步先在全部断电后拆下D1-B电机线，保持原两线控制接法，做无电机反向活动输入BIN2补测。为此本地点动脚本已增加与现有固件一致的负占空比参数支持（±1..128）；未改变固件或幅值/时长上限，未执行新测试。

## 无电机反向活动输入 BIN2 补测窗口已执行

用户断电拆下D1-B电机两根线，保持恢复的GPIO控制接法，再恢复USB和6V供电，确认黑笔D1 GND、红笔D1 BIN2已放稳。
枚举确认唯一CH340当前为COM4，执行RL -128、每次800ms、总20秒重复点动，共23次。板上接受反向命令并采样到RL指令-128、STBY=1；结束收到OK STOP LOCKED，脚本正常退出并关闭串口。
BIN2反向活动时的实际电压待用户回报。串口原始文本保存于docs/logs/2026-10-07/RL反向BIN2补测-2026-10-07.txt。

用户回报：反向活动时BIN2读数跳变，最高约1.6V，结束后归零。支持反向控制变化已到BIN2测点；未认证PWM瞬时高电平幅值、频率、两输入相互关系或输出级行为。
下一步：保持电机拆开及原两线控制接法，测反向PWM期间BO2相对BO1的差分电压（红BO2、黑BO1），记录整个窗口变化；不强制要求读到3V，不由一次0V直接判坏板。

## 无电机反向 PWM 输出差分测量窗口已执行

用户确认黑笔D1 BO1、红笔D1 BO2已放稳；电机仍拆开，原两线控制接法不变。
枚举确认唯一CH340为COM4，执行RL -128、每次800ms、总20秒重复点动，共23次。板上接受指令，RL指令可达到-128；结束收到OK STOP LOCKED及LOCKED、STBY=0、四轮指令0，脚本正常退出并关闭串口。
BO2相对BO1的实际差分电压及停止后读数待用户回报。

用户回报：反向PWM期间读到6.4V，结束后归零；未报告稳定范围，不能将6.4V当作接电机时的有效电压或PWM峰值。
当前已确认原PWM接法下无电机时可测非零差分输出，降低完全不输出的嫌疑。仍需核实实际VM是否约6V，并在电机连接下区分启动占空比不足、动态供电/地压降与其他控制问题。静态满驱动可转、半占空比软启动不转，并不自动证明电机需要超过50%才能启动。

## 诊断程序已烧录，VM关闭时的协议验证完成
用户确认动力电源已关、USB还连着；电机按此前要求保持拆开。COM4烧录诊断版本，工具退出0、各段哈希校验通过。串口确认hw=1、ps=1、buttons=0000、LOCKED、STBY=0、四轮指令0。6种非法PULSE参数均拒绝并锁定。VM关闭时发送一次PULSE RL -128 500，报告RL固定-128、其他轮0、STBY=1，约500ms自动结束；再发送STOP和STATUS，确认停止状态后关闭串口。日志见docs/logs/2026-10-07/诊断程序-VM关闭验证-2026-10-07.txt。尚未进行诊断版本带电机测试，也未认证真实端子PWM波形。下一步现场复测D1 VM对GND实际供电，保持电机拆开。

## 固定占空比带电机短测准备
用户复测D1 VM对GND为6V；随后确认关闭动力电源、拔USB后接回同一台电机到D1 BO1/BO2，恢复USB，动力电源仍关闭。一次枚举未发现串口，重查COM4恢复；只发送STOP和STATUS，确认hw=1、ps=1、buttons=0000、LOCKED、STBY=0、四轮指令0并关闭串口。尚未执行带电机PULSE。下一步现场打开动力电源，确认待机时电机静止。

## 固定约50%带电机500ms短测已执行
用户确认同一电机接D1-B、实际VM此前复测6V、恢复动力后待机不转。COM4预检hw=1、ps=1、buttons=0000、LOCKED、STBY=0、四轮指令0。只发送一次PULSE RL -128 500（128/255约50.2%，无爬升）。收到OK PULSE，活动状态报告0,-128,0,0、STBY=1，约500ms后自动结束；再发STOP及STATUS，确认LOCKED、STBY=0、四轮指令0，关闭串口。现场是否启动待用户回报；未自动执行下一档。日志：docs/logs/2026-10-07/RL固定50百分比带电机短测-2026-10-07.txt。

用户回报：固定约50%带电机500ms短测完全没动。仍不能单凭该现象定位唯一根因。

## 固定约75%带电机500ms短测已执行
保持同一电机、原GPIO接法和此前确认的6V供电；COM4预检hw=1、ps=1、buttons=0000、LOCKED、STBY=0、四轮指令0。只发送一次PULSE RL -192 500（192/255约75.3%，无爬升），收到OK PULSE及0,-192,0,0、STBY=1；约500ms后自动结束。随后STOP及STATUS确认LOCKED、STBY=0、四轮指令0，关闭串口。现场转动结果待用户回报，未执行100%档。日志：docs/logs/2026-10-07/RL固定75百分比带电机短测-2026-10-07.txt。

## 固定约75%短测现场结果及当前判断
用户回报：电机转了半秒。与本次单次500ms固定占空比指令相符。
同一电机、D1-B、原GPIO控制接法、此前复测VM=6V：固定约50.2%/500ms没动，约75.3%/500ms可转。
原程序PS2上限76/255约29.8%，JOG上限128/255约50.2%，且含爬升。这些输出设置不足以复现本次已成功的启动条件，可以解释先前测试不转；但不能据两次短测认证唯一根因、精确启动阈值、带载供电合格或其他通道正常。
本轮不追加100%测试。诊断固件仍在板上，结束时已锁定，STBY=0、四轮指令0。尚未提高PS2常规输出上限，未进行整车驱动测试。
后续先关闭动力电源、保留USB；再规划单轮启动/维持占空比与带载供电对照，不能直接把四轮上限一并提高到75%。

## 固定约75%启动时的VM对GND测量窗口已执行
用户确认关闭动力电源后保持同一电机及接线，万用表黑D1 GND、红D1 VM；恢复动力后待机读数6V。COM4预检正常，单次PULSE RL -192 500得到接受并采样到STBY=1、指令0,-192,0,0，约500ms自动结束。随后STOP、STATUS确认LOCKED、STBY=0、四轮指令0，关闭串口。用户观察到的VM最低读数和电机是否转动尚待回报；普通万用表未看到压降不能排除瞬态压降。日志：docs/logs/2026-10-07/RL固定75百分比带电机VM测量-2026-10-07.txt。

用户回报：本次75%短测有转动；D1 VM对D1 GND最低可能约5.9V，用户注明读数可能看错。待机6V，观察到的变化约0.1V，仅作为普通万用表现场近似读数，不认证瞬时最低供电或电源余量。未观察到显著、可见的供电下跌，不能因此排除快速压降、接触问题或认证公共地路径合格。下一步计划测同一次启动条件下D1 GND相对降压OUT-的电压差，检查负载地回路；未执行。

## 地线压降准备阶段更正
用户先报0V，随即明确动力电源尚未打开。该0V是动力关闭时读数，不能视为带动力待机值或带负载地线压降。一次75%短测流程在用户更正时被中断，命令可能已部分执行，但动力电源关闭；不计作有效带载测量，不自动重发。更正后另发STOP及STATUS，确认hw=1、ps=1、buttons=0000、LOCKED、STBY=0、四轮指令0，关闭串口。下一步须现场打开动力电源并报告新的待机读数，收到明确通电确认后才执行新的半秒测量。

日志复核补充：被中断流程实际已完整发送一次PULSE RL -192 500并自动结束，随后STOP、STATUS确认停止；当时动力电源关闭，仍不计入有效带载地线压降数据。更正后的独立STOP/STATUS也确认锁定停止。

## 动力明确开启后的地线压降短测已执行
用户明确确认动力已开，黑OUT-、红D1 GND待机读数0V。COM4预检正常，单次PULSE RL -192 500收到接受，报告STBY=1、四轮指令0,-192,0,0，约500ms自动结束。随后STOP及STATUS确认LOCKED、STBY=0、四轮指令0，关闭串口。地线电压差最大偏离0V的读数及电机是否转动待用户回报。日志：docs/logs/2026-10-07/RL固定75百分比地线压降-动力已开-2026-10-07.txt。先前动力关闭的同类流程不计入有效带载测量。

用户回报：动力明确开启的75%地线压降短测，电机有转动，D1 GND相对降压OUT-读数最大约0.06V（未报告负号）。普通万用表本轮未观察到明显地线压降；不能认证瞬态、接触稳定性或四电机并行时的回路表现。结合此前D1 VM对GND最低可能5.9V，本阶段将排查重点转向启动占空比，不要求立即改动公共地接法。

## 固定约63%带电机500ms短测已执行
保持同一电机、原GPIO接线、供电及原地线表笔接法。COM4预检hw=1、ps=1、buttons=0000、LOCKED、STBY=0、四轮指令0。只发送一次PULSE RL -160 500（160/255约62.7%，无爬升），收到接受及STBY=1、0,-160,0,0状态；约500ms后自动结束。随后STOP、STATUS确认LOCKED、STBY=0、四轮指令0，关闭串口。现场电机是否启动待用户回报；不以该条件认定整车适用输出上限。日志：docs/logs/2026-10-07/RL固定63百分比带电机短测-2026-10-07.txt。

用户回报：反向固定约62.7%、500ms电机转了半秒。本工况下固定约50.2%没动、约62.7%及75.3%均可启动；仅为本电机/通道/方向/时长下的观察，不给出稳定或整车通用的启动阈值。不继续细分占空比。

## 正向固定约63%带电机500ms短测已执行
保持同一电机、供电及GPIO接法，测试相反转向以检查另一方向路径。COM4预检hw=1、ps=1、buttons=0000、LOCKED、STBY=0、四轮指令0；只发送一次PULSE RL 160 500（约62.7%，无爬升）。收到接受及STBY=1、四轮指令0,160,0,0，约500ms自动结束。随后STOP、STATUS确认锁定、STBY=0、四轮指令0，串口关闭。电机是否启动及物理方向是否相反待用户回报。日志：docs/logs/2026-10-07/RL正向固定63百分比带电机短测-2026-10-07.txt。

用户回报：正向固定约62.7%、500ms没转。与同电机反向约62.7%可转形成方向差异；不能把反向结果外推到正向，也不能立即判正向通路损坏。先前静态满电平正向只有空载输出6V/0V，未完成正向固定输入带电机验证。

## 正向固定约75%带电机500ms短测已执行
保持同一电机、供电及原GPIO接法。COM4预检hw=1、ps=1、buttons=0000、LOCKED、STBY=0、四轮指令0；只发送一次PULSE RL 192 500（约75.3%，无爬升）。收到接受及STBY=1、四轮指令0,192,0,0，约500ms自动结束。随后STOP、STATUS确认锁定、STBY=0、四轮指令0，串口关闭。现场是否启动待用户回报，未执行其他档位。日志：docs/logs/2026-10-07/RL正向固定75百分比带电机短测-2026-10-07.txt。

用户回报：正向固定约75.3%、500ms已转，但忘记正反的物理方向，请求再正转一次。该反馈确认能启动，不确认与先前负向转动的方向关系。

## 应用户要求重测正向以辨认方向
COM4预检hw=1、ps=1、buttons=0000、LOCKED、STBY=0、四轮指令0。只发送一次PULSE RL 192 500，收到接受及STBY=1、指令0,192,0,0，约500ms自动结束；随后STOP、STATUS确认锁定、STBY=0、四轮指令0，关闭串口。已向用户说明这是程序正号定义，并不直接认证装车后的前进方向。现场本次转动和方向观察待回报。日志：docs/logs/2026-10-07/RL正向75百分比方向辨认重测-2026-10-07.txt。

## 应用户要求重测反向以与前次正向比较
用户以刚才正号命令作为观察上的“正向”，要求再测反向。保持同一电机、接线和供电，提醒从同一观察侧比较。
COM4预检hw=1、ps=1、buttons=0000、LOCKED、STBY=0、四轮指令0。只发送一次PULSE RL -192 500，收到接受及STBY=1、指令0,-192,0,0，约500ms自动结束；随后STOP、STATUS确认锁定、STBY=0、四轮指令0，关闭串口。现场是否转动及是否与前次方向相反待回报。日志：docs/logs/2026-10-07/RL反向75百分比方向辨认重测-2026-10-07.txt。

## 阶段结论：D1-B同一电机双向短测完成
用户最终确认：正号PULSE RL 192 500和负号PULSE RL -192 500都转，且观察到两次实际方向相反。由此确认该电机在D1-B、当前接线、此前复测VM=6V条件下，两种方向都能在约75.3%固定占空比时短时启动。不是长期、整车带载或其他通道验收。

| 命令/条件 | 用户观察 |
| --- | --- |
| 固定反向满电平，STBY限时约500ms | 转约半秒 |
| 原JOG RL -128 800，含爬升 | 没动 |
| PULSE RL -128 500，约50.2%无爬升 | 没动 |
| PULSE RL -160 500，约62.7%无爬升 | 转半秒 |
| PULSE RL 160 500，约62.7%无爬升 | 没转 |
| PULSE RL ±192 500，约75.3%无爬升 | 两方向都转，方向相反 |

VM对模块GND：待机6V；75%启动时最低可能5.9V，用户保留读数不确定性。
模块GND相对降压OUT-：动力明确开启后待机0V；75%启动、电机转动时最大约0.06V。
普通万用表本次未看到显著供电或地线压降；不能排除短瞬态或认证多电机并行时表现。公共地接线本阶段不优先改动。

原程序PS2上限76/255约29.8%、JOG上限128/255约50.2%，且原路径含爬升。本轮结果支持输出设置不足以启动这台电机，是重要排查方向；不能断言唯一原因、给出精确且稳定的启动门槛或将本轮参数直接作为全车策略。正负方向在63%档表现不同，也可能受停止位置、机械负载、方向路径等影响，未作唯一归因。

### 后续顺序
1. 结束本通道重复短测，现场关闭动力电源、保留USB；断开表笔，电机先保持D1-B连接。
2. 准备允许指定轮、仍每次只驱动单轮且不超过500ms的诊断版本；先编译、再在动力关闭时烧录及检验。当前已烧录版本仍只允许PULSE RL，不能直接拿它测其他通道。
3. 用同一台已知可转电机逐一测D1-A、D2-A、D2-B，同样的6V及75%/500ms，确认两方向，保持其他电机隔离；每次改线必须全部断电。
4. 再检查各实际电机与装车转向，区分通道差异和电机/机械差异。
5. 在有负载电流和启动/维持条件证据后，再决定原控制程序的启动策略、输出上限和爬升参数。不一次性提高四轮常规上限，不以占空比当作限流。

当前最后一次串口测试已自动结束，另发STOP及STATUS确认LOCKED、STBY=0、四轮指令0，串口关闭。原PS2/JOG常规上限尚未调整。下一阶段尚未执行。

## 后续可选通道诊断程序已烧录
用户确认动力电源已关，USB保留、同一电机仍D1-B。新MecanumPS2WheelDiagnostic在ESP32 3.3.12编译成功，COM4烧录成功且哈希校验通过。动力关闭时验证四标签逐一选中且其余指令0、500ms自动结束、非法参数拒绝、重叠命令拒绝并锁定、STOP中断成功。结束STOP及STATUS确认hw=1、ps=1、buttons=0000、LOCKED、STBY=0、四轮指令0，串口关闭。未执行新版本带电机供电测试，未改原PS2/JOG常规上限。日志：docs/logs/2026-10-07/四通道诊断程序-VM关闭验证-2026-10-07.txt。下一步现场拔USB，在动力仍关闭时把同一电机从D1 BO1/BO2移至D1 AO1/AO2，恢复USB仅逻辑供电检查。
