x1shang/Chariot_strom_of_gear/docs/archive/2026-10-14-DRV8313-AS5600/snapshot/docs/diagnostics/2026-10-07/其他三个通道-同一电机对照测试.md

> 归档说明：这是 2026-10-07 按阶段追加的历史记录。早期“当前/待测”描述只适用于当时；最新状态见同目录 README.md。源码和日志的文字路径以仓库根目录为基准。此文件归档时仅整理路径，实测内容保留。

# 同一电机的其他通道对照测试
日期：2026-10-07。可选通道诊断版本已烧录、VM关闭检查通过；FL/FR/RR带电机短测尚未执行。

## 本轮目的与当前实测
同一电机在D1-B、VM约6V、固定75%/500ms时两方向都能启动且方向相反。
原JOG上限50%且含爬升，不启动；固定反向50%也不启动。
固定约63%反向可启动、正向未启动，不给出精确或通用启动阈值。
普通万用表观察到VM最低可能5.9V、地线差最大0.06V，不认证更短瞬态。
本轮用同一电机比较其他通道，不立即改整车手柄输出上限。

## 固件与规则
新源文件：firmware/chassis/MecanumPS2WheelDiagnostic/。
原队友快照和此前RL-only诊断源、已编译文件均保留。
PULSE FL/RL/FR/RR signedDuty ms，每次只指令一个通道；其他三路指令为0。
仅接受非零±1..255、50..500ms，且硬件/PS2正常、按键松开、锁定、无其他测试活动，所选通道上次输出归零至少300ms。
停止、到期、协议失效及按键按下仍撤销使能。时长为软件定时上限；不是独立硬件脉冲保证或限流功能。
PS2常规上限76和JOG上限128保持原值。

## 对应关系
| 标签 | 模块输出端 | 原GPIO控制 | 测试顺序 |
| --- | --- | --- | --- |
| RL | D1 BO1、BO2 | 18、19 | 已测，两方向75%可转 |
| FL | D1 AO1、AO2 | 16、17 | 下一项 |
| FR | D2 AO1、AO2 | 23、32 | FL结束后 |
| RR | D2 BO1、BO2 | 15、5 | FR结束后 |

## 准备、烧录、逻辑验证
1. 动力电源关闭，USB保持连接，电机目前仍接D1-B；不要改线。
2. 本地编译通过后烧录；动力仍关闭时检查非法参数拒绝、四标签一次各选一路且其他指令0、500ms到期及STOP停止。
3. 串口状态只是报告，未证明实际输出引脚波形或通道负载能力。

## 每换一个通道的现场步骤
1. 关闭动力电源并拔USB，确认转动停止。
2. 只把刚才那台电机的两根线从原模块输出端移到表中目标端；GPIO、GND、VM、VCC、PWM、STBY保持原接法。
3. 其他三台电机保持断开；待测电机/轮子放稳并可自由转动。
4. 插回USB，动力暂不打开，由助手检查锁定、STBY=0和四轮指令0。
5. 打开动力电源，确认待机不转，明确回复通电状态。
6. 助手先发一次+192/500ms（约75.3%），用户报告转/抖/没动；结束确认停止。
7. 停稳后再发一次-192/500ms，从同一观察侧比较是否相反。
8. 不自动重发，不在某一路没动时盲目提高供电或宣布模块损坏；先复核该路逻辑供电、PWM固定高电平、活动输入和输出连接。
9. 每次新改线前再次关闭动力电源并拔USB。

## 状态
新版本已通过ESP32 3.3.12编译（程序303351字节、全局变量22512字节）；COM4烧录退出0，各写入段哈希校验通过。
动力关闭时四个标签逐一接受、报告仅选中一路非零、500ms自动结束；非法参数和活动中追加命令被拒绝并锁定，STOP中断测试成功。结束再次确认LOCKED、STBY=0、四轮指令0，串口关闭。
原始日志：docs/logs/2026-10-07/四通道诊断程序-VM关闭验证-2026-10-07.txt。构建文件：build/MecanumPS2WheelDiagnostic/。
这些是协议及状态检查，不等于真实输出波形或FL/FR/RR负载验收。下一步全部断电后，把同一电机移到D1 AO1/AO2。

## D1-A准备进度
用户确认同一电机已由D1 BO1/BO2移至D1 AO1/AO2，USB恢复、动力电源仍关闭。COM4只发送STOP和STATUS，确认hw=1、ps=1、buttons=0000、LOCKED、STBY=0、四轮指令0并关闭串口。尚未执行FL带电机PULSE，下一步需现场明确开启动力并确认待机不转。

## D1-A正向75%短测已执行
用户明确确认动力已开、电机待机不转，同一电机接D1 AO1/AO2。COM4预检hw=1、ps=1、buttons=0000、LOCKED、STBY=0、四轮指令0。只发送一次PULSE FL 192 500（约75.3%、无爬升），收到接受及STBY=1、指令192,0,0,0，约500ms后自动结束。再发STOP及STATUS确认LOCKED、STBY=0、四轮指令0，关闭串口。现场是否启动待用户回报，未执行反向。日志：docs/logs/2026-10-07/FL正向75百分比带电机短测-2026-10-07.txt。

用户回报：D1-A正向75%短测转了半秒。

## D1-A反向75%短测已执行
保持同一电机、D1 AO1/AO2连接、供电和其他控制线。COM4预检正常，只发送一次PULSE FL -192 500（约75.3%、无爬升），收到接受及STBY=1、指令-192,0,0,0，约500ms后自动结束。再发STOP及STATUS确认LOCKED、STBY=0、四轮指令0，关闭串口。现场转动和物理方向是否相反待用户回报。日志：docs/logs/2026-10-07/FL反向75百分比带电机短测-2026-10-07.txt。

用户回报：D1-A反向也转了（原话“反向转了”）。结合前次正向转半秒，同一电机在D1-A、约75.3%固定占空比、500ms短测下两方向均能启动。用户按反向描述现场转动；长期和多电机负载未验证。
D1-B此前同条件双向能转且方向相反，D1两个通道已完成本轮单电机双向短测。最后一次串口测试已到期并另发STOP、STATUS确认锁定、STBY=0、四轮指令0。
下一项：全部断电后，把同一电机由D1 AO1/AO2移到第二块驱动板D2 AO1/AO2（FR，GPIO23/32），控制线和公共地保持原接法，其他电机继续断开。新固件已支持FR，不需要再烧录。当前尚未转接或执行D2-A带电机测试。

## D2-A准备进度
用户确认同一电机已移至D2 AO1/AO2，USB恢复、动力电源仍关闭。COM4只发送STOP及STATUS，确认hw=1、ps=1、buttons=0000、LOCKED、STBY=0、四轮指令0，关闭串口。尚未执行FR带电机PULSE。下一步需现场明确开启动力并确认待机不转。

## D2-A正向75%短测已执行
用户明确确认动力已开、电机待机不转，同一电机接D2 AO1/AO2。COM4预检hw=1、ps=1、buttons=0000、LOCKED、STBY=0、四轮指令0。只发送一次PULSE FR 192 500（约75.3%、无爬升），收到接受及STBY=1、指令0,0,192,0，约500ms后自动结束。再发STOP及STATUS确认LOCKED、STBY=0、四轮指令0，关闭串口。现场是否启动待用户回报，未执行反向。日志：docs/logs/2026-10-07/FR正向75百分比带电机短测-2026-10-07.txt。

用户回报：D2-A正向75%短测转了。用户提出是否直接四轮测试；已建议先完成D2-A反向及D2-B双向，因为当前用同一电机检验通道，另外三台实际电机尚未验证。随后接齐四轮架空逐轮点动，再进行联动。

## D2-A反向75%短测已执行
保持同一电机接D2 AO1/AO2及供电。COM4预检正常，只发送一次PULSE FR -192 500（约75.3%、无爬升），收到接受及STBY=1、指令0,0,-192,0，约500ms自动结束；另发STOP、STATUS确认LOCKED、STBY=0、四轮指令0，关闭串口。现场是否启动及方向是否相反待用户回报。未执行多轮联动，原PS2常规上限仍约30%。日志：docs/logs/2026-10-07/FR反向75百分比带电机短测-2026-10-07.txt。

用户回报：D2-A反向转了，且方向与正向相反。同一电机在D1-A、D1-B、D2-A三个通道均已在固定约75.3%、500ms下确认双向短时启动。长期、多轮负载及其他实际电机尚未验证。最后一次串口测试已停止、锁定且STBY=0、四轮指令0。下一项为D2-B（RR，GPIO15/5）：需全部断电后将同一电机由D2 AO1/AO2移到同板BO1/BO2。未转接或执行RR带电机测试。

## D2-B准备进度
用户确认同一电机已由D2 AO1/AO2移至D2 BO1/BO2，USB恢复、动力电源仍关闭。COM4只发送STOP及STATUS，确认hw=1、ps=1、buttons=0000、LOCKED、STBY=0、四轮指令0，关闭串口。尚未执行RR带电机PULSE。下一步需现场明确开启动力并确认待机不转。

## D2-B正向75%短测已执行
用户明确确认动力已开、电机待机不动，同一电机接D2 BO1/BO2。COM4预检hw=1、ps=1、buttons=0000、LOCKED、STBY=0、四轮指令0。只发送一次PULSE RR 192 500（约75.3%、无爬升），收到接受及STBY=1、指令0,0,0,192，约500ms后自动结束。再发STOP及STATUS确认LOCKED、STBY=0、四轮指令0，关闭串口。现场是否启动待用户回报，未执行反向。日志：docs/logs/2026-10-07/RR正向75百分比带电机短测-2026-10-07.txt。

用户回报：D2-B正向75%短测转了。

## D2-B反向75%短测已执行
保持同一电机接D2 BO1/BO2及供电。COM4预检正常，只发送一次PULSE RR -192 500（约75.3%、无爬升），收到接受及STBY=1、指令0,0,0,-192，约500ms后自动结束；另发STOP、STATUS确认LOCKED、STBY=0、四轮指令0，关闭串口。现场是否启动及方向是否相反待用户回报。日志：docs/logs/2026-10-07/RR反向75百分比带电机短测-2026-10-07.txt。

## 同一电机四通道双向短测完成
用户回报：D2-B反向转了（原话“反转了”）。结合各前次观察，同一台电机在D1-A、D1-B、D2-A、D2-B均能在约75.3%固定占空比、500ms短测下双向启动。D1-B及D2-A明确观察方向相反，D1-A、D2-B用户以反向描述现场转动。
四通道本轮未发现完全不驱动的方向；不认证其他三台实际电机、装车转向、长期负载、多轮同时启动、电源余量或原PS2常规模式已经修复。
最后一次串口点动自动结束，STOP与STATUS确认LOCKED、STBY=0、四轮指令0，串口关闭。准备进入四轮接回、架空逐轮验收阶段；当前只有同一电机接D2-B，四电机尚未接回。现有PULSE仍一次仅驱动一个通道，原PS2输出上限仍76。
