x1shang/Chariot_strom_of_gear/docs/archive/2026-10-14-DRV8313-AS5600/snapshot/docs/diagnostics/2026-10-07/诊断固件-限时占空比测试.md

> 归档说明：这是 2026-10-07 按阶段追加的历史记录。早期“当前/待测”描述只适用于当时；最新状态见同目录 README.md。源码和日志的文字路径以仓库根目录为基准。此文件归档时仅整理路径，实测内容保留。

# 限时占空比诊断固件
日期：2026-10-07。本文保留初版RL-only记录。当前板上已切换到v1.1+diag-wheels，可选四标签中的一路，VM关闭检查已通过；RL负载短测已完成，其他通道待测。

## 为什么增加这一项
同一电机在固定高低输入、GPIO33使能约500ms时可转。
恢复原PWM接法后，反向JOG -128/255、800ms（含约430ms爬升）未启动。
无电机时两方向输入均有非零变化，反向输出差分用户报告6.4V并在停止后归零。
尚不能区分启动占空比不足、软启动观察窗口不足、带电机后的电源/地压降以及其他波形或连接问题。

## 本地文件
- 原程序快照：firmware/chassis/MecanumPS2/（基准提交 c76249435cf63825123c24b832abb2f966b35686）。
- 诊断程序：firmware/chassis/MecanumPS2Diagnostic/。
- 原来源：x1shang/Chariot_strom_of_gear 的 c76249435cf63825123c24b832abb2f966b35686。
- 编译环境：本机现有Arduino CLI和ESP32核心3.3.12；经典ESP32 Dev Module目标。

## 修改范围
原GPIO分配、PS2控制、JOG上限128、PS2上限76、看门狗和投掷禁用保持原实现。
新增PULSE命令只接受RL，非零占空比±1..255，时间50..500ms。
PULSE从开始直接使用给定占空比，不含爬升；一次只驱动RL，其余三轮指令0。
需要hw正常、PS2有效且所有按键松开、控制处于锁定且没有其他点动；距离上次输出归零至少300ms。
正常主循环到期、按键输入、协议失效、STOP或非法命令都锁定并撤销STBY。
500ms是命令时长上限，不是独立硬件定时器保证；保留原1秒看门狗，不以代码审查证明看门狗或无线断联停车实物性能。

## 验证顺序（第1至3项已执行，其余待现场准备）
1. 用户关闭VM动力电源，保持USB供电；所有电机继续拆开、临时固定电平跳线已移除，原两线控制接法保持。
2. 烧录诊断版本，读取BOOT版本、STATUS及停止状态。
3. VM关闭、电机拆开时，核验非法参数被拒绝且锁定；验证有效PULSE命令限时结束。不是带电机测试。
4. 恢复电源前再次核实VM约6.0V。输出曾读6.4V，因此不能把名义6V或空载输出值当作实际加载电压。
5. 断电接回同一台已验证电机，其他电机保持隔离。分别单次测反向50%、75%、100%，每次不超过500ms；每次结束确认锁定、等待停稳，再继续下一档。不运行20秒重复脚本。
6. 50%固定平台若可转，原爬升/目标保持窗口可能是影响因素；75%或100%才转，支持本工况启动占空比高于前面条件，但不单独证明唯一根因。
7. 100%仍不转，不能盲升VM；比较输入高低电平、模块VM与地动态、电源限流/保护及输出连接，必要时使用适合的仪器。
8. 测试后保留数据，可重新编译/烧录原程序快照恢复原功能；不将诊断版PULSE作为整车运行策略。

## 当前限制
未测启动峰值电流、真实PWM波形、加载电压动态或长期温升；尚未进行诊断版固定占空比带电机测试。此前原程序配合固定满电压输入的约500ms短测可转。
不直接修改远程仓库，不宣布故障已修复。

## 编译结果
诊断程序已通过ESP32 3.3.12编译：程序303307字节（23%），全局变量22512字节（6%）。中文build路径使工具链链接失败，改用英文临时路径后成功；生成的固件文件已复制到build/MecanumPS2Diagnostic/。

## 烧录及VM关闭验证结果
用户确认动力电源关闭、USB仍连接；按此前准备电机线保持断开。COM4烧录成功，各写入段哈希校验通过，芯片ESP32-D0WD-V3。
串口确认hw=1、ps=1、buttons=0000、LOCKED、STBY=0、四轮指令0。非RL轮、占空比256/0、时长49/501ms及多余参数均拒绝并保持锁定。
VM关闭时只执行一次有效PULSE RL -128 500：报告固定指令0,-128,0,0、STBY=1，约500ms后自动结束；另发STOP和STATUS，确认LOCKED、STBY=0、四轮指令0后关闭串口。
上述验证是协议及固件状态验证，不等同于测量真实端子波形或负载停车能力。日志：docs/logs/2026-10-07/诊断程序-VM关闭验证-2026-10-07.txt。
下一步先保持电机拆开，现场测D1 VM对GND实际电压，再断电接同一电机进行单次固定占空比短测。

## 固定约75%短测现场结果及当前判断
用户回报：电机转了半秒。与本次单次500ms固定占空比指令相符。
同一电机、D1-B、原GPIO控制接法、此前复测VM=6V：固定约50.2%/500ms没动，约75.3%/500ms可转。
原程序PS2上限76/255约29.8%，JOG上限128/255约50.2%，且含爬升。这些输出设置不足以复现本次已成功的启动条件，可以解释先前测试不转；但不能据两次短测认证唯一根因、精确启动阈值、带载供电合格或其他通道正常。
本轮不追加100%测试。诊断固件仍在板上，结束时已锁定，STBY=0、四轮指令0。尚未提高PS2常规输出上限，未进行整车驱动测试。
后续先关闭动力电源、保留USB；再规划单轮启动/维持占空比与带载供电对照，不能直接把四轮上限一并提高到75%。

## 当前板上版本更新
用户确认动力电源关闭后，已烧录firmware/chassis/MecanumPS2WheelDiagnostic/版本。单次PULSE可以选择FL/RL/FR/RR，其余约束保持：一次只指令一路、无爬升、50..500ms、非零±1..255、健康PS2和松开按键、锁定/闲置及所选轮归零间隔。PS2和原JOG上限未改。
四标签选择、其余指令0、到期停止、非法命令拒绝、重叠命令锁定、STOP中断均通过VM关闭检查。当前锁定、STBY=0、四轮指令0。原RL-only源及构建文件保留；当前新源及构建文件另存。
详见其他三个通道-同一电机对照测试.md。

## 当前板上版本：校准方向及四轮短测
四台实际电机已完成逐轮双向短测，前进极性确认为{1,1,-1,-1}。在用户明确关闭动力后，已烧录MecanumPS2FourWheelDiagnostic（MecanumPS2-v1.1+diag-all），各写入段校验通过。
PULSE仍可选择一轮，最长500ms；新增ALLPULSE同时驱动四轮同一逻辑方向，非零占空比上限192/255、最长300ms，保留锁定、PS2健康/松键、输出归零间隔及停止条件。PS2和原JOG输出上限未提高。
VM关闭下已验证校准符号、四轮命令正反方向报告、限时结束、非法参数拒绝、重叠命令锁定、STOP中断、归零间隔和遥控互锁；单次主机脚本亦通过VM关闭检查。最终LOCKED、STBY=0、四轮指令0，串口关闭；带动力四轮同时启动尚未执行。
源：firmware/chassis/MecanumPS2FourWheelDiagnostic/；构建：build/MecanumPS2FourWheelDiagnostic/；验证脚本：host/verify_all_pulse_vm_off.py；单次操作：host/pulse_once.py。旧版验证脚本含旧极性/命令假设，不应用于当前板上版本。
下一步现场明确开启动力并确认架空四轮待机静止后，助手执行一次ALLPULSE 192 300并核对停止，用户反馈四轮实际启动及方向。详见四轮接回与逐轮验收-2026-10-07.md。

## 当前板上版本：命名麦轮组合，观察最长10秒
四轮300ms正反向联动已获用户确认通过。用户请求全部常用麦轮组合，并指定每种观察10秒；再次明确关闭动力后，已烧录MecanumPS2MotionDiagnostic（v1.1+diag-motion），编译及写入校验通过。
新增MOVEPULSE用于10种命名组合，占空比1..192、时长50..10000ms，沿用已校准极性和原mixMecanum。原ALLPULSE300ms、PULSE500ms、PS2上限76和JOG上限128保持。主机序列出现异常或提前停止时中止，不重试动作。
断动力验证通过10种组合及互锁边界；主机脚本通过一次完整10秒到期以及多项顺序/5秒间隔。最后LOCKED、STBY=0、四轮指令0、串口关闭。带动力10秒测试尚未执行，先现场重新开启动力并确认待机静止。
完整观察表、实现范围及验证证据见麦轮运动组合验收-2026-10-07.md；当前源和构建分别在firmware/chassis/MecanumPS2MotionDiagnostic/和build/MecanumPS2MotionDiagnostic/。
