x1shang/Chariot_strom_of_gear/docs/archive/2026-10-14-DRV8313-AS5600/snapshot/docs/diagnostics/2026-10-07/麦轮运动组合验收-2026-10-07.md

> 归档说明：这是 2026-10-07 按阶段追加的历史记录。早期“当前/待测”描述只适用于当时；最新状态见同目录 README.md。源码和日志的文字路径以仓库根目录为基准。此文件归档时仅整理路径，实测内容保留。

# 麦轮运动组合架空验收

## 已确认的基础
四台实际电机逐轮双向启动及轮位已验。四轮约75.3%占空比、300ms同时前进和后退，用户均确认四轮转动且轮胎最上方分别朝车头和车尾。车辆前进极性FL/RL/FR/RR为{1,1,-1,-1}。
降压模块可调输出此前测得约6V；图片标称单路最大5A，四轮共用该路。尚未测四轮长期电流、供电瞬态和温升。

用户请求测试所有常用组合，并将每种观察时间改为10秒。用户已确认动力关闭、USB保持连接，四轮架空。先准备和验证新程序；现场动力重新开启且四轮待机不动后，先一次10秒前进，反馈正常后再测其余组合。

## 观察表
按车辆自身左右辨认。表中“前”指轮胎最上方朝车头运动，“后”指朝车尾，“停”指电机指令0（未验证机械完全静止或主动刹车）。
组合名称沿用仓库DriveMath.h的计算方式；真实车身横移/斜行还依赖麦轮滚子安装方式、地面接触和负载，架空只能验各轮组合。

| 顺序 | 指令 | 组合 | 左前FL | 左后RL | 右前FR | 右后RR |
| --- | --- | --- | --- | --- | --- | --- |
| 1 | FWD | 前进 | 前 | 前 | 前 | 前 |
| 2 | BACK | 后退 | 后 | 后 | 后 | 后 |
| 3 | LEFT | 左横移 | 后 | 前 | 前 | 后 |
| 4 | RIGHT | 右横移 | 前 | 后 | 后 | 前 |
| 5 | FL | 左前斜行 | 停 | 前 | 前 | 停 |
| 6 | FR | 右前斜行 | 前 | 停 | 停 | 前 |
| 7 | BL | 左后斜行 | 后 | 停 | 停 | 后 |
| 8 | BR | 右后斜行 | 停 | 后 | 后 | 停 |
| 9 | CCW | 原地左转 | 后 | 后 | 前 | 前 |
| 10 | CW | 原地右转 | 前 | 前 | 后 | 后 |

## 程序范围
新源：firmware/chassis/MecanumPS2MotionDiagnostic/，保留此前所有版本。
新增MOVEPULSE命令仅接受表中10种名称、占空比1..192、时长50..10000ms，无爬升，复用原mixMecanum和已校准极性。正号名称表示相应车辆组合，不接受负占空比。
原ALLPULSE仍最多300ms、PULSE仍最多500ms；PS2上限76、JOG上限128未提高。投掷仍禁用。
需硬件正常、PS2健康且所有按键松开、锁定闲置、四轮归零至少300ms；结束、STOP、按键输入、协议失效或非法/重叠命令均停止并锁定。
10秒依赖正常软件定时，保留原1秒看门狗；不能当作独立硬件时限、电流限制或温度保护的实物认证。

主机host/motion_sequence.py只执行明确选择的组合，每项一次，不重试。每次确认接受、预期物理符号的固件报告、到期结束及最终锁定；间隔至少5秒。异常、通信/按键变化或提前停止会终止序列并尝试STOP。串口状态不是实际运动、电压、电流或温度测量。
断动力验证脚本：host/verify_motion_vm_off.py。检验10种300ms组合、非法名称/占空比/时间/多余参数、10秒请求的STOP中断、重叠/遥控/归零间隔互锁及原单轮/ALL命令约束。另用单次脚本在动力关闭时检查一次完整10秒到期。

## 现场流程
1. 四轮接线保持、全部架空可自由转动、车架稳固，手柄按键松开，动力保持关闭进行烧录和检查。
2. 助手检查完成后，用户开启动力并确认四轮待机均不动。
3. 单次10秒前进，观察四轮持续转动、方向和明显异常；若某轮卡住或出现异常，立即关闭动力，也可按手柄圆圈使程序锁定。反馈后再安排其余组合。
4. 其余组合依表顺序，每种10秒，中间至少停5秒。对照轮胎最上方观察，不凭架空时车架是否位移判定运动。
5. 全部结束后关闭动力；记录每种实际轮组、方向及异常。此阶段不落地、不提高电压、不启用持续遥控。

## 编译、烧录及断动力验证已完成
ESP32核心3.3.12编译通过：程序304947字节（23%）、全局变量22536字节（6%）；COM4烧录完成，各段写入哈希校验通过。构建另存build/MecanumPS2MotionDiagnostic/。
动力保持关闭，host/verify_motion_vm_off.py通过10种命名组合300ms报告、非法参数边界、10秒指令STOP中断、重叠/遥控/归零间隔互锁及原ALL/单轮行为检查。日志：docs/logs/2026-10-07/麦轮运动组合诊断-VM关闭验证-2026-10-07.txt。
host/motion_sequence.py断动力下执行一次完整FWD 192/10000ms，持续报告预期符号，到期约10秒后结束，最终锁定。日志：docs/logs/2026-10-07/麦轮组合脚本-完整10秒VM关闭验证-2026-10-07.txt。
同一主机脚本又在动力关闭时通过RIGHT、FL各300ms及中间5秒闲置间隔的多项顺序检查。日志：docs/logs/2026-10-07/麦轮组合脚本-顺序间隔VM关闭验证-2026-10-07.txt。
最后hw=1、ps=1、buttons=0000、LOCKED、STBY=0、四轮指令0，串口已关闭。上述是断动力下固件报告验证，没有带动力执行10秒或横移/斜行/旋转组合。
下一步用户开启动力并确认四轮待机均不动；助手先执行单次10秒前进，用户反馈四轮持续工作情况。之后安排剩余9项，每项10秒、间隔5秒；未擅自开启持续遥控。

## 首次带动力10秒前进已执行
用户明确确认“动力已开，四轮不动”。助手经COM4确认当前固件、限值、健康PS2和松键及锁定状态，留5秒观察准备后，只发送一次MOVEPULSE FWD 192 10000。
固件接受并连续报告MOVEPULSE、STBY=1、指令192,192,-192,-192；约10秒后自动结束。随后STOP和STATUS确认LOCKED、STBY=0、四轮指令0，主机脚本正常结束并关闭串口。过程中报告的PS2有效且按键0000，没有收到复位、故障或提前结束报告。
日志：docs/logs/2026-10-07/麦轮组合-前进10秒带动力-2026-10-07.txt。四轮实际是否全程持续转动、轮胎最上方是否均朝车头及现场异常待用户回报；未执行剩余9项，未据串口状态认证实际供电或温升。

## 现场异常：10秒持续四轮前进未通过
用户回报：“先是右前轮不转过了一下就只有左后轮在转了”。按原话记录，具体停轮时刻、降压显示和各供电点电压尚未观察确认。不能以主机日志中的PASS当作实物验收通过。
复核日志：整个指令期间持续报告STBY=1、四轮指令192,192,-192,-192、hw=1、ps=1、buttons=0000，约10秒到期后停止；没有收到控制器复位、软件PWM故障或PS2失效报告。这仅说明报告的指令未主动撤掉其他三轮，不能证明实际GPIO波形、驱动输出或电机供电正常。
助手已暂停其余9种组合，并立即要求用户关闭动力、保留USB；当前实体动力关闭尚待用户确认。另经COM4只发送STOP和STATUS，确认LOCKED、STBY=0、四轮指令0、PS2健康，串口关闭。日志：docs/logs/2026-10-07/麦轮10秒异常-追加停机核查-2026-10-07.txt。
不再自动执行10秒或其他运动。下一步先确认动力关闭，了解刚才降压数码管是否明显掉压、熄灭或重启；随后安排短时加载下驱动板VM与可调输出的电压对照，必要时检查动力供电分配、接点、驱动温升及电机负载。原因待实测，不能仅因先前低占空比短测失败就认定问题已全部解决。

用户随后确认“动力已关，没留意”；实体动力关闭已确认，USB保留。未获得异常期间降压显示读数。

随后用户报告：表笔已放好，动力仍关闭、USB连接时，当前读数4.87V。该读数尚未独立核实端子位置或电压来源；不能将动力开关关闭等同于D2 VM已经无电。
先暂停原定通电/2秒动作，要求保持动力关闭和表笔位置，拔掉ESP32 USB，记录拔掉后及约10秒后的读数变化，用于区分USB相关供电与其他来源；尚不能仅凭4.87V认定回供、残余电压或测点错误。未发送新运动命令。

用户反馈USB拔掉后电压缓慢归零；当前动力关闭、USB拔掉，测点已报告归零。该对照支持测点电压与USB连接相关，衰减可能含电容放电，但回供路径及测点连接尚未核实，也不能据此确定10秒停轮的根因。
检索现有本地记录未找到现场ESP32 5V/VIN至降压模块的供电连接确认。下一步在全断电下，请用户检查ESP32 5V/VIN针脚是否有线，经面包板或直接接到降压模块红色5V-OUT；只观察并反馈接法，暂不改线、不接回USB、不执行运动。

用户确认ESP32的5V/VIN针脚有线连接降压模块5V-OUT。该连线是USB相关供电的候选路径，但尚不能确定板内反向供电路径或10秒停轮根因。

后续用户按要求断开5V供电线，再仅接回USB、动力仍关闭，报告D2 VM=0V。这一对照确认该5V连接参与了先前USB相关电压路径，未确认降压模块内部具体回供机制，也不能直接认定它造成10秒停轮。当前保持该5V线断开、ESP32由USB供电、GND及其他接线保留。
助手经COM4只发送STOP、INFO、STATUS，确认v1.1+diag-motion、hw=1、ps=1、buttons=0000、LOCKED、STBY=0、四轮指令0，关闭串口。日志：docs/logs/2026-10-07/断开5V回供线-USB复接停机检查-2026-10-07.txt。
下一步保持D2 GND/VM电压测点和四轮架空，用户开启动力，报告静态VM电压及四轮待机是否均不动；确认后才单次执行2000ms四轮前进，观察最低可见电压和实际启动/停轮情况。尚未执行该动作，不恢复10秒或其他组合。
下一步在动力关闭、USB拔掉、测点已归零时，仅从降压模块5V-OUT端断开这条通往ESP32 5V/VIN的供电线，并使悬空端绝缘、远离其他针脚；GND及其他控制/逻辑/电机接线保持。表保持直流电压，黑D2 GND、红D2 VM。随后只接回USB，动力继续关闭，复测VM电压和待机轮子状态。此阶段不发送运动指令，等待用户复测反馈。是否仍有其他3.3V或接线回供路径待复测决定。
下一步先准备万用表直流电压档，黑表笔D2 GND、红表笔D2 VM，四轮保持架空、动力保持关闭。D2是右前/右后驱动板，右前是用户首先报告不转的车轮。用户确认表笔就位并提供当前读数后，再分步确认动力开启的静态电压和待机状态；之后只安排一次四轮前进约75.3%/2000ms，观察D2 VM最低读数与实际转轮情况。尚未发送这次动作。该测量只检查板上VM相对本地GND的低频可见电压，不等于排除快速跌落、地压差、控制信号或驱动输出问题。

## 断开5V回供线后的D2 VM加载对照已执行
用户确认动力开启、D2 VM=6V、四轮待机不动，原5V供电线保持断开，ESP32由USB供电。表笔黑D2 GND、红D2 VM。
助手经COM4确认固件身份、限值、PS2健康松键、锁定停机，留5秒准备后仅一次MOVEPULSE FWD 192 2000。接受、活动指令192,192,-192,-192及约2秒到期结束均确认；另STOP和STATUS确认LOCKED、STBY=0、四轮指令0，串口关闭。
日志：docs/logs/2026-10-07/断开5V回供线-D2VM测量-四轮前进2秒-2026-10-07.txt。D2 VM最低可见读数、四轮实际转动及是否中途停轮待用户回报；未执行其他组合或重新执行10秒测试。

## 2秒加载对照现场结果：最低5.6V，仅右后轮转
用户报告D2 VM最低5.6V，只有右后轮转。其他三轮是否曾短暂启动未提供细分时序，右后实际方向也未重新报告。相对同测点待机6V，可见最低读数下降约0.4V；不能据普通万用表该读数排除快速跌落、地压差或控制/驱动异常，也不能认定已定位总电源或某驱动板故障。
本次四轮联动实物未通过。5V回供线继续断开，ESP32由USB供电；上一条主机动作已结束并锁定归零，未追加运动。已要求用户测试后关闭动力，但本条反馈未单独确认实体开关状态。
下一步先关闭动力，再保持直流电压档，将黑表笔接降压模块输出GND、红表笔接D2 GND，准备检查四轮加载时地线压差。此前最大0.06V是D1单轮加载对照，不能代替本次D2四轮同时启动的测量。用户放好表笔并报告静态读数后，再确认动力开启和待机静止，才安排单次2秒加载；尚未执行。

## D2地线压差加载测量已执行
用户先确认动力关闭、黑笔降压模块输出GND/红笔D2 GND、静态0V；后确认动力开启、地线压差0V。接线保持，5V回供线断开、USB供电、四轮架空。
助手经COM4核验固件、限值、PS2健康松键及LOCKED/STBY0/四轮指令0，留5秒观察准备后，仅一次MOVEPULSE FWD 192 2000。接受、活动192,192,-192,-192、约2秒到期结束均确认；随后STOP和STATUS确认锁定归零，串口关闭。
日志：docs/logs/2026-10-07/断开5V回供线-D2地压差-四轮前进2秒-2026-10-07.txt。地线压差最大可见值及实际转轮情况待用户回报；尚未据报告指令判定地线或四轮运动通过。

## D2地线压差结果：最大可见0V，四轮均未转
用户报告地线压差0V，没有轮子转。普通万用表未显示D2 GND相对降压输出GND的明显压差，但不能排除快速瞬态、接触或其他参考点异常；也未验证D1地线。本次四轮前进仍未通过。
截至此处，断开5V回供线后两次2秒前进分别仅RR转、四轮均不转，不能视为稳定启动，也不能仅由VM最低5.6V或地差0V定位原因。固件报告活动指令正常且最后锁定归零，没有追加动作。已要求关闭动力，用户本条未独立确认实体开关状态。
下一步先确保动力关闭，准备D2 GND/VCC直流电压测点，仅测逻辑电源静态值；随后视结果核对PWMA/PWMB固定高电平及STBY，不盲目提高占空比或继续10秒组合。断开5V-OUT到ESP32供电线后，要实测各逻辑节点是否仍有原要求的3.3V，不能只据ESP32/PS2串口健康认定TB6612逻辑供电正常。

## D2逻辑电源静态读数3.3V
用户报告动力开启时D2 VCC=3.3V，并发现动力关闭时也为3.3V，USB仍接。结合断开5V回供线后USB单独供电D2 VM=0V的记录，VCC维持逻辑电源与VM动力关闭可以同时存在；不能以VCC非零判定电机动力未关闭。
VCC静态电压符合原3.3V接法，未测四轮指令期间动态值；用户本条提到开关切换，当前实体动力最终状态没有独立确认。下一步先明确关闭动力、保持USB，仅将红笔分别放D2 PWMA/PWMB，黑笔D2 GND，读取两路固定PWM使能的静态电压，预期均约3.3V。不发送运动命令，其他接线及5V回供线断开状态保持。

## D2 PWMA/PWMB静态结果符合预期
用户在要求动力关闭、USB保留的步骤后回复“符合预期”，按上下文记录D2 PWMA、PWMB均约3.3V，未提供各自精确读数。D2 VCC及两PWM固定使能的静态电压暂符合原接法，未验证实际输出或四轮动作期间的动态供电。
下一步保持动力关闭、USB供电，黑笔D2 GND、红笔D2 STBY，先记录待机电压；用户确认测点就位后，仅在动力关闭下发一次2秒四轮前进控制指令，观察D2模块针脚STBY是否由约0V升至约3.3V并在结束回0。此阶段不让电机带动力转动，不把ESP32端STATUS所报STBY当作模块针脚电压。尚未发送该指令。

## 用户询问是否因动力电压不足而升压
用户在STBY测点准备尚未确认时询问是否应升高动力电压；未调整电压或发送动作。当前建议保持原6V，先区分电压设定、加载供电能力、控制使能和启动占空比。
已有同一6V条件下单轮双向75%短测及四轮300ms正反短测成功，后续10秒与2秒联动失败，故不能直接认定6V设定本身不足。D2本地VM最低5.6V只显示约0.4V可见下降，不能排除更快瞬态；地差0V那次没有电机转，也不构成四轮真实负载下地线合格认证。
核对东芝官方TB6612FNG资料：VM推荐范围2.5..13.5V，6V在范围内；该范围不是电机额定电压许可。来源：https://toshiba.semicon-storage.com/info/docget.jsp?did=10660 。核对MPS MP2491C官方资料，其具有过流/打嗝限流、温度保护等机制，但没有证据证明本模块已触发；芯片额定参数不代替模块或实物电流测量。来源：https://www.monolithicpower.com/en/mp2491c.html 。
先继续动力关闭下模块端STBY控制信号测量。若使能及供电条件确认正常，可保持VM=6V，计划用现有PULSE的100%/不超过500ms单轮对照，判断提高启动占空比是否改善；尚未执行，不直接提高四轮占空比、连续测试时长或VM电压。原定全部运动组合仍待故障排清。

## D2 STBY模块针脚：动力关闭控制检查已执行
用户明确确认动力关闭、黑笔D2 GND/红笔D2 STBY已就位、待机STBY=0V，USB连接。助手经COM4确认固件/限值/PS2健康松键/锁定，留5秒观察准备后，仅发送一次MOVEPULSE FWD 192 2000，保持实体动力关闭。
固件接受并报告2秒活动STBY=1、四轮指令192,192,-192,-192，随后到期自动锁定；STOP及STATUS确认STBY=0、四轮指令0，关闭串口。
日志：docs/logs/2026-10-07/D2-STBY模块针脚-动力关闭控制检查-2026-10-07.txt。模块STBY实际最高电压及结束是否回0待用户回报；本次不是带动力电机测试，不能据ESP32数字状态确认模块针脚电压。

## 关键疑点：D2模块STBY全程0V
用户报告在上述动力关闭、USB供电的2秒控制检查中，D2 STBY一直0V。与同次固件报告STBY=1、四轮活动指令形成差异。若测点确为D2 STBY且接触正确，这意味着模块没有收到高电平使能，足以使D2待机，不能靠提高VM补偿；当前不能据此确认D1情况、GPIO33源头是否真正高电平、线路具体断点或唯一故障。
下一步保持动力关闭、USB连接和5V回供线断开，表笔改为ESP32 GND/实际GPIO33针脚；不拆线，先记录待机值，用户确认测点后仅在动力关闭下再发2秒控制指令，比较源头实际电压是否约3.3V。若源头高而模块低，沿GPIO33到面包板及D2 STBY线路核对；若源头也低，则进一步核对测点和GPIO输出。尚未执行该对照，不追加带动力动作。

## GPIO33源头：动力关闭使能对照已执行
用户确认表笔黑ESP32 GND、红ESP32 GPIO33源头，待机0V；沿用动力关闭、USB供电及5V回供线断开的准备状态。助手经COM4确认固件/限值/PS2健康松键/锁定，留5秒准备后仅一次MOVEPULSE FWD 192 2000。
固件接受并报告活动STBY=1、指令192,192,-192,-192，约2秒后到期结束；随后STOP和STATUS确认锁定、STBY=0、四轮指令0，关闭串口。本次无实体动力，不是电机加载测试。
日志：docs/logs/2026-10-07/GPIO33源头-动力关闭使能对照-2026-10-07.txt。GPIO33实际最高值及结束归零待用户回报；此前D2 STBY一直0V，待与本次实际源头电压比较，尚未改线或认定线路断点。

## GPIO33实测正常，重点转向STBY连接路径
用户回报GPIO33最高3.3V，结束后回0V。与上一项D2模块STBY全程0V的实测对比，支持检查GPIO33到面包板及D2 STBY之间的接线/接触或测点；两项为先后测量，未以此认证唯一故障或D1情况。
下一步保持动力关闭，拔掉USB并等待放电，万用表改电阻档；先记录两表笔短接底数，再测实际ESP32 GPIO33针脚至实际D2 STBY针脚的线路电阻，现有线保持不动。若为同一可靠直连节点，预期接近表笔底数；若超量程、kΩ或明显高阻，再核查分支插孔、杜邦线、接头和STBY测点。用户尚未报告该导通结果，暂不改线，不接回动力或执行其他组合。

## 用户补充STBY测量期间可能接头松动，先复测
用户提出刚测STBY时可能有线未接牢固，要求重试。此前D2 STBY全程0V及与GPIO33源头3.3V的差异需在接头稳定后复核，暂不据此确定断点或板故障。
原计划电阻导通检查暂缓。下一步先关闭动力并拔USB，按原插孔插牢疑似松动接头及GPIO33经面包板到D2 STBY的线路接头，不改孔位、不新增3.3V直供跳线；5V回供线继续保持断开。万用表切回直流电压，黑D2 GND、红实际D2 STBY。只恢复USB、动力仍关闭，用户确认测点和待机读数后，再发一次独立2秒控制指令复测STBY升高及归零。旧日志保留，新结果另记，尚未执行重测。

## 插牢接头后D2 STBY复测已执行
用户确认接头已插牢、动力关闭、USB连接、模块STBY待机0V。黑笔D2 GND、红笔D2 STBY，5V回供线保持断开。
助手经COM4核验固件/限值/PS2健康松键/锁定，留5秒准备后，仅一次MOVEPULSE FWD 192 2000。接受、报告2秒STBY=1和四轮指令192,192,-192,-192，到期自动结束；随后STOP及STATUS确认锁定、STBY=0、四轮指令0，串口关闭。动力全程关闭。
日志：docs/logs/2026-10-07/D2-STBY插牢接头后-动力关闭复测-2026-10-07.txt。插牢后的模块实际最高电压和结束归零待用户回报，未据此前可能接触不良的0V测量确定断点，也未执行带动力动作。

## 插牢后STBY实测恢复正常
用户报告本次D2 STBY最高3.3V、结束回0V，符合当前GPIO33源头及程序使能时序。此前可能接触不稳的D2 STBY=0V，不再作为已确定线路断开的依据。插牢动作与正常读数相关，但尚未证明此前四轮停转的唯一原因，也未实测D1 STBY。
当前动力保持关闭、USB连接、5V回供线断开、四轮架空。下一步黑笔留D2 GND、红笔移D2 VM，用户开启动力并报告静态VM及待机轮子状态后，才做一次约75.3%/2秒四轮前进，观察各轮是否持续转动与VM最低读数。电压设定保持6V，不升压，尚未执行新带动力动作。

## STBY插牢并确认正常后，带动力2秒前进复测已执行
用户明确确认动力开启、D2 VM=6V、四轮待机均不动；沿用四轮架空、USB供电、5V回供线断开、黑D2 GND/红D2 VM的测量准备。
助手经COM4核验固件/限值/PS2健康松键/锁定，留5秒观察准备后，仅一次MOVEPULSE FWD 192 2000。接受、报告STBY=1及四轮指令192,192,-192,-192、约2秒到期结束均确认；随后STOP及STATUS确认锁定、STBY=0、四轮指令0，关闭串口。
日志：docs/logs/2026-10-07/STBY接头插牢后-D2VM测量-四轮前进2秒-2026-10-07.txt。四轮是否实际均持续转动、方向及D2 VM最低值待用户回报；不以主机状态检查PASS代替实物验收，尚未恢复10秒或剩余9种运动组合。

## 四轮前进2秒观察重测已执行
用户表示上一项未看清，明确要求四轮驱动重测。助手先仅STOP/STATUS确认锁定，因上一项结束要求关闭动力而再次确认实体动力；用户明确回复动力已开。沿用四轮架空、5V回供线断开、D2 VM测点及6V设定。
仅执行一次MOVEPULSE FWD 192 2000，先核验固件和健康锁定状态、留5秒观察准备；活动STBY=1和指令192,192,-192,-192、2秒到期结束均确认。随后STOP及STATUS确认LOCKED、STBY=0、四轮指令0，主机正常结束、串口关闭。
日志：docs/logs/2026-10-07/STBY接头插牢后-四轮前进2秒观察重测-2026-10-07.txt。实际各轮转动及D2 VM最低值待用户反馈，未追加其他动作或提高电压。

## 插牢后的四轮观察重测：仍仅左后轮转，VM最低5.6V
用户反馈只有左后轮转，D2 VM最低5.6V。插牢后D2模块端STBY控制检查正常，并未使四轮75%/2秒联动稳定启动；不能将先前可能松动的接头或USB回供认定为全部故障原因。
下一步保持VM=6V、四轮架空、原电机接线不变及5V回供线断开，选右前FR单独75.3%/500ms，其他三轮指令0，用于比较单轮与四轮同时启动工况。若单轮同样失败，再按此前计划考虑单轮100%/500ms及实际输出/输入检查；不直接四轮100%或升压。
上一动作已结束锁定，用户本条未单独确认实体动力最终开关状态。现场再次确认动力开启、四轮待机静止后才执行单轮动作；尚未执行。同时通过异步问题请求真实降压输入电源的电池类型/标称电压，或适配器/台式电源额定电压电流，不能把模块标称5A当作输入源供电能力。

## 右前单轮75%/500ms对照已执行
用户明确确认动力开启、四轮待机不动；沿用四轮架空、原电机接线、VM=6V、5V回供线断开、USB供电及D2 GND/VM测点。
助手经COM4核验固件/PS2健康松键/锁定，留5秒观察准备后，仅一次PULSE FR 192 500。活动报告STBY=1、物理指令0,0,-192,0（校准后车辆前进方向），其他三轮指令0；约500ms后自动结束，STOP及STATUS确认锁定归零，串口关闭。
日志：docs/logs/2026-10-07/STBY插牢后-右前单轮75百分比500ms对照-2026-10-07.txt。右前是否实际启动、方向及D2 VM最低值待用户回报。输入动力源规格异步问题尚无答复，未执行100%或升压。

## 右前单轮能启动；输入动力源商品数据已提供
用户报告右前单轮75%/500ms转了；最低电压可能5.9V或5.6V，没看清，本次最低值记为未确认，不用于精确比较。此结果说明右前当前可在单轮工况启动，四轮同时75%/2秒却仍仅RL转，增加了检查组合启动负载与共享供电路径的必要性；不能据此确认其他三轮当前状态或唯一根因。
用户提供电源商品页面图片，清晰查看原图后可读：12V锂电池组，标签32000mAh，工作电流≤10A，带保护板、DC5521接口。仅为页面标称信息，不能认证实际容量、电池剩余电量、保护板阈值、连续/峰值供电能力或接头压降；不以此推定模块5A负载必然得到满足。已接受照片作为此前输入电源规格问题的答复。
下一步保持电机侧VM设定6V，不升压；先关闭动力输出开关，万用表保持直流20V档，表笔改到降压模块顶部蓝色双螺丝输入端子（DC6V~24V-IN）的负/正极，按丝印辨认，不靠方向猜测，不碰调压电位器。用户放稳后开启动力并报告输入静态电压与四轮待机状态，再决定一次2秒四轮加载测输入最低值。输入端在输出开关关闭时仍可能连着电池，不能把开关关闭当作输入无电；测电压时避免跨接短路。尚未执行新动作。

## 降压输入电压加载测量已执行
用户确认模块输入端静态12.24V，四轮待机不动；沿用动力开启、四轮架空、输出设定6V、5V回供线断开、USB供电，黑笔输入负极/红笔输入正极。
助手经COM4核验固件/限值/PS2健康松键/锁定，留5秒准备后，仅一次MOVEPULSE FWD 192 2000。活动STBY=1及指令192,192,-192,-192、约2秒到期结束均确认；STOP及STATUS确认锁定归零，主机正常结束、串口关闭。
日志：docs/logs/2026-10-07/四轮前进2秒-降压输入电压测量-2026-10-07.txt。输入最低可见电压及实际转轮情况待用户回报，尚不判定电池、输入线/插头或降压模块供电合格。

## 降压输入加载结果：最低12.16V，仅右前轮转
用户明确报告输入最低12.16V，只有右前轮转，并再次强调这两项结果。相对输入待机12.24V，普通万用表可见下降0.08V，本次未看到明显的输入持续掉压；不能据此排除瞬态或认证电池全部性能。四轮实物联动仍未通过。
该动作已结束锁定归零，没有因用户重复强调而再发动作。下一步测降压模块VADJ-OUT正极相对模块输出GND的静态及一次2秒加载电压，用于区别模块输出下降与输出到驱动板配电路径的压降。此前D2 VM最低5.6V与本次输入测量并非同时测得且实际转轮不同，不能直接相减当作同期线损。
先关闭动力再换电压表测点，USB保留、5V回供线保持断开、VM设定6V和四轮架空；用户将黑笔放模块输出GND、红笔黄色VADJ-OUT正极，放稳后开启动力并回报静态值及待机轮子状态，才安排一次2秒测量。尚未执行新动作，未升压或修改固件。
