x1shang/Chariot_strom_of_gear/docs/archive/2026-10-17-L298N-N20卷线抛投/README.md

# 旧抛投方案归档：L298N + 双 N20 卷线蓄力

归档日期：2026-10-17。归档原因：**用户报告上次发射装置方案已失败——卷线/蓄力机构的扭矩过大，电机被撕裂**。因此决定改用新方案：**用原驱动板（L298N）驱动两个 130 电机，做成摩擦飞轮发射装置**。旧的「2号转轴拉绳蓄力 + 1号控制电机位置实现释放」方案停止作为当前接线与操作依据。

当前方案：[双 130 摩擦飞轮接线与 GPIO 分配](../../抛投装置-双130摩擦飞轮接线与GPIO分配.md) · 新测试程序：[FlywheelSpinTest](../../../firmware/catapult/FlywheelSpinTest/README.md) · 失败记录：[卷线方案失败-电机撕裂](../../logs/2026-10-17-卷线方案失败-电机撕裂/README.md) · [当前测试程序索引](../../测试程序索引-2026-10-17.md) · [仓库总入口](../../../README.md)

## 归档范围与保留方式

`snapshot/` 按原仓库相对路径存放归档前的原始文件，内容逐字节保留（本次未做任何行尾转换）。共 **77 个文件**，分两类：

**一、旧方案的方案文件（70 个）**

| 类别 | 份数 | 内容 |
|---|---:|---|
| 测试程序源码 | 6 | `N20Motor2DirectionCheck`、`N20Motor2Reverse10s`、`N20SequenceTest` 三个固件与模块 README |
| 共用诊断程序 | 2 | `PS2SignalCheck`（遥控信号只读诊断，**不属于旧方案专用件，未停用**） |
| 主机工具 | 3 | `motor2_forward_once.py`、`motor2_counterclockwise_once.py`、`n20_sequence_once.py` |
| 主机侧仿真测试 | 4 | `test_n20_motor2_firmware.cpp`、`test_n20_motor2_reverse_firmware.cpp`、`test_n20_sequence_firmware.cpp`、`test_ps2_signal_check.cpp` |
| 接线与索引 | 2 | 归档前的 `docs/抛投装置-L298N双N20接线与GPIO分配.md` 全文、`docs/测试程序索引-2026-10-14.md` |
| 实测证据 | 53 | `docs/logs/2026-10-14-*` 六个目录（2号单次3秒 24 份、2号逆时针10秒 6 份、双电机顺序 7 份、实机抛投四项失败 2 份、遥控信号 9 份、恢复底盘 5 份） |

**二、为保持快照内链接可读而保存的链接目标（7 个，`local_link_dependency`）**

`firmware/chassis/MecanumPS2Dpad/README.md`、`firmware/chassis/MecanumPS2/README.md`、`docs/麦轮TB6612接线与面包板排线.md`、`docs/全车连接检验-GPIO与降压端子索引.md`、`docs/archive/2026-10-14-DRV8313-AS5600/README.md`、`docs/logs/2026-10-14-controller-wheel-check/README.md`，以及 `README.md`（**取自归档来源提交的版本**，因为工作区的根 README 已更新为 2026-10-17 的内容）。

**归档未包含**底盘固件源码、底盘接线以外的底盘资料与 `2026-10-14-controller-wheel-check/` 的采集文件等：它们与本次方案变更无关，仍在原位置维护。

旧固件源码、主机脚本与仿真测试**保留在原目录**用于追溯，但三个 N20 模块 README 已标注「已停用」；原接线文档路径保留为退休记录，其归档前全文以本归档快照为准。归档中所有旧接线、极性、命令与烧录指令均为历史记录，**不适用于双 130 摩擦飞轮方案**。

## 链接可解析范围（快照不是自包含站点）

- 指向**本归档文件集内部**的链接（例如旧接线文档 → 归档前的日志、索引 → 三个固件 README）在快照内可直接打开。
- 指向**未随批归档的现行文件**的链接（例如快照版根 README 的 12 个模块索引、`MecanumPS2*` 之间的互链、`2026-10-14-controller-wheel-check` 的采集文件、`docs/assets/面包板.xlsx`）在快照内**不可解析**，请到仓库原路径查看。
- 归档的目标是**逐字节保存旧方案的方案文件与证据**，不是重建一个可离线浏览的镜像；跨批引用以 `manifest.json` 的 `source_path` 为准。

## 逐字节校验

文件清单、归档来源提交与 SHA-256 见 [manifest.json](manifest.json)。`manifest.json` 的 SHA-256 是对**归档当时工作区（或来源提交）的实际字节**计算的。`.gitattributes` 对 `docs/archive/**` 显式设为 `-text`（不做行尾转换），因此这些快照在索引、检出与工作区三处字节一致。

校验方法：对每个 `snapshot_path` 逐个算 SHA-256，与 `manifest.json` 的 `sha256` 比较。

**2026-10-17 归档时复核：77 个文件，缺失 0、不一致 0。**

## 归档时的工作区事实

- 归档来源提交：`c416898c3322f1742ddfac56a54ac7db6533da7c`（归档时工作区干净）。
- 主控：ESP32-D0WD-V3 rev3.1，Flash 4MB，MAC `08:a6:f7:a8:95:94`。
- 归档当时板上固件为 `MecanumPS2Dpad`（底盘方向键），两台 N20 使能保持低。
- 归档时串口由旧记录的 **COM9 变为 COM10**（同一颗 CH340，USB ID `1a86:7523`，MAC 相同）。新测试的烧录记录以 COM10 为准。

## 旧方案为什么终止

用户报告的直接原因：**卷线/蓄力机构扭矩过大，电机被撕裂**。此前 2026-10-14 的实机试验还记录过四项失败（电池像是断路、3D 打印孔过大滑齿、卷线轴无半月形杆导致齿轮脱落、人力满行程下抛射角仍接近水平）。这些均为用户现场口述，**没有串口日志、仪器读数或照片**，不作为实测参数引用，详见[失败记录](../../logs/2026-10-17-卷线方案失败-电机撕裂/README.md)。

工程结论：把电机经齿轮与卷线轴硬联到拉绳与限位端时，机构会以堵转/冲击扭矩反作用于电机，力的上限由**机构与限位**决定，而不是由电机决定；这正是「电机被撕裂」的力学来源。摩擦飞轮方案把能量储存在飞轮转子动能里，负载是惯性负载，没有硬限位反冲，力矩受电机自身转矩—转速特性约束，从原理上避开了这一失效模式。

## 本次共保存 77 个文件（70 个方案文件 + 7 个链接目标），全部逐字节校验通过；新方案见当前接线文档与新测试程序。

导航：[新方案接线](../../抛投装置-双130摩擦飞轮接线与GPIO分配.md) · [新测试程序](../../../firmware/catapult/FlywheelSpinTest/README.md) · [方案失败记录](../../logs/2026-10-17-卷线方案失败-电机撕裂/README.md) · [当前测试程序索引](../../测试程序索引-2026-10-17.md) · [仓库总入口](../../../README.md)
