x1shang/Chariot_strom_of_gear/docs/archive/2026-10-14-DRV8313-AS5600/snapshot/docs/diagnostics/2026-10-07/四轮接回与逐轮验收-2026-10-07.md

> 归档说明：这是 2026-10-07 按阶段追加的历史记录。早期“当前/待测”描述只适用于当时；最新状态见同目录 README.md。源码和日志的文字路径以仓库根目录为基准。此文件归档时仅整理路径，实测内容保留。

# 四轮接回与逐轮验收
日期：2026-10-07。准备阶段，尚未接回或测试四台实际电机。

## 已完成
用同一台电机逐一在D1-A、D1-B、D2-A、D2-B做固定约75%/500ms短测，四通道双向都能启动。
这不等于各实际电机和装车方向已验收，也不等于四轮同步供电或整车控制已验收。
原程序PS2上限约30%、JOG约50%仍未提高，当前本地诊断PULSE可选择一个通道、一次最多500ms。

## 接回步骤
1. 关闭动力电源，拔掉USB，等电机停稳。
2. 按车辆自身左右辨认各电机，将四台电机接回下表对应输出端；沿用原两根线顺序，先不凭颜色定转向。
3. GPIO、GND、VM、逻辑供电、PWMA/PWMB和STBY保持已测试接法。
4. 四轮均悬空可自由转动、车架稳固。投掷动力保持断开。
5. 插回USB，动力暂不打开，助手只检查STOP/STATUS与锁定状态。
6. 现场明确打开动力电源并确认四轮均静止后，才执行单次点动。

| 车轮（车辆自身左右） | 标签 | 输出端 | 原控制GPIO |
| --- | --- | --- | --- |
| 左前 | FL | D1 AO1、AO2 | 16、17 |
| 左后 | RL | D1 BO1、BO2 | 18、19 |
| 右前 | FR | D2 AO1、AO2 | 23、32 |
| 右后 | RR | D2 BO1、BO2 | 15、5 |

## 逐轮短测
顺序FL、RL、FR、RR。每次只发一个75%/500ms指令，其他三轮指令0；用户报告实际哪一轮转、是否启动、是否朝车辆前进所需方向，再测相反方向。
若转错轮，先全部断电核对电机到输出端的对应，不靠改标签掩盖接错位置。
若转向与所需前进方向不符，记录后统一修正该轮极性；尚未确认前不要靠猜测改全部四轮。
若某实际电机不转，先保持已知条件检查电机/机械或连接，不因为同一参考电机可转就认定它也正常。
此阶段不运行20秒重复脚本、不启用整车持续遥控。

## 四轮联动前的条件
四台实际电机的逐轮启动及转向先通过；核对电源/降压模块可用输出电流及负载供电情况。
当前PULSE只支持选中一轮，不能把四次串口指令当作同步四轮输出，也不能把低上限PS2模式当作已修复。
之后如需四轮联动，另准备具有明确时限、停止互锁的测试实现，先编译、动力关闭时烧录及检查，再做短时架空联动，观察供电和通信。
是否修改启动策略、维持占空比及正常输出上限，依据实际四台电机和供电数据决定。

## 四台实际电机接回后的准备状态
用户确认四轮已接好并架空，USB恢复、动力电源仍关闭。COM4只发送STOP和STATUS，确认hw=1、ps=1、buttons=0000、LOCKED、STBY=0、四轮指令0并关闭串口。尚未执行各实际电机点动或四轮同时转动。下一步现场明确开启动力电源并确认四轮均不转，随后逐轮单次短测。

## 实际左前轮FL正号75%短测已执行
用户明确确认动力已开、四轮待机均不动；四台实际电机已接回且架空。COM4预检hw=1、ps=1、buttons=0000、LOCKED、STBY=0、四轮指令0。只发送一次PULSE FL 192 500（约75.3%、无爬升），收到接受及STBY=1、指令192,0,0,0，约500ms自动结束；另发STOP及STATUS确认LOCKED、STBY=0、四轮指令0，串口关闭。实际哪轮转、是否正常启动、轮胎上方朝车头还是车尾运动待用户回报；未执行其他轮或四轮联动。日志：docs/logs/2026-10-07/四轮已接回-FL正向75百分比短测-2026-10-07.txt。

用户回报：实际左前轮动了，确认轮位正确，但没注意方向。

## 实际左前轮方向辨认重测
为补方向观察，先STOP、保持锁定并留5秒观察准备；重新STATUS预检正常后，仅一次PULSE FL 192 500。接受、活动指令192,0,0,0及到期停止均确认，随后STOP和STATUS确认LOCKED、STBY=0、四轮指令0，串口关闭。轮胎上方朝车头或车尾的现场观察待回报。日志：docs/logs/2026-10-07/四轮已接回-FL正向方向辨认重测-2026-10-07.txt。

用户确认：实际左前轮正号短测时，轮胎上方往车头运动；轮位正确且正号对应车辆前进转向，FL极性暂记+1。尚未修改POLARITY。

## 实际左前轮反号75%短测已执行
保持四轮接回、架空及动力开启。先STOP并留5秒观察准备，STATUS预检正常，仅一次PULSE FL -192 500。接受、活动指令-192,0,0,0和到期停止均确认；再STOP、STATUS确认LOCKED、STBY=0、四轮指令0，关闭串口。轮位和上方是否往车尾运动待用户回报。日志：docs/logs/2026-10-07/四轮已接回-FL反向75百分比短测-2026-10-07.txt。后续单次流程保存为host/pulse_once.py，仍需现场准备确认，不能从STATUS推断实际供电或转动。

用户确认实际左前轮反号短测符合预期：仍是左前轮动，轮胎上方往车尾。FL轮位与双向已验，前进极性+1。

## 实际左后轮RL正号75%短测已执行
四轮接回、架空及动力开启保持不变。先STOP并留5秒准备，STATUS预检正常，仅一次PULSE RL 192 500。接受、活动指令0,192,0,0和到期停止均确认；再STOP、STATUS确认LOCKED、STBY=0、四轮指令0，关闭串口。实际哪轮动及轮胎上方朝车头/车尾待用户回报。日志：docs/logs/2026-10-07/四轮已接回-RL正向75百分比短测-2026-10-07.txt。

用户确认：RL正号短测实际左后轮转，轮胎上方朝车头，轮位正确，前进极性暂记+1。

## 实际左后轮RL反号75%短测已执行
状态及接线保持，先STOP并留5秒准备、STATUS预检正常后，只发送一次PULSE RL -192 500。接受、活动指令0,-192,0,0及到期停止均确认；再STOP、STATUS确认LOCKED、STBY=0、四轮指令0，串口关闭。实际左后轮反向是否符合预期待用户回报。日志：docs/logs/2026-10-07/四轮已接回-RL反向75百分比短测-2026-10-07.txt。

用户确认RL反号短测符合预期：仍为左后轮，上方朝车尾。RL轮位、双向及前进极性+1已确认。

## 实际右前轮FR正号75%短测已执行
四轮接回、架空及动力开启保持不变。先STOP并留5秒准备、STATUS预检正常后，只发送一次PULSE FR 192 500。接受、活动指令0,0,192,0及到期停止均确认；再STOP、STATUS确认LOCKED、STBY=0、四轮指令0，串口关闭。实际哪轮动及轮胎上方朝车头/车尾待回报。日志：docs/logs/2026-10-07/四轮已接回-FR正向75百分比短测-2026-10-07.txt。

用户确认FR正号短测实际为右前轮，但轮胎上方朝车尾。轮位正确，FR前进极性需-1；当前固件仍四个+1，暂未改程序或接线，待其余轮校准后统一修正。

## 实际右前轮FR反号75%短测已执行
状态及接线保持，先STOP并留5秒准备、STATUS预检正常后，仅一次PULSE FR -192 500。接受、活动指令0,0,-192,0及到期停止均确认；再STOP、STATUS确认LOCKED、STBY=0、四轮指令0，串口关闭。预计轮胎上方朝车头，现场观察待回报。日志：docs/logs/2026-10-07/四轮已接回-FR反向75百分比短测-2026-10-07.txt。

用户确认FR反号短测实际右前轮转，轮胎上方朝车头；FR轮位与双向已验，前进极性-1确认。当前源和板上POLARITY仍全+1，未统一修正。

## 实际右后轮RR正号75%短测已执行
四轮接回、架空及动力开启保持不变。先STOP并留5秒准备、STATUS预检正常后，仅一次PULSE RR 192 500。接受、活动指令0,0,0,192及到期停止均确认；再STOP、STATUS确认LOCKED、STBY=0、四轮指令0，串口关闭。实际哪轮动及轮胎上方朝车头/车尾待回报。日志：docs/logs/2026-10-07/四轮已接回-RR正向75百分比短测-2026-10-07.txt。

用户确认RR正号短测实际右后轮转，轮胎上方朝车尾。轮位正确，RR前进极性需-1。当前源及板上极性仍四个+1，尚未统一修正。

## 实际右后轮RR反号75%短测已执行
状态及接线保持，先STOP并留5秒准备、STATUS预检正常后，仅一次PULSE RR -192 500。接受、活动指令0,0,0,-192及到期停止均确认；再STOP、STATUS确认LOCKED、STBY=0、四轮指令0，串口关闭。预计实际右后轮上方朝车头，现场观察待回报。日志：docs/logs/2026-10-07/四轮已接回-RR反向75百分比短测-2026-10-07.txt。

## 四台实际电机逐轮双向与轮位校准完成
用户最后确认：RR反号测试为右后轮、轮胎上方朝车头。结合此前逐项反馈，四台实际电机各自在约75.3%、500ms单轮短测下两方向均能启动，轮位对应正确。

| 轮位/标签 | 当前程序正号时轮胎上方 | 当前程序负号时轮胎上方 | 车辆前进所需POLARITY |
| --- | --- | --- | --- |
| 左前 FL | 车头 | 车尾（用户确认符合预期） | +1 |
| 左后 RL | 车头 | 车尾（用户确认符合预期） | +1 |
| 右前 FR | 车尾 | 车头 | -1 |
| 右后 RR | 车尾 | 车头 | -1 |

当前板上MecanumPS2WheelDiagnostic的POLARITY仍为{1,1,1,1}，尚未统一修正，接线未改。拟在下一版按实测改为{1,1,-1,-1}。原PS2 CAP=76、JOG_CAP=128尚未提高；四轮同时启动/供电余量、维持占空比、整车落地和持续遥控未验证。
最后一次RR负号测试已自动结束，STOP和STATUS确认LOCKED、STBY=0、四轮指令0，串口关闭。当前动力状态仍按用户上次明确开启记载，下一步请现场关闭动力、保留USB和四轮架空/接线，以便编译/烧录准备。
已向用户请求电机降压模块型号或标称输出电流，四轮同时启动前核对；参数目前未知。

## 降压模块图片及四轮联动准备完成
用户明确确认动力已关，提供亚博智能三路降压模块的产品图片。图片标称MP2491C、输入6–24V、可调输出1.2–24V，另有5V和3.3V输出；单路最大5A，三路同时工作每路最大4.5A。官方产品资料：https://category.yahboom.net/collections/a-expansion-board/products/asrm 。
这些是产品标称参数，不是实测供电能力。四台电机共用VADJ可调通道，5A不是每台电机或每个排针各自可用的额度；电池、接线、接点、散热及四台电机启动电流仍未测。保持此前约6V设置，不增加电压或修改接线。

在动力关闭、USB连接时，已编译并烧录MecanumPS2FourWheelDiagnostic，校验通过；程序304059字节，全局变量22512字节。源与构建另存于firmware/chassis/MecanumPS2FourWheelDiagnostic/和build/MecanumPS2FourWheelDiagnostic/，保留旧版本。
新版本根据现场逐轮方向证据将POLARITY修正为{1,1,-1,-1}。新增ALLPULSE仅允许非零±1..192、50..300ms，四轮同逻辑方向、无爬升；健康PS2、按键松开、锁定闲置、四轮归零至少300ms后才接受。原PS2上限76、JOG上限128未提高。时限依赖正常软件执行，未实测独立硬件停止或无线断联性能。

动力关闭时的验证已通过：四个选中轮的校准后符号、四轮正反号指令、参数边界、到期停止、重叠命令拒绝并锁定、STOP中断、归零间隔、遥控模式互锁。日志：docs/logs/2026-10-07/四轮联动诊断-VM关闭验证-2026-10-07.txt。
更新后的host/pulse_once.py也在动力关闭时通过一次ALL 192/300ms检查，确认INFO、指令192,192,-192,-192、到期停止及最终STOP/STATUS；日志：docs/logs/2026-10-07/四轮联动-单次脚本VM关闭验证-2026-10-07.txt。
最后状态hw=1、ps=1、buttons=0000、LOCKED、STBY=0、四轮指令0，串口已关闭。这些是固件报告状态，尚未执行带动力的四轮联动。

下一步保持四轮架空、车架稳固、接线不动、PS2按键松开。用户现场开启动力并确认四轮待机均不动后，只发送一次约75.3%/300ms四轮前进指令，观察是否四轮均启动、轮胎上方是否都朝车头，以及是否复位或明显供电异常；先反馈再决定下一次测试。

## 首次带动力四轮前进短测已执行
用户明确确认“动力已开，四轮都不动”。保持四轮接好并架空，助手通过COM4先STOP、INFO并留5秒观察准备，STATUS确认hw=1、ps=1、buttons=0000、LOCKED、STBY=0、四轮指令0。
仅发送一次ALLPULSE 192 300（约75.3%、300ms、无爬升），固件接受，活动状态报告STBY=1及指令192,192,-192,-192；约300ms后自动结束并锁定。随后STOP及STATUS确认LOCKED、STBY=0、四轮指令0，串口关闭，脚本正常结束。
日志：docs/logs/2026-10-07/四轮联动-正向75百分比300ms-2026-10-07.txt。四轮是否实际均启动、轮胎最上方是否均朝车头的现场观察待用户回报；不能仅凭串口状态判定四轮联动实物通过。尚未执行四轮反向或持续测试。

用户回报：四轮都转，轮胎最上方都朝车头运动。首次架空四轮同时前进短测通过，当前校准极性与观察相符。此结果只证明本次约75.3%/300ms架空启动与方向，未验证落地负载、长期供电或持续遥控。

## 首次带动力四轮反向短测已执行
沿用用户已确认的动力开启、四轮架空及接线状态，先STOP、INFO，留5秒观察准备并确认健康锁定状态，仅一次ALLPULSE -192 300。固件接受并报告STBY=1、指令-192,-192,192,192，约300ms后自动结束；随后STOP及STATUS确认LOCKED、STBY=0、四轮指令0，串口关闭。
日志：docs/logs/2026-10-07/四轮联动-反向75百分比300ms-2026-10-07.txt。实际四轮是否都启动、轮胎最上方是否均朝车尾待用户回报，未继续其他动作。

用户确认反向短测四轮均转、轮胎最上方均朝车尾。四轮架空正反向约75.3%/300ms同时启动与方向已通过。

后续10秒四轮前进未通过：用户报告起初右前轮不转，过一会儿仅左后轮在转。程序期间持续报告四轮相应指令，没有收到复位或PS2失效报告；实物持续运行仍异常。助手已暂停其余组合、追加STOP并确认锁定归零，要求实体动力关闭，关闭状态待用户确认。详见麦轮运动组合验收-2026-10-07.md中的现场异常记录。
用户请求一次测完所有常用麦轮运动组合，随后将观察时间改为每种10秒。用户已明确再次关闭动力、USB保持连接。准备独立MecanumPS2MotionDiagnostic版本，复用现有mixMecanum，增加10种命名MOVEPULSE；仅此命令的时限扩展至10秒，旧ALLPULSE仍最多300ms，PULSE仍最多500ms。先动力关闭烧录与检查，现场开启动力待机确认后，先单次10秒前进观察持续工作，再决定其余组合。
