x1shang/Chariot_strom_of_gear/docs/archive/2026-10-14-DRV8313-AS5600/snapshot/docs/logs/2026-10-07-retest/重新烧录与四轮同时正反2秒.md

# 重新烧录后四轮同时正反 2000ms（2026-10-07）

前一轮用户已确认四轮逐轮正反转检查通过。用户随后要求重新烧录程序，测试四轮同时前进和后退各 2000ms。

使用刚才验证过的原 single-2s 构建产物，程序源码、引脚、极性和占空比不变。Arduino CLI 首次上传对相同内容跳过写入并校验，因此随后直接使用 esptool write-flash（未启用差分/跳过）重新写入 bootloader、分区表、boot_app0 和应用四段；各段 Hash of data verified，退出码 0，随后复位。

使用 host/motion_sequence.py --moves FWD BACK --duration 2000 --duty 192 --prepare 5 --gap 5。前进和后退各一次，中间停机间隔至少 5 秒，无重试。

- 前进自报 duty=192,192,-192,-192，STBY=1。
- 后退自报 duty=-192,-192,192,192，STBY=1。
- FWD：发送至到期回报 2.000s。
- BACK：发送至到期回报 2.015s。
- 脚本退出 0，命令接受、活动状态、到期与停机检查通过。
- 最终 LOCKED、STBY=0、duty=0,0,0,0；串口关闭。

原始动作日志：[simultaneous-fwd-back-2s-172816.txt](simultaneous-fwd-back-2s-172816.txt)。烧录日志为同目录 simultaneous-2s-reflash-* 和 simultaneous-2s-full-write-*。

实际四轮同时转动及方向尚待用户现场回报。串口检查通过不代表实物联动验收已通过。

## 现场结果回填

用户确认四轮同时前进、后退均成功。本轮四轮同时双向 2000ms 实物观察通过；不等于地面行驶、长时负载或原故障根因已验证。
