x1shang/Chariot_strom_of_gear/docs/小组赛时间表.xlsx

Sheet: 小组赛分组信息
 | 队伍编号 | 队伍名称 | 队长姓名 | 队长学号 | 联系方式
A组 | 55 | 不让数字归零队 | 刘翔鹤 | 526370910268 | 17703175336
 | 29 | 你的名字队 | 陈泰名 | 526021910111 | 18360152102
 | 60 | 五子登科 | 南子奥 | 526020910226 | 15901938688
 | 36 | 金鱼池队 | 夏昕杭 | 526038910536 | 18051628759
B组 | 47 | >=4队 | 朱程诣 | 526032910016 | 13771130080
 | 32 | 峡谷攻城拆迁队 | 段播旭 | 526010910060 | 18830868638
 | 69 | 噶我来啦 | 金展如 | 526700910029 | 13817453904
 | 101 | 复旦大学东川校区队 | 徐铭皓 | 526038910559 | 19921599709
C组 | 34 | 快乐烧板子队 | 崔丁 | 526038910616 | 13162851539
 | 84 | RamForce | 张皓桢 | 526038910040 | 18168895933
 | 45 | 破壁人队 | 李泽浩 | 526130910017 | 13162951976
 | 31 | 游机队 | 陆金祎 | 526021910137 | 13867480207
D组 | 86 | 机械创世队 | 王安康 | 526021910079 | 15026589588
 | 96 | 我竟无言以对队 | 谢汶举 | 526021910303 | 19137537563
 | 6 | 不翻车就队 | 闫世瞻 | 526038910721 | 18202181710
 | 104 | HUMOR队 | 穆圣杰 | 526020910022 | 17209313986
E组 | 1 | 皇家违建拆迁大队 | 冯顺之 | 526021910118 | 19015390205
 | 21 | 我和评委站一队 | 刘逸轩 | 526020910207 | 13636199976
 | 65 | 乌鲁鲁猛攻队 | 靳春晓 | 526111910165 | 13276371536
 | 44 | 韫玉 | 阮国东 | 526021910344 | 18891793627
F组 | 83 | 对的对的哦不对不队 | 张锐樊 | 526020910117 | 13250295953
 | 88 | 强的五次方队 | 张灿龙 | 326781910015 | 19542827080
 | 13 | 小动物们说的队 | 李一帆 | 526020910177 | 17717490504
 | 59 | 上交施工 | 孙一方 | 526020910073 | 19939176736
G组 | 15 | 让数字归零 | 雷家豪 | 526432910015 | 15057566332
 | 41 | 523 | 马君睿 | 526021910192 | 19317713939
 | 8 | 雷神国家队 | 邵文安霓 | 526020910240 | 15800884958
 | 70 | 焊武帝 | 张彦卓 | 526020910180 | 13097530776
H组 | 61 | 横眉冷队 | 吴禹昊 | 526031910015 | 15980504128
 | 57 | 天使研究所 | 赵宸 | 526370910043 | 18960713126
 | 28 | 望扬乘风队 | 陈展 | 526021910144 | 18870768016
 | 49 | D27-403 | 周靖峰 | 526021910091 | 18328093921
I组 | 52 | nerv | 许多 | 526020910093 | 13472522968
 | 109 | 问剑新葡京 | 李嘉宁 | 526020910259 | 18816666864
 | 56 | 焊武帝 | 黄俊儒 | 526038910640 | 17574602016
 | 27 | 疯狂星期四 | 张云楠 | 526020910098 | 18028501140
J组 | 64 | 无坚不摧队 | 庄镕诚 | 526021910108 | 18058083580
 | 26 | 来都来了队 | 赵楚宁 | 526020910145 | 13062878009
 | 93 | 临界点队 | 薛鑫钥 | 526020910048 | 15898832776
 | 43 | 交蛇战队 | 毛振港 | 526021910479 | 15158449007
K组 | 14 | 啊对对对队 | 安孟荀 | 526030910054 | 18106303007
 | 68 | 交虫战队 | 陈焓宇 | 526020910198 | 19117392087
 | 80 | 齿轮风暴队 | 肖嘉宸 | 526370910106 | 13715057040
 | 16 | 感觉很队 | 王冠清 | 526020910154 | 15021141165
L组 | 4 | 奶龙队 | 张雨禾 | 526020910268 | 17826059202
 | 62 | 干啥都队 | 麦尔瓦提·阿依丁 | 526020910244 | 18324054766
 | 66 | 机机队 | 潘逸宸 | 526020910294 | 13381531236
 | 42 | Cybertron | 朱佳乐 | 526021910267 | 15715572365
M组 | 67 | 江天一色 船见其间 | 余天翔 | 526010910031 | 18621027370
 | 12 | 交我投队 | 陈瑶闰 | 526021910019 | 15562399602
 | 92 | 塞上交子 | 张鉴 | 326781910020 | 19976515324
 | 81 | 你的胆子真是肥嘟嘟队 | 徐致远 | 526051910045 | 13310130449
N组 | 25 | 攻城梯 | 韦冠霖 | 526038910133 | 19897763681
 | 51 | 机动战士 | 刘星雨 | 526020910141 | 13916265742
 | 73 | 战至滇峰 | 张德民 | 526021910030 | 13524430510
 | 90 | 我们最帅对不队 | 张馨怡 | 526010910001 | 15888114456
O组 | 35 | 超能陆战队 | 张未然 | 526021910496 | 13540652097
 | 30 | 东川施工队 | 龚梓萱 | 526020910121 | 18692243787
 | 89 | 自定义名称4 | 邹佳宸 | 525760910005 | 13524613605
 | 24 | Valkyrie | 张飞扬 | 526020910288 | 13817393092
P组 | 17 | 听说加学分我就来了队 | 马奔 | 526038910596 | 15171313641
 | 78 | 机霸 | 陈捷 | 526451910002 | 13991381283
 | 108 | 公橙狮队 | 石昕宇 | 526020910257 | 13641850017
 | 38 | 江小白说的都队 | 江雨健 | 526021910238 | 15079313271

Sheet: 小组赛时间表
2026-10-24 |  |  |  |  | 2026-10-25
 | 队伍编号 |  |  |  |  | 队伍编号
比赛开始时间 | 场地1：A组 |  | 场地2：B组 |  | 比赛开始时间 | 场地1：I组 |  | 场地2：J组
9:00:00 | 55 | 36 | 47 | 101 | 9:00:00 | 52 | 27 | 64 | 43
9:10:00 | 29 | 60 | 32 | 69 | 9:10:00 | 109 | 56 | 26 | 93
9:20:00 | 55 | 60 | 47 | 69 | 9:20:00 | 52 | 56 | 64 | 93
9:30:00 | 36 | 29 | 101 | 32 | 9:30:00 | 27 | 109 | 43 | 26
9:40:00 | 55 | 29 | 47 | 32 | 9:40:00 | 52 | 109 | 64 | 26
9:50:00 | 60 | 36 | 69 | 101 | 9:50:00 | 56 | 27 | 93 | 43
 | 队伍编号 |  |  |  |  | 队伍编号
比赛开始时间 | 场地1：C组 |  | 场地2：D组 |  | 比赛开始时间 | 场地1：K组 |  | 场地2：L组
10:20:00 | 34 | 31 | 86 | 104 | 10:20:00 | 14 | 16 | 4 | 42
10:30:00 | 84 | 45 | 96 | 6 | 10:30:00 | 68 | 80 | 62 | 66
10:40:00 | 34 | 45 | 86 | 6 | 10:40:00 | 14 | 80 | 4 | 66
10:50:00 | 31 | 84 | 104 | 96 | 10:50:00 | 16 | 68 | 42 | 62
11:00:00 | 34 | 84 | 86 | 96 | 11:00:00 | 14 | 68 | 4 | 62
11:10:00 | 45 | 31 | 6 | 104 | 11:10:00 | 80 | 16 | 66 | 42
 | 队伍编号 |  |  |  |  | 队伍编号
比赛开始时间 | 场地1：E组 |  | 场地2：F组 |  | 比赛开始时间 | 场地1：M组 |  | 场地2：N组
14:00:00 | 1 | 44 | 83 | 59 | 14:00:00 | 67 | 81 | 25 | 90
14:10:00 | 21 | 65 | 88 | 13 | 14:10:00 | 12 | 92 | 51 | 73
14:20:00 | 1 | 65 | 83 | 13 | 14:20:00 | 67 | 92 | 25 | 73
14:30:00 | 44 | 21 | 59 | 88 | 14:30:00 | 81 | 12 | 90 | 51
14:40:00 | 1 | 21 | 83 | 88 | 14:40:00 | 67 | 12 | 25 | 51
14:50:00 | 65 | 44 | 13 | 59 | 14:50:00 | 92 | 81 | 73 | 90
 | 队伍编号 |  |  |  |  | 队伍编号
比赛开始时间 | 场地1：G组 |  | 场地2：H组 |  | 比赛开始时间 | 场地1：O组 |  | 场地2：P组
15:20:00 | 15 | 70 | 61 | 49 | 15:20:00 | 35 | 24 | 17 | 38
15:30:00 | 41 | 8 | 57 | 28 | 15:30:00 | 30 | 89 | 78 | 108
15:40:00 | 15 | 8 | 61 | 28 | 15:40:00 | 35 | 89 | 17 | 108
15:50:00 | 70 | 41 | 49 | 57 | 15:50:00 | 24 | 30 | 38 | 78
16:00:00 | 15 | 41 | 61 | 57 | 16:00:00 | 35 | 30 | 17 | 78
16:10:00 | 8 | 70 | 28 | 49 | 16:10:00 | 89 | 24 | 108 | 38
