x1shang/Chariot_strom_of_gear/docs/排位赛比赛成绩.xlsx

编号 | 队伍名称 | 队长姓名 | 最终总分 | 备注
55 | 不让数字归零队 | 刘翔鹤 | 4010
47 | >=4队 | 朱程诣 | 3280
34 | 快乐烧板子队 | 崔丁 | 2310
86 | 机械创世队 | 王安康 | 2295
1 | 皇家违建拆迁大队 | 冯顺之 | 2220
83 | 对的对的哦不对不队 | 张锐樊 | 2170
15 | 让数字归零 | 雷家豪 | 1765
61 | 横眉冷队 | 吴禹昊 | 1730
52 | nerv | 许多 | 1630
64 | 无坚不摧队 | 庄镕诚 | 1595
14 | 啊对对对队 | 安孟荀 | 1415
4 | 奶龙队 | 张雨禾 | 1360
67 | 江天一色 船见其间 | 余天翔 | 1315
25 | 攻城梯 | 卢冠霖 | 1140
35 | 超能陆战队 | 张未然 | 1120
17 | 听说加学分我就来了队 | 马奔 | 1070
78 | 机霸 | 陈捷 | 970
30 | 东川施工队 | 龚梓萱 | 945
51 | 机动战士 | 刘星雨 | 890
12 | 交我投队 | 陈瑶闽 | 850
62 | 干啥都队 | 麦尔瓦提·阿依丁 | 805
68 | 交虫战队 | 陈焓宇 | 790
26 | 来都来了队 | 赵楚宁 | 585
109 | 问剑新葡京 | 李嘉宁 | 580
57 | 天使研究所 | 赵宸 | 565
41 | 523 | 马君睿 | 550
88 | 强的五次方队 | 张灿龙 | 525
21 | 我和评委站一队 | 刘逸轩 | 490
96 | 我竟无言以对队 | 谢汶举 | 480 | 瞭望塔420分
84 | RamForce | 张皓桢 | 480 | 瞭望塔0分
32 | 峡谷攻城拆迁队 | 段播旭 | 475
29 | 你的名字队 | 陈泰名 | 470
60 | 五子登科 | 南子奥 | 465
69 | 噶我来啦 | 金展如 | 435
45 | 破壁人队 | 李泽浩 | 425
6 | 不翻车就队 | 闫世瞻 | 365
65 | 乌鲁鲁猛攻队 | 靳春晓 | 285
13 | 小动物们说的队 | 李一帆 | 280
8 | 雷神国家队 | 邵文安霓 | 265
28 | 望扬乘风队 | 陈展 | 260
56 | 焊武帝 | 黄俊儒 | 250
93 | 临界点队 | 薛鑫钥 | 230
80 | 齿轮风暴队 | 肖嘉宸 | 190 | 中央区及甬道180分
66 | 机机队 | 潘逸宸 | 190 | 中央区及甬道150分
92 | 塞上交子 | 张鉴 | 175 | 中央区及甬道170分
73 | 战至滇峰 | 张德民 | 175 | 中央区及甬道150分
89 | 自定义名称4 | 邹佳宸 | 160
108 | 公橙狮队 | 石昕宇 | 140
38 | 江小白说的都队 | 江雨健 | 135
24 | Valkyrie | 张飞扬 | 130 | 中央区及甬道140分
90 | 我们最帅对不队 | 张馨怡 | 130 | 中央区及甬道80分
81 | 你的胆子真是肥嘟嘟队 | 徐致远 | 130 | 中央区及甬道40分
42 | Cybertron | 朱佳乐 | 130 | 中央区及甬道30分
16 | 感觉很队 | 王冠清 | 120
43 | 交蛇战队 | 毛振港 | 115
27 | 疯狂星期四 | 张云楠 | 100
49 | D27-403 | 周靖峰 | 90 | 中央区及甬道90分
70 | 焊武帝 | 张彦卓 | 90 | 中央区及甬道80分
59 | 上交施工 | 孙一方 | 90 | 中央区及甬道60分
44 | 韫玉 | 阮国东 | 75 | 外城30分
104 | HUMOR队 | 穆圣杰 | 75 | 外城0分
31 | 游机队 | 陆金祎 | 70
101 | 复旦大学东川校区队 | 徐铭皓 | 60 | 中央区及甬道30分
36 | 金鱼池队 | 夏昕杭 | 60 | 中央区及甬道20分
87 | 机姬爆小队 | 虞文伟 | 45
85 | 攻城狮战队 | 叶庆涛 | 30
9 | 肯德基械队 | 贺原俊 | 15
18 | 26417队 | 李名扬 | 15
98 | 锐械创客 | 徐志衡 | 10
100 | 四区兄弟 | 别宇宸 | 10
99 | 荒野执火者 | 杨璐菲 | 5
2 | 咸鱼翻身队 | 刘启航 | 0
3 | 机械队 | 刘城慷 | 0
19 | 一起搞机械队 | 项一恒 | 0
46 | 间隙旅行者 | 吴孜晨 | 0
63 | 江江队 | 孙俊健 | 0
91 | 萝卜开会 | 范雅桐 | 0
102 | 邪恶叮叮车 | 董杰 | 0
105 | 泥头车队 | 金楠 | 0
107 | 铁血暴力军团 | 周哲弘 | 0
71 | 五条骛 | 张礼君 | -5
95 | 随机应队 | 朱晗瑞 | -5
10 | 虚约束队 | 秦子钧 | -10
39 | 破阵子·攻城槌 | 翟文嵩 | -15
94 | 啊对对队 | 赵凯悦 | -20
11 | 16H2队 | 朱丝丝 | -30
33 | 衡朔天工队 | 兰青林 | -75
5 | 共同电子队 | 金家宇 | 弃赛
7 | 电机小子队 | 李煜宸 | 弃赛
20 | 2032 | 张何元 | 弃赛
22 | 亚洲飞人队 | 孙旭洋 | 弃赛
23 | 南洋机造队 | 王雪涵 | 弃赛
37 | 从容应队 | 应镕 | 弃赛
40 | 啊对对队 | 胡海容 | 弃赛
48 | 复旦说的都队 | 温涛宁 | 弃赛
50 | 憧憬成为机械圣体 | 吴轶超 | 弃赛
53 | 对对队 | 仇育展 | 弃赛
54 | 破壁者 | 梁凯涛 | 弃赛
58 | 与世Woo争 | 任星翰 | 弃赛
72 | 广告位招租 | 姜逸冉 | 弃赛
74 | 吉克耶格尔掷弹兵团 | 陈俊翰 | 弃赛
75 | Spirit | 李逸羽 | 弃赛
76 | 睡个大懒觉 | 黄晋淇 | 弃赛
77 | 高数的主人 | 任怡雯 | 弃赛
79 | 三带一队 | 尚文卿 | 弃赛
82 | 扭矩即正义队 | 徐浩然 | 弃赛
97 | 肥嘟嘟奶龙队 | 汪彧 | 弃赛
103 | 啊对吗？啊不队 | 姜皓之 | 弃赛
106 | 据说队伍名越长越吉利对不队 | 于千城 | 弃赛
