x1shang/Chariot_strom_of_gear/docs/logs/2026-10-17-integrated-v2-validation/README.md

# ChariotIntegrated-v2软件验证

日期：2026-10-17。以远程`master`提交`9a11db22ac06d6c2f64c0cb23fb420198a7165ef`的MecanumPS2Flywheel-v2为控制逻辑基线；具体来源和差异见[仓库对齐说明](../../整合程序v2-仓库对齐说明.md)。

- 主机侧检查：见[host-tests.txt](host-tests.txt)的实际通过数量；增加右摇杆死区、比例、正反转、方向叠加、回中解锁、数字模式忽略尾部、模拟/数字切换、启动及静止协商报文、驾驶与R2飞轮并行、停车送球门控。
- ESP32实际编译：FQBN `esp32:esp32:esp32`，Arduino-ESP32 3.3.12，见[compile.txt](compile.txt)。
- `verification.json`保存新源码、测试、编译脚本及日志SHA-256。v1记录单独保留，本次不沿用旧计数或旧源码哈希。

仍覆盖飞轮1.2秒爬升/10秒时限、提前按叉不排队、单次送球/松R2中断、N20点动/冷却间隔、失联/急停、舵机范围/STOP保持、时间回绕、PWM写入与初始化失败。

**没有烧录、打开串口、运行电机或舵机。** `pretime=1`是时间门槛，`turn`是摇杆换算指令、舵机`us`是脉宽，均非实测速度/角度。电机电流、温升、N20行程、飞轮转速和舵机安全范围仍需按[施工说明](../../发射装置改接线-从拔线到验收-2026-10-17.md)验证。
