x1shang/Chariot_strom_of_gear/docs/logs/2026-10-17-integrated-validation/README.md

# ChariotIntegrated-v1 软件验证记录

> 本目录保留v1历史结果。当前源码已按远程仓库更新为v2，最新验证见[新记录](../2026-10-17-integrated-v2-validation/README.md)，不能用本目录334项计数或旧哈希代替v2结果。

日期：2026-10-17。适用新接线：飞轮共同EN=14，TB3 N20 AIN1/AIN2/STBY=25/26/22，舵机S=27，GPIO21预留；底盘和PS2原映射保留。

- 主机仿真：MSVC C++17，**334项检查通过**，见[原始输出](host-tests.txt)。模拟Arduino和PS2帧，包含满输出255写入/256回读情况；没有连接串口或电机。
- 原底盘测试：`tests/run-dpad-tests.cmd`通过，原轮极性、中立、释放停止、失联、反向等待及时间回绕测试仍通过。
- 实际ESP32编译：FQBN `esp32:esp32:esp32`，Arduino-ESP32 **3.3.12**；最终编译详情见[编译输出](compile.txt)。受限沙箱下编译器最初报DLL重定位错误，随后正常权限仅编译成功；不是源码编译错误。
- 代码与文本交付：见本目录`verification.json`，记录程序/测试源码SHA-256及编译/仿真结果。桌面交付包另有逐文件`SHA256SUMS.txt`。

## 覆盖的行为

启动按键保持不能直接运动、连续中立解锁、底盘极性/停止/换向等待；双飞轮软启动、单次10秒上限、松键停、早按送球不排队、按住不自动连发、N20限时/双向点动/间隔；行驶发射冲突锁定、无效或间断PS2帧/STOP停机、未知命令/缓冲溢出；舵机默认禁用、显式开启、脉宽边界、STOP冻结目标、独立频率；时间回绕、初始化及运行PWM失败，PWM停机写入失败时解除外设并尝试拉低引脚。

## 没有验证的事情

**本次未烧录、未打开串口、未运行任何电机或舵机。** 编译与仿真只证明源码能够构建及模拟条件下的控制行为，不能证明实际接线、电平波形、电机电流/温升、飞轮转速、送球数量、机构到位、舵机角度或平台扭矩。

默认预转2500ms、送球150ms/30%、间隔800ms、舵机1400–1600µs都需要现场标定。当前没有到位/转速/角度传感器接入，`pretime=1`不是实测转速，脉冲结束不是到位，舵机`us`不是角度。

当前旧硬件验收仍来自改线前的独立飞轮固件，不能沿用于新整合接线。请按[逐根线施工说明](../../发射装置改接线-从拔线到验收-2026-10-17.md)先逻辑检查、再分别加动力。
