x1shang/Chariot_strom_of_gear/docs/archive/2026-10-17-L298N-N20卷线抛投/snapshot/docs/logs/2026-10-14-throw-test/README.md

# 2026-10-14 抛投机构实机测试：四项失败记录

日期：2026-10-14。测试性质：**用户现场人工试验（实弹/整机）**。

本轮**没有串口日志、没有仪器读数、没有照片**。下面四项全部是用户现场观察与口头判断，按原意归档，尚未被主机或仪表复核。本文件是记录，不是实测数据。

导航：[仓库总入口](../../../README.md) · [当前抛投接线](../../抛投装置-L298N双N20接线与GPIO分配.md) · [同日2号电机测试记录](../2026-10-14-n20-motor2-check/README.md) · [旧方案归档](../../archive/2026-10-14-DRV8313-AS5600/README.md)

机器可读的报告原件：[user-report.json](user-report.json)（四项问题的原话、已知项、未验证项、证据边界）。

## 1. 用户报告原文

> 今天发现几个问题：
> 1 电池坏了（像是断路），只能直连电源
> 2 3D打印的孔太大，齿轮一直会滑齿，加限位器失败
> 3 没有半月形杆齿轮在线轴上会滑动，导致齿轮脱落，且无法安回去
> 4 就算人力把杆子拉满，抛射初始角度也是平的，过不了城墙

用户同时说明这次尝试的结果是"绝望的发现"，即本轮试验未能达成可用的抛射。

## 2. 四项问题分类与记录

| 编号 | 现象（用户报告） | 类别 | 影响 | 证据等级 |
|---|---|---|---|---|
| 1 | 电池坏，像是断路；只能直连电源 | 电气 / 供电 | 整机不能靠电池供电运行 | 用户现场观察 + 推断 |
| 2 | 3D 打印孔太大，齿轮一直滑齿；加限位器失败 | 机械 / 加工与装配 | 齿轮传动不可靠，带载即打滑 | 用户现场观察 |
| 3 | 没有半月形杆，齿轮在卷线轴上滑动并脱落，无法装回 | 机械 / 轴与轮毂连接 | 卷线轴总成当前不可用 | 用户现场观察 |
| 4 | 人力把杆拉满，抛射初始角度仍是平的，过不了城墙 | 机构几何 / 设计 | 即使传动完好也达不到抛射要求 | 用户现场观察 |

四项中：1 项供电、2 项机械加工与装配、1 项抛射几何。**第 4 项不依赖前 3 项修好**——它是几何/设计问题，不是零件故障。

## 3. 每项的已知与未知（不要把未知写成已测）

### 3.1 电池断路（编号 1）

- 已知：用户判断电池"像是断路"，车辆只能直连电源工作。
- 未知：坏的是电芯、保护板还是接插件；是否只是保护板跳闸后未复位。**没有**开路电压、端电压、内阻或导通测量；**没有**确认断点在电池本体还是线束/插头。
- 本仓库此前记录过两块不同用途的动力分支（新 N20 的 12V 分支、底盘独立分支），以及一块 2026-10-07 记录的 12V 锂电池组（标称 32000mAh、工作电流 ≤10A、带保护板，仅商品页标称）。**未确认**本次判定损坏的是哪一块，不在此之前做归属推断。

### 3.2 3D 打印孔过大导致滑齿（编号 2）

- 已知：打印件的孔偏大，齿轮啮合时会打滑（滑齿）；用户尝试加限位器，未成功。
- 未知：孔径实测值、轴的实测直径、齿轮齿数与模数、材料与打印参数；"限位器"的具体形式与其失效方式。
- 未确认滑齿的直接原因：可能是孔大导致齿轮偏心、啮合中心距不对、齿形强度不足或装配同轴度差，本轮不能唯一归因到孔径。

### 3.3 缺半月形杆（D 形轴）导致齿轮脱落（编号 3）

- 已知：卷线轴是圆轴（无半月形/D 形切面），齿轮在轴上沿轴向滑动，最终脱落；用户反馈**无法装回**。
- 未知：齿轮内孔是否已被磨圆、卡簧/挡圈/紧定螺钉是否缺失或损坏、轴是否已弯曲或磨损。
- 结论边界：可确认的现象是"轴向固定缺失导致脱落"，具体是紧固方式缺失还是零件已损坏，尚未拆检确认。

### 3.4 抛射初始角度为平（编号 4）

- 已知：用人力把杆拉到极限，抛射的初始角度仍接近水平，用户判定过不了城墙。
- 未知：实测角度、抛射杆臂长、转轴高度、限位/停止位置、绳长与挂钩释放点；城墙的目标高度与距离本轮也未记录。
- 这一条说明：**现有几何在满蓄力条件下仍达不到要求的角度**，因此不是靠加大电机力矩或修好齿轮能解决的。

## 4. 证据边界

- 本文件全部内容为**用户口述的现场观察**，没有串口记录、万用表读数、视频或照片支撑，不能作为实测数据引用。
- 不得据本轮结论修改任何供电标称值（12V、VM、电流）：编号 1 只是"电池不可用"的现象，不是被测得的电气参数。
- 不得据本轮结论认定 N20、L298N 或底盘模块损坏：本轮没有对它们做电气测量。
- 编号 2/3 的零件尺寸与编号 4 的角度都**未测量**，因此不能写成"孔大了 N 毫米""角度是 M 度"。

## 5. 待用户补充（补齐后即可升级为实测记录）

1. 电池：断开负载后用万用表测电池输出端子直流电压；确认是否保护板保护、插头/线束是否导通。
2. 打印件：实测孔径（mm）、配合轴径（mm）、齿轮齿数与模数、限位器做法，附照片。
3. 卷线轴：轴、齿轮、脱落部位的照片；确认齿轮内孔是否已磨圆、紧固件是否丢失。
4. 抛射几何：臂长、转轴高度、限位角度、目标城墙高度与距离，以及"平"的目视大致角度。
5. 本轮是否更换过任何零件、是否已拆装复原。

照片按仓库惯例可放入 `docs/assets/` 并在本文件引用。

## 6. 同日程序与数据记录核对（本轮未新增）

本轮试验**没有**编译、烧录或修改任何固件，也没有产生串口日志；因此没有需要新归档的程序或数据。同日已有的程序与数据核对结果如下，均已完整入档。

**程序（均为 2026-10-14 新增，同日完成）**

| 文件 | 说明 | 哈希记录 |
|---|---|---|
| `firmware/catapult/N20Motor2DirectionCheck/N20Motor2DirectionCheck.ino` | 板上固件 v2，只允许 2 号电机一次 3 秒电气正转 | SHA-256 `c21f1dad…17d8c82`，与 `verification.json` 的 `source_sha256` 逐字节一致 |
| `firmware/catapult/N20Motor2DirectionCheck/README.md` | 引脚、命令、互锁与安全边界 | — |
| `host/motor2_forward_once.py` | 主机侧单次执行工具 | SHA-256 `b1cadd80…7d683ae` |
| `tests/test_n20_motor2_firmware.cpp` | 主机侧仿真测试 | SHA-256 `bd29f969…892ceef` |
| `docs/抛投装置-L298N双N20接线与GPIO分配.md` | 当前接线与 GPIO 分配依据 | — |

**数据**

| 目录 | 内容 | 份数 |
|---|---|---|
| [2026-10-14-n20-motor2-check](../2026-10-14-n20-motor2-check/README.md) | 芯片信息、v1/v2 软件检查与上传、静止回读异常、拔跳帽复查、6 次独立 3 秒正转与各自复位记录、`verification.json` | 20 个文件 |
| [2026-10-14-controller-wheel-check](../2026-10-14-controller-wheel-check/README.md) | 手柄与四轮现场检查：5 份串口采集、状态统计、远程源码比对 | 8 个文件 |
| [archive/2026-10-14-DRV8313-AS5600](../../archive/2026-10-14-DRV8313-AS5600/README.md) | 旧方案快照归档 | `manifest.json` 记录 126 个文件，逐个 SHA-256 校验：缺失 0、不一致 0 |

归档的 45 个文本快照原本是 CRLF，会被仓库通用的「文本归一化为 LF」规则改写，克隆后 `manifest.json` 就对不上了。本次已在 `.gitattributes` 中对 `docs/archive/**` 显式设为 `-text`（不做行尾转换），并按该规则重新入库后复验：**126 个文件的索引字节与 `manifest.json` 的 SHA-256 全部一致**，即克隆后仍可逐字节复验。详见[归档说明](../../archive/2026-10-14-DRV8313-AS5600/README.md)。

**结论：同日的程序源码、主机脚本、仿真测试与全部原始串口证据均已入档，且哈希可复验。** 唯一未纳入版本库的是 `docs/2026新生机械赛赛事手册.pdf`，归档说明中已声明它不属于本次归档、保持原状。

## 7. 受影响的下游文档

- [仓库总入口 §6 当前阻塞](../../../README.md)：已加入机械加工、轴连接与抛射几何三项。
- [抛投装置接线文档](../../抛投装置-L298N双N20接线与GPIO分配.md)：已记录电池分支不可用与机构待重做。
