x1shang/Chariot_strom_of_gear/docs/archive/2026-10-14-DRV8313-AS5600/snapshot/docs/assets/_ocr_result.txt

============================================================
02cec176d8672e7d400d2b986632414d.jpg
============================================================
8.8.8.
8E
48
-2
R31
100  WRI5  TmR19
VADJ-OUT  6V~24V-IN
GR8
5V-OUT
VM
NO  ::3V3-0
6R8
GND  口  OFF  AHDOON  15  JP01

============================================================
203057240cc96969cc30a48af07484ad.jpg
============================================================
260911  00
3018714A_P2-

============================================================
60d4df2088c4f4ae2b890196908f64bf.jpg
============================================================
5  口  A
7R2  R3  RI
UCC接SU不牌R  C2  C1

============================================================
8d026409f15da554c0698b05e2c8f11a.jpg
============================================================
GNDIFLT  NI
EMI  LNI2NI
O  13018714A_P1-260702
n九2~2:B00
3

============================================================
a9c2a7ad0204ca2d75682873badeca4e.jpg
============================================================
HAA
a00
O
G23
S25
C03

============================================================
cc612679d195754dd7da25badf9ae344.jpg
============================================================
型号  2804单电机  支持FOC/SPWM/SVPWM/方波等/可用Simplefoc/ODrive/VESC/DengFOC/电调无刷电机驱动器
槽极数  槽数12/极数14  12N14P
极对数  7对
适用电压  额定电压12V  7. 4-16VDC
定子直径  28mm
定子高度  4 mm 
内转子轴径  8mm
轴芯中孔  中空轴（可穿/可过线）  5. 4-6. 5mm
电机尺寸  加径向磁铁总高19.5mm  34. 5X15mm
电机重量  37g
绕线电阻  5.10
相电阻Rs  2.3Q
电流1A以内温升正常  额定电流  0.5A
最大电流  电流1A以内温升正常  2A 
KV值  220
转速  2600RPM/12V
绕线电感   2. 8mH
相电感Ls  0. 86mH
扭矩  电流和控制方式不同扭矩也不同  300g.cm(0.03NM)
0~45℃  工作温度
钦铁硼强磁  工艺  多极充磁磁场均匀高精度低波动

============================================================
d4184f2874bcdc8fea3b3960f6a12dfb.jpg
============================================================
编码器的SDA和SCL引I脚，需按程
云芯电机  序指定引脚接到MCU，VCC接MCU
的3.3V接5V去掉R3，GND接GND。  AS5600编码器反
面
直流电源接入  电机三相线直接  8.2~24v
和驱动板的端子对  正负区分  →插不分线序  驱动板反面丝印
-[32-23  08.2
驱动板上的in1-  in3，需按McU的  芯电
程序指定引脚接，  EN使能引脚需按  程序指定引脚接，
FLT不接，GND接  MCU的GND
MCU主控制器  接电脑USB
ESP32-S3
