x1shang/Chariot_strom_of_gear/(commit log)

2026-10-14 入档 2026-10-14：旧抛投方案归档、L298N 双 N20 测试与实机抛投四项失败记录
    归档与文档重组
    - 归档 DRV8313 + 2804 + AS5600 旧方案：126 个原始文件快照 + manifest.json
    逐个 SHA-256。为使克隆后仍可逐字节复验，.gitattributes 对 docs/archive/**
    显式设为 -text（该批文本快照本为 CRLF，原会被归一化为 LF 而破坏校验）；
    按新规则重新入库后复验 126/126 一致。
    - README 与共享文档改为「导航 + 归档索引」，旧方案原文完整保留在快照中。
    新方案程序与测试
    - 新增 firmware/catapult/N20Motor2DirectionCheck（v2，2号电机单次3秒电气正转、
    GPIO 回读互锁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
2026-10-17 方案变更 2026-10-17：卷线方案失败（扭矩过大撕裂电机），改用原驱动板驱动双 130 摩擦飞轮
    用户报告上次的发射装置方案（L298N + 双 N20 卷线蓄力）已失败，原因是扭矩太大、
    电机被撕裂；决定改为用原驱动板 L298N 驱动两个 130 电机做摩擦飞轮发射装置。
    - 归档旧方案：三个 N20 固件与模块 README、主机脚本、主机侧仿真测试、接线文档与
    2026-10-14 全部证据（六个日志目录），共 77 个文件（70 个方案文件 + 7 个链接目标），
    manifest.json 逐个 SHA-256 校验：缺失 0、不一致 0；来源提交 c416898
    - 旧接线文档改为退休记录，三个 N20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
2026-10-17 入档补充 2026-10-17：把会话外的飞轮重测原始日志正式归档，并同步全部计数与状态
    - 保留会话之外执行的第二次 30% / 3000ms 转动记录 retest-spin-once.txt（无 FAULT/ERR，
    爬升 16 个采样 DUTY1=DUTY2 由 5 单调升到 73，HOLD raw 77 保持 24 个采样，
    DONE elapsed=3000），并在测试记录里写明它由会话之外的操作发出、两次之间板子被手动复位
    - verification.json 改记 run_command_count_by_this_session=1、total_spin_commands_observed=2，
    并新增 retest_log 与 retest_note
    - 总入口 README、接线文档与测试程序索引同步为「两次 30% 空载转动测试」
2026-10-17 test: flying wheel option
2026-10-17 feat: make steering controllable via the right bar on ps2
2026-10-18 feat: integrate R1 docking and fix duty-independent PWM checks
2026-10-18 feat: add bounded N20 duty diagnostics and record unresolved motor fault
2026-10-18 test: locate N20 start duty threshold at 65-75 percent on COM9
    Run bounded JOG pulses at 100/50/65/75 percent with power connected and the
    N20 unloaded; user observed 100/75 turn, 50 dead, 65 marginal. Mark the two
    earlier 100 percent runs invalid because motor power was not connected, and
    reclassify the fault from 'no motion' to 'start duty too low': FEED_PERCENT=30
    cannot start the motor.
2026-10-18 feat: raise bounded jog limit to 3000ms and verify loaded N20 at 80 percent
    The 500ms ceiling blocked the requested loaded 3s pulse, so FEED_JOG_MAX_MS
    becomes 3000 with the static_assert, host script cap, and 3001ms boundary
    tests updated together. The host script also gains --loaded-confirmed so a
    loaded powered jog no longer has to be declared unloaded.
    Flashed to COM9 (esp32:esp32@3.3.12) and ran JOG 1 3000 80 with the mechanism
    attached: 204/255 duty, timed stop, fault=none, mechanism driven. Cfg::VERSION
    was deliberately not bumped, so provenance is the recorded source hashes.
2026-10-18 feat: R1 alternates direction per tap, 1750ms at 80 percent
    Each accepted R1 tap now runs the N20 for FEED_PULSE_MS (1750ms) at
    FEED_PERCENT (80%) and arms the opposite direction for the next tap; rejected
    taps (cooldown, parking, ramp, enable) leave the pending direction untouched,
    and serial JOG never participates in the alternation. STATUS exposes N20next
    and N20last so alternation can be checked from telemetry, and VERSION becomes
    v3.4-R1ALT after the unbumped v3.3 diagnostics build.
    Duty moves 30 -> 80 percent because the bench sweep showed 30/50 percent never
    started the motor, 65 percent only shuddered, and 80 percent drove the loaded
    mechanism for 3 seconds. Tests: 822 host checks;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
2026-10-18 feat: give the two R1 directions different durations (3000ms and 1750ms)
    The user wants the up direction to run 3s, but which physical direction is up
    is not yet identified, so the first tap direction (+1) arbitrarily gets
    FEED_PULSE_MS_FORWARD=3000 and (-1) keeps FEED_PULSE_MS_REVERSE=1750. A
    static_assert now forbids the two from being equal so the difference cannot be
    lost silently. STATUS reports the pending duration through N20ms when idle,
    which makes the alternation visible without a stopwatch.
    Host checks: 827. Compile: clean. NOT flashed: the CH340 port disappeared
    before upload, so the board still runs v3.4-R1ALT.
2026-10-18 feat: hold TRIANGLE to raise and CROSS to lower the N20 mechanism
    The right cluster was never used for the mechanism: TRIANGLE (bit 12) was
    undefined and CROSS (bit 14) had been idle since v3, so both are free while the
    left D-pad keeps driving the chassis.
    Holding TRIANGLE now runs the up direction at 80% and holding CROSS the down
    direction; releasing stops immediately, TRIANGLE wins if both are held, and a
    hold that reaches FEED_HOLD_MAX_MS (3000) stops and latches until both buttons
    are released. Hold runs never consume the R1 alternation slot. STATUS exposes
    N20hold, and CROSS no longer starts a timed pulse.
    Version v3.6-HOLDUD. Host checks 867; flashed to COM9 with hash verification.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
2026-10-18 docs: add a project history retrospective through 2026-10-18
    Summarizes the merge/reorg, the mecanum bring-up setbacks, both retired
    catapult designs (burned DRV8313 and the torn-motor coiling rig), the flywheel
    pivot, and the 2026-10-18 N20 investigation. Every setback is recorded as
    symptom, method, root cause, fix, and residual risk, with the evidence class
    kept explicit.
